bluerobotics/ping-dev-kit/ping_dev_kit_stm32h563_pinout.xlsx

Sheet: Alternate Functions
Use? | Pin Function | UFBGA169 | Net | GPIO | Additional Function | AF0 | AF1 | AF2 | AF3 | AF4 | AF5 | AF6 | AF7 | AF8 | AF9 | AF10 | AF11 | AF12 | AF13 | AF14 | AF15 | Notes
FALSE | l |  |  | - |  | - | - | - | - | - | - | - | - | - | - | - | - | - | - | - | -
TRUE | NRST | H3 | nRST | - | 0 | - | - | - | - | - | - | - | - | - | - | - | - | - | - | - | -
FALSE | PA0 | K3 |  | GPIO | ADC12_INP0, ADC12_INN1, TAMP_IN2,TAMP_OUT1, WKUP1 |  |  | TIM5_CH1 | TIM8_ETR | TIM15_BKIN | SPI6_NSS | SPI3_RDY | USART2_CTS/ USART2_NSS | UART4_TX | SDMMC2_CMD | SAI2_SD_B | ETH_MII_CRS | - | - | TIM2_ETR | EVENTOUT
TRUE | PA1 | H5 | MAC.REF_CLK | GPIO | ADC12_INP1, TAMP_IN5,TAMP_OUT4 | - | TIM2_CH2 | TIM5_CH2 | - | TIM15_CH1N | LPTIM1_IN1 | OCTOSPI1_DQS | USART2_RTS | UART4_RX | OCTOSPI1_IO3 | SAI2_MCLK_B | ETH_MII_RX_CLK/ ETH_RMII_REF_CLK | - | - | - | EVENTOUT
TRUE | PA10 | E11 | USART1.RX | GPIO | - | - | TIM1_CH3 | - | LPUART1_RX | LPTIM2_IN2 | - | UCPD1_FRSTX | USART1_RX | - | FDCAN2_TX | - | - | SDMMC1_D0 | DCMI_D1/PSSI_D1 | - | EVENTOUT
FALSE | PA11 | C13 |  | GPIO | - | - | TIM1_CH4 | - | LPUART1_CTS | - | SPI2_NSS/I2S2_WS | UART4_RX | ART1_NSS | - | FDCAN1_RX | USB_DM | - | - | - | - | EVENTOUT
FALSE | PA12 | B13 |  | GPIO | - | - | TIM1_ETR | - | LPUART1_RTS | - | SPI2_SCK/I2S2_CK | UART4_TX | USART1_RTS | SAI2_FS_B | FDCAN1_TX | USB_DP | - | - | - | - | EVENTOUT
TRUE | PA13(JTMS/SWDIO) | D12 | SWDIO | GPIO | - | JTMS/SWDIO | - | - | - | - | - | - |  | - | - | - | - | - | - | - | EVENTOUT
TRUE | PA14(JTCK/SWCLK) | C10 | SWCLK | GPIO | - | JTCK/SWCLK | - | - | - | - | - | - |  | - | - | - | - | - | - | - | EVENTOUT
FALSE | PA15(JTDI) | B10 |  | GPIO | - | JTDI | TIM2_CH1 | LPTIM3_IN2 | - | HDMI_CEC | SPI1_NSS/I2S1_WS | SPI3_NSS/I2S3_WS | SPI6_NSS | UART4_RTS | - | - | UART7_TX | FMC_NBL1 | DCMI_D11/PSSI_D11 | TIM2_ETR | EVENTOUT
TRUE | PA2 | L3 | MAC.MDIO | GPIO | ADC12_INP14, TAMP_IN4,TAMP_OUT3, WKUP2 | - | TIM2_CH3 | TIM5_CH3 | - | TIM15_CH1 | LPTIM1_IN2 | - | USART2_TX | SAI2_SCK_B | - | - | ETH_MDIO | - | - | - | EVENTOUT
TRUE | PA3 | K4 | AUX_ANALOG | GPIO | ADC12_INP15 | - | TIM2_CH4 | TIM5_CH4 | OCTOSPI1_CLK | TIM15_CH2 | SPI2_NSS/I2S2_WS | SAI1_SD_B | USART2_RX | - | - | - | ETH_MII_COL | - | - | - | EVENTOUT
TRUE | PA4 | M4 | TX_SIG | GPIO | DAC1_OUT1, ADC12_INP18 | - | - | TIM5_ETR | LPTIM2_CH1 | - | SPI1_NSS/I2S1_WS | SPI3_NSS/I2S3_WS | USART2_CK | SPI6_NSS | - | - | - | - | DCMI_HSYNC/PSSI_DE | - | EVENTOUT
TRUE | PA5 | J5 | MOTOR_VREF | GPIO | ADC12_INP19, ADC12_INN18, DAC1_OUT2 | - | TIM2_CH1 | - | TIM8_CH1N | - | SPI1_SCK/I2S1_CK | - |  | SPI6_SCK | - | - | ETH_MII_TX_EN/ ETH_RMII_TX_EN | - | PSSI_D14 | TIM2_ETR | EVENTOUT
TRUE | PA6 | N4 | VTX_SENSE | GPIO | ADC12_INP3 | - | TIM1_BKIN | TIM3_CH1 | TIM8_BKIN | - | SPI1_MISO/I2S1_SDI | OCTOSPI1_IO3 | USART11_TX | SPI6_MISO | TIM13_CH1 | - | - | - | DCMI_PIXCLK/PSSI_PDCK | - | EVENTOUT
TRUE | PA7 | K5 | MAC.CRSDV | GPIO | ADC12_INP7, ADC12_INN3 | - | TIM1_CH1N | TIM3_CH2 | TIM8_CH1N | - | SPI1_MOSI/I2S1_SDO | - | USART11_RX | SPI6_MOSI | TIM14_CH1 | OCTOSPI1_IO2 | ETH_MII_RX_DV/ ETH_RMII_CRS_DV | FMC_SDNWE | FMC_NWE | - | EVENTOUT
FALSE | PA8 | E10 |  | GPIO | - | MCO1 | TIM1_CH1 | - | TIM8_BKIN2 | I2C3_SCL | SPI1_RDY | - | USART1_CK | - | - | USB_SOF | UART7_RX | FMC_NOE | DCMI_D3/PSSI_D3 | - | EVENTOUT
TRUE | PA9 | F13 | USART1.TX | GPIO | UCPD1_DB1 | - | TIM1_CH2 | - | LPUART1_TX | I2C3_SMBA | SPI2_SCK/I2S2_CK | - | USART1_TX | - | - | - | ETH_MII_TX_ER | FMC_NWE | DCMI_D0/PSSI_D0 | - | EVENTOUT
FALSE | PB0 | N5 |  | GPIO | ADC12_INP9, ADC12_INN5 | - | TIM1_CH2N | TIM3_CH3 | TIM8_CH2N | - | - | OCTOSPI1_IO1 | USART11_CK | UART4_CTS | - | - | ETH_MII_RXD2 | - | - | LPTIM3_CH1 | EVENTOUT
FALSE | PB1 | H6 |  | GPIO | ADC12_INP5 | - | TIM1_CH3N | TIM3_CH4 | TIM8_CH3N | - | - | OCTOSPI1_IO0 | - | - | - | - | ETH_MII_RXD3 | - | - | LPTIM3_CH2 | EVENTOUT
TRUE | PB10 | K9 | MAC.RXER | GPIO | - | - | TIM2_CH3 | LPTIM3_CH1 | LPTIM2_IN1 | I2C2_SCL | SPI2_SCK/I2S2_CK | - | USART3_TX | - | OCTOSPI1_NCS | - | ETH_MII_RX_ER | - | - | - | EVENTOUT
TRUE | PB11 | L10 | MAC.TXEN | GPIO | - | - | TIM2_CH4 | - | LPTIM2_ETR | I2C2_SDA | SPI2_RDY | SPI4_RDY | USART3_RX | - | - | - | ETH_MII_TX_EN/ ETH_RMII_TX_EN | FMC_NBL1 | - | - | EVENTOUT
TRUE | PB12 | K11 | MAC.TXD0 | GPIO | - | - | TIM1_BKIN | - | OCTOSPI1_NCLK | I2C2_SDA | SPI2_NSS/I2S2_WS | UCPD1_FRSTX | USART3_CK | - | FDCAN2_RX | - | ETH_MII_TXD0/ ETH_RMII_TXD0 | - | - | UART5_RX | EVENTOUT
FALSE | PB13 | K12 |  | GPIO | UCPD1_CC1 | - | TIM1_CH1N | LPTIM3_IN1 | LPTIM2_CH1 | I2C2_SMBA | SPI2_SCK/I2S2_CK | - | USART3_CTS/USART3_NSS | - | FDCAN2_TX | - | - | SDMMC1_D0 | - | UART5_TX | EVENTOUT
FALSE | PB14 | J10 |  | GPIO | UCPD1_CC2 | - | TIM1_CH2N | TIM12_CH1 | TIM8_CH2N | USART1_TX | SPI2_MISO/I2S2_SDI | - | USART3_RTS | UART4_RTS | SDMMC2_D0 | - | - | - | - | LPTIM3_ETR | EVENTOUT
TRUE | PB15 | H10 | MAC.TXD1 | GPIO | PVD_IN | RTC_REFIN | TIM1_CH3N | TIM12_CH2 | TIM8_CH3N | USART1_RX | SPI2_MOSI/I2S2_SDO |  | USART11_CTS/USART11_NSS | UART4_CTS | SDMMC2_D1 | OCTOSPI1_CLK | ETH_MII_TXD1/ ETH_RMII_TXD1 | - | DCMI_D2/PSSI_D2 | UART5_RX | EVENTOUT
TRUE | PB2 | N6 | OCTOSPI1.DQS | GPIO | LSCO | RTC_OUT2 | - | SAI1_D1 | TIM8_CH4N | SPI1_RDY | LPTIM1_CH1 | SAI1_SD_A | SPI3_MOSI/I2S3_SDO | - | OCTOSPI1_CLK | OCTOSPI1_DQS | - | SDMMC1_CMD | LPTIM5_ETR | - | EVENTOUT
FALSE | PB3(JTDO/TRACESWO) | F6 |  | GPIO | - | JTDO/TRACESWO | TIM2_CH2 | - | - | I2C2_SDA | SPI1_SCK/I2S1_CK | SPI3_SCK/I2S3_CK | UART12_CTS/UART12_NSS | SPI6_SCK | SDMMC2_D2 | CRS_SYNC | UART7_RX | - | - | LPTIM6_ETR | EVENTOUT
FALSE | PB4(NJTRST) | A5 |  | GPIO | - | NJTRST | TIM16_BKIN | TIM3_CH1 | OCTOSPI1_CLK | LPTIM1_CH2 | SPI1_MISO/I2S1_SDI | SPI3_MISO/I2S3_SDI | SPI2_NSS/I2S2_WS | SPI6_MISO | SDMMC2_D3 | - | UART7_TX | - | DCMI_D7/PSSI_D7 | - | EVENTOUT
TRUE | PB5 | E6 | OCTOSPI1.CLK- | GPIO | - | - | TIM17_BKIN | TIM3_CH2 | OCTOSPI1_NCLK | I2C1_SMBA | SPI1_MOSI/I2S1_SDO | I2C4_SMBA | SPI3_MOSI/I2S3_SDO | SPI6_MOSI | FDCAN2_RX | - | ETH_PPS_OUT | FMC_SDCKE1 | DCMI_D10/PSSI_D10 | UART5_RX | EVENTOUT
TRUE | PB6 | C6 | FDCAN2_TX | GPIO | - | - | TIM16_CH1N | TIM4_CH1 | I3C1_SCL | I2C1_SCL | HDMI_CEC | I2C4_SCL | USART1_TX | LPUART1_TX | FDCAN2_TX | OCTOSPI1_NCS | - | FMC_SDNE1 | DCMI_D5/PSSI_D5 | UART5_TX | EVENTOUT
FALSE | PB7 | D6 |  | GPIO | WKUP5 | - | TIM17_CH1N | TIM4_CH2 | I3C1_SDA | I2C1_SDA | - | I2C4_SDA | USART1_RX | LPUART1_RX | FDCAN1_TX | SDMMC2_D5 | SDMMC2_CKIN | FMC_NL | DCMI_VSYNC/PSSI_RDY | - | EVENTOUT
TRUE | PB8 | F5 | I2C1.SCL | GPIO | - | - | TIM16_CH1 | TIM4_CH3 | I3C1_SCL | I2C1_SCL | SPI4_RDY | I2C4_SCL | SDMMC1_CKIN | UART4_RX | FDCAN1_RX | SDMMC2_D4 | ETH_MII_TXD3 | SDMMC1_D4 | DCMI_D6/PSSI_D6 | - | EVENTOUT
TRUE | PB9 | E5 | I2C1.SDA | GPIO | - | - | TIM17_CH1 | TIM4_CH4 | I3C1_SDA | I2C1_SDA | ++ | I2C4_SDA | SDMMC1_CDIR | UART4_TX | FDCAN1_TX | SDMMC2_D5 | SDMMC2_CKIN | SDMMC1_D5 | DCMI_D7/PSSI_D7 | - | EVENTOUT
TRUE | PC0 | J2 | TX_ISENSE | GPIO | ADC12_INP10 | - | TIM16_BKIN | - | - | - | - | SAI1_MCLK_A | SPI2_RDY | SAI2_FS_B | FMC_A25 | OCTOSPI1_IO7 | - | FMC_SDNWE | - | - | EVENTOUT
TRUE | PC1 | J3 | MAC.MDC | GPIO | ADC12_INP11, ADC12_INN10, TAMP_IN3,TAMP_OUT5, WKUP6 | TRACED0 | - | SAI1_D1 | - | - | SPI2_MOSI/I2S2_SDO | SAI1_SD_A | USART11_RTS | SAI2_SD_A | SDMMC2_CK | OCTOSPI1_IO4 | ETH_MDC | - | - | - | EVENTOUT
FALSE | PC10 | A10 |  | GPIO | - | - | - | LPTIM3_ETR | - | - | - | SPI3_SCK/I2S3_CK | USART3_TX | UART4_TX | OCTOSPI1_IO1- | - | ETH_MII_TXD0/ ETH_RMII_TXD0 | SDMMC1_D2 | DCMI_D8/PSSI_D8 | - | EVENTOUT
FALSE | PC11 | A9 |  | GPIO | - | - | - | LPTIM3_IN1 | - | - | - | SPI3_MISO/I2S3_SDI | USART3_RX | UART4_RX | OCTOSPI1_NCS | - | - | SDMMC1_D3 | DCMI_D4/PSSI_D4 | - | EVENTOUT
FALSE | PC12 | D9 |  | GPIO | - | TRACED3 | - | TIM15_CH1 | - | - | SPI6_SCK | SPI3_MOSI/I2S3_SDO | USART3_CK | UART5_TX | - | - | - | SDMMC1_CK | DCMI_D9/PSSI_D9 | - | EVENTOUT
FALSE | PC13 | E3 |  | GPIO | TAMP_IN1,TAMP_OUT2,RTC_OUT1,TAMP_OUT3, WKUP4, RTC_TS | - | - | - | - | - | - | - | - | - | - | - | - | - | - | - | EVENTOUT
FALSE | PC14(OSC32_IN) | D1 |  | GPIO | OSC32_IN | - | - | - | - | - | - | - | - | - | - | - | - | - | - | - | EVENTOUT
FALSE | PC15(OSC32_OUT) | E1 |  | GPIO | OSC32_OUT | - | - | - | - | - | - | - | - | - | - | - | - | - | - | - | EVENTOUT
FALSE | PC2 | K1 |  | GPIO | ADC12_INP12, ADC12_INN11 | PWR_CSLEEP | TIM17_CH1 | TIM4_CH4 | - | - | SPI2_MISO/I2S2_SDI | OCTOSPI1_IO5 | - | - | OCTOSPI1_IO2 | - | ETH_MII_TXD2 | FMC_SDNE0 | - | - | EVENTOUT
FALSE | PC3 | K2 |  | GPIO | ADC12_INP13, ADC12_INN12 | PWR_CSTOP | - | SAI1_D3 | LPTIM3_CH1 | - | SPI2_MOSI/I2S2_SDO | OCTOSPI1_IO6 | - | - | OCTOSPI1_IO0 | - | ETH_MII_TX_CLK | FMC_SDCKE0 | - | - | EVENTOUT
TRUE | PC4 | L5 | MAC.RXD0 | GPIO | ADC12_INP4 | - | TIM2_CH4 | SAI1_CK1 | LPTIM2_ETR | - | I2S1_MCK | - | USART3_RX | - | - |  | ETH_MII_RXD0/ ETH_RMII_RXD0 | FMC_SDNE0 | - | - | EVENTOUT
TRUE | PC5 | M5 | MAC.RXD1 | GPIO | ADC12_INP8, ADC12_INN4 | - | TIM1_CH4N | SAI1_D3 | - | PSSI_D15 | - | SAI1_FS_A | UART12_RTS | - | - | OCTOSPI1_DQS | ETH_MII_RXD1/ ETH_RMII_RXD1 | FMC_SDCKE0 | - | - | EVENTOUT
FALSE | PC6 | F10 |  | GPIO | - | - | - | TIM3_CH1 | TIM8_CH1 | - | I2S2_MCK | SAI1_SCK_A | USART6_TX | SDMMC1_D0DIR | FMC_NWAIT | SDMMC2_D6 | OCTOSPI1_IO5 | SDMMC1_D6 | DCMI_D0/PSSI_D0 | - | EVENTOUT
FALSE | PC7 | F11 |  | GPIO | - | TRGIO | - | TIM3_CH2 | TIM8_CH2 | - | - | I2S3_MCK | USART6_RX | SDMMC1_D123DIR | FMC_NE1 | SDMMC2_D7 | OCTOSPI1_IO6 | SDMMC1_D7 | DCMI_D1/PSSI_D1 | - | EVENTOUT
TRUE | PC8 | E9 | FDCAN_STB | GPIO | - | TRACED1 | - | TIM3_CH3 | TIM8_CH3 | - | - | - | USART6_CK | UART5_RTS | FMC_NE2/FMC_NCE | FMC_INT | FMC_ALE | SDMMC1_D0 | DCMI_D2/PSSI_D2 | - | EVENTOUT
TRUE | PC9 | F12 | MAC_REF_CLK | GPIO | UCPD1_DB2 | MCO2 | - | TIM3_CH4 | TIM8_CH4 | I2C3_SDA | AUDIOCLK | - | - | UART5_CTS | OCTOSPI1_IO0 | - | FMC_CLE | SDMMC1_D1 | DCMI_D3/PSSI_D3 | - | EVENTOUT
TRUE | PD0 | C9 | AUX | GPIO | - | - | - | - | TIM8_CH4N | - | - | - | - | UART4_RX | FDCAN1_RX | - | UART9_CTS | FMC_D2/FMC_AD2 | - | - | EVENTOUT
TRUE | PD1 | B9 | TX_2X_ATT | GPIO | - | - | - | - | - | - | - | - | - | UART4_TX | FDCAN1_TX | - | - | FMC_D3/FMC_AD3 | - | - | EVENTOUT
FALSE | PD10 | K13 |  | GPIO | - | - | - | - | LPTIM2_CH2 | - | - | - | USART3_CK | - | - | - | - | FMC_D15/FMC_AD15 | - | - | EVENTOUT
FALSE | PD11 | H8 |  | GPIO | - | - | - | SAI1_CK1 | LPTIM2_IN2 | I2C4_SMBA | - | - | USART3_CTS/USART3_NSS | UART4_RX | OCTOSPI1_IO0 | SAI2_SD_A | - | FMC_A16/FMC_CLE | - | - | EVENTOUT
TRUE | PD12 | H11 | TX_PWM_A | GPIO | - | - | LPTIM1_IN1 | TIM4_CH1 | LPTIM2_IN1 | I2C4_SCL | I3C1_SCL | SAI1_D1 | USART3_RTS | UART4_TX | OCTOSPI1_IO1 | SAI2_FS_A | - | FMC_A17/FMC_ALE | DCMI_D12/PSSI_D12 | - | EVENTOUT
FALSE | PD13 | G8 |  | GPIO | - | - | LPTIM1_CH1 | TIM4_CH2 | LPTIM2_CH1 | I2C4_SDA | I3C1_SDA | - | - | - | OCTOSPI1_IO3 | SAI2_SCK_A | UART9_RTS | FMC_A18 | DCMI_D13/PSSI_D13 | LPTIM4_IN1 | EVENTOUT
TRUE | PD14 | H12 | TX_PWM_B | GPIO | - | - | - | TIM4_CH3 | - | - | - | - | - | UART8_CTS | - | - | UART9_RX | FMC_D0/FMC_AD0 | - | - | EVENTOUT
TRUE | PD15 | G10 | TGC_RST | GPIO | - | - | - | TIM4_CH4 | - | - | - | - | - | UART8_RTS | - | - | UART9_TX | FMC_D1/FMC_AD1 | - | - | EVENTOUT
TRUE | PD2 | E8 | TX_EN | GPIO | WKUP7 | TRACED2 | - | TIM3_ETR | - | TIM15_BKIN | - | - | - | UART5_RX | - | - | - | SDMMC1_CMD | DCMI_D11/PSSI_D11 | LPTIM4_ETR | EVENTOUT
TRUE | PD3 | C8 | TX_10X_ATT | GPIO | WKUP8 | - | - | - | - | - | SPI2_SCK/I2S2_CK | - | USART2_CTS/USART2_NSS | - | - | - | - | FMC_CLK | DCMI_D5/PSSI_D5 | - | EVENTOUT
TRUE | PD4 | D8 | TX_DAMP | GPIO | - | - | - | - | - | - | - | - | USART2_RTS | - | - | OCTOSPI1_IO4 | - | FMC_NOE | - | - | EVENTOUT
FALSE | PD5 | A7 |  | GPIO | - | - | TIM1_CH4N | - | - | - | SPI2_RDY | - | USART2_TX | - | FDCAN1_TX | OCTOSPI1_IO5 | - | FMC_NWE | - | - | EVENTOUT
FALSE | PD6 | F7 |  | GPIO | - | - | - | SAI1_D1 | - | - | SPI3_MOSI/I2S3_SDO | SAI1_SD_A | USART2_RX | - | - | OCTOSPI1_IO6 | SDMMC2_CK | FMC_NWAIT | DCMI_D10/PSSI_D10 | - | EVENTOUT
FALSE | PD7 | B7 |  | GPIO | - | - | - | - | - | - | SPI1_MOSI/I2S1_SDO | - | USART2_CK | - | - | OCTOSPI1_IO7 | SDMMC2_CMD | FMC_NE1/FMC_NCE | - | LPTIM4_OUT | EVENTOUT
FALSE | PD8 | J11 |  | GPIO | - | - | - | - | - | - | - | - | USART3_TX | - | - | - | - | FMC_D13/FMC_AD13 | - | - | EVENTOUT
TRUE | PD9 | H9 | FDCAN2_RX | GPIO | - | - | - | - | - | - | - | - | USART3_RX | - | FDCAN2_RX | - | - | FMC_D14/FMC_AD14 | - | - | EVENTOUT
FALSE | PE0 | D5 |  | GPIO | - | - | LPTIM1_ETR | TIM4_ETR | LPTIM2_CH2 | LPTIM2_ETR | - | SPI3_RDY | - | UART8_RX | FDCAN1_RX | SAI2_MCLK_A | - | FMC_NBL0 | DCMI_D2/PSSI_D2 | - | EVENTOUT
FALSE | PE1 | C5 |  | GPIO | - | - | LPTIM1_IN2 | - | - | - | - | - | - | UART8_TX | FDCAN1_TX | - | - | FMC_NBL1 | DCMI_D3/PSSI_D3 | - | EVENTOUT
TRUE | PE10 | L8 | OCTOSPI1.IO7 | GPIO | - | - | TIM1_CH2N | - | - | - | - | UART12_TX | UART7_CTS | - | - | OCTOSPI1_IO7 | - | FMC_D7/FMC_AD7 | - | - | EVENTOUT
TRUE | PE11 | M8 | OCTOSPI1.NCS | GPIO | - | - | TIM1_CH2 | - | - | SPI1_RDY | SPI4_NSS | OCTOSPI1_NCS | - | - | - | SAI2_SD_B | - | FMC_D8/FMC_AD8 | - | - | EVENTOUT
TRUE | PE12 | M9 | OCTOSPI1.RST | GPIO | - | - | TIM1_CH3N | - | - | - | SPI4_SCK | - | - | - | - | SAI2_SCK_B | - | FMC_D9/FMC_AD9 | - | - | EVENTOUT
FALSE | PE13 | K8 |  | GPIO | - | - | TIM1_CH3 | - | - | - | SPI4_MISO | - | - | - | - | SAI2_FS_B- | - | FMC_D10/FMC_AD10 | - | - | EVENTOUT
FALSE | PE14 | J9 |  | GPIO | - | - | TIM1_CH4 | - | - | - | SPI4_MOSI | - | - | - | - | SAI2_MCLK_B- | - | FMC_D11/FMC_AD11 | - | - | EVENTOUT
FALSE | PE15 | L9 |  | GPIO | - | - | TIM1_BKIN | - | TIM1_CH4N | - | - | - | USART10_CK | - | - | - | - | FMC_D12/FMC_AD12 | - | - | EVENTOUT
TRUE | PE2 | C3 | OCTOSPI1.IO2 | GPIO | - | TRACECLK | LPTIM1_IN2 | SAI1_CK1 | - | - | SPI4_SCK | SAI1_MCLK_A | USART10_RX | UART8_TX | OCTOSPI1_IO2 | - | ETH_MII_TXD3 | FMC_A23 | DCMI_D3/PSSI_D3 | - | EVENTOUT
FALSE | PE3 | D4 |  | GPIO | TAMP_IN6,TAMP_OUT3 | TRACED0 | - | - | - | TIM15_BKIN | - | SAI1_SD_B | USART10_TX | - | - | - | - | FMC_A19 | - | - | EVENTOUT
FALSE | PE4 | D3 |  | GPIO | TAMP_IN7,TAMP_OUT8 | TRACED1 | - | SAI1_D2 | - | TIM15_CH1N | SPI4_NSS | SAI1_FS_A | - | - | - | - | - | FMC_A20 | DCMI_D4/PSSI_D4 | - | EVENTOUT
FALSE | PE5 | C2 |  | GPIO | TAMP_IN8,TAMP_OUT7 | TRACED2 | - | SAI1_CK2 | - | TIM15_CH1 | SPI4_MISO | SAI1_SCK_A | - | - | - | - | - | FMC_A21 | DCMI_D6/PSSI_D6 | - | EVENTOUT
FALSE | PE6 | D2 |  | GPIO | TAMP_IN3,TAMP_OUT6 | TRACED3 | TIM1_BKIN2 | SAI1_D1 | - | TIM15_CH2 | SPI4_MOSI | SAI1_SD_A | - | - | - | SAI2_MCLK_B | - | FMC_A22 | DCMI_D7/PSSI_D7 | - | EVENTOUT
FALSE | PE7 | L7 |  | GPIO | - | - | TIM1_ETR | - | - | - | - | UART12_RTS | UART7_RX | - | - | OCTOSPI1_IO4 | - | FMC_D4/FMC_AD4 | - | - | EVENTOUT
TRUE | PE8 | J8 | OCTOSPI1.IO5 | GPIO | - | - | TIM1_CH1N | - | - | - | - | UART12_CTS/UART12_NSS | UART7_TX | - | - | OCTOSPI1_IO5 | - | FMC_D5/FMC_AD5 | - | - | EVENTOUT
TRUE | PE9 | N8 | OCTOSPI1.IO6 | GPIO | - | - | TIM1_CH1 | - | - | - | - | UART12_RX | UART7_RTS | - | - | OCTOSPI1_IO6 | - | FMC_D6/FMC_AD6 | - | - | EVENTOUT
FALSE | PF0 | E2 |  | GPIO | - | - | - | - | - | I2C2_SDA | - | - | - | - | - | - | - | FMC_A0 | LPTIM5_CH1 | - | EVENTOUT
FALSE | PF1 | F3 |  | GPIO | - | - | - | - | - | I2C2_SCL | - | - | - | - | - | - | - | FMC_A1 | LPTIM5_CH2 | - | EVENTOUT
TRUE | PF10 | H4 | OCTOSPI1.CLK+ | GPIO | - | - | TIM16_BKIN | SAI1_D3 | - | PSSI_D15 | - | - | - | - | OCTOSPI1_CLK | - | - | - | DCMI_D11/PSSI_D11 | - | EVENTOUT
TRUE | PF11 | J6 | VSENSE | GPIO | ADC1_INP2 | - | - | - | - | - | SPI5_MOSI | - | - | - | OCTOSPI1_NCLK | SAI2_SD_B | - | FMC_NRAS | DCMI_D12/PSSI_D12 | LPTIM6_CH1 | EVENTOUT
TRUE | PF12 | K6 | VTHERM | GPIO | ADC1_INP6, ADC1_INN2 | - | - | - | - | - | - | - | - | - | - | - | - | FMC_A6 | - | LPTIM6_CH2 | EVENTOUT
TRUE | PF13 | H7 | RX_SIG | GPIO | ADC2_INP2 | - | - | - | - | I2C4_SMBA | - | - | - | - | - | - | - | FMC_A7 | - | LPTIM6_IN1 | EVENTOUT
FALSE | PF14 | L6 |  | GPIO | ADC2_INP6, ADC2_INN2 | - | - | - | - | - | - | - | - | - | - | - | - | FMC_A8 | - | LPTIM6_IN2 | EVENTOUT
FALSE | PF15 | J7 |  | GPIO | - | - | - | - | - | I2C4_SDA | I3C1_SDA | - | - | - | - | - | - | FMC_A9 | - | - | EVENTOUT
FALSE | PF2 | F4 |  | GPIO | - | - | - | LPTIM3_CH2 | LPTIM3_IN2 | I2C2_SMBA | - | UART12_TX | USART11_CK | - | - | - | - | FMC_A2 | LPTIM5_IN1 | - | EVENTOUT
FALSE | PF3 | G6 |  | GPIO | - | - | - | LPTIM3_IN1 | - | - | - | - | USART11_TX | - | - | - | - | FMC_A3 | LPTIM5_IN2 | - | EVENTOUT
FALSE | PF4 | G5 |  | GPIO | - | - | - | LPTIM3_ETR | - | - | - | - | USART11_RX | - | - | - | - | FMC_A4 | - | - | EVENTOUT
FALSE | PF5 | G3 |  | GPIO | - | - | - | LPTIM3_CH1 | - | I2C4_SCL | I3C1_SCL | UART12_RX | USART11_CTS/USART11_NSS | - | - | - | - | FMC_A5 | - | LPTIM3_IN1 | EVENTOUT
TRUE | PF6 | G7 | OCTOSPI1.IO3 | GPIO | - | - | TIM16_CH1 | - | - | - | SPI5_NSS | SAI1_SD_B | UART7_RX | - | - | OCTOSPI1_IO3 | - | - | LPTIM5_CH1 | - | EVENTOUT
TRUE | PF7 | F1 | DEBUG_LED | GPIO | - | - | TIM17_CH1 | - | - | - | SPI5_SCK | SAI1_MCLK_B | UART7_TX | - | - | OCTOSPI1_IO2 | - | - | LPTIM5_CH2 | - | EVENTOUT
TRUE | PF8 | G4 | OCTOSPI1.IO0 | GPIO | - | - | TIM16_CH1N | - | - | - | SPI5_MISO | SAI1_SCK_B | UART7_RTS | - | TIM13_CH1 | OCTOSPI1_IO0 | - | - | LPTIM5_IN1 | - | EVENTOUT
TRUE | PF9 | G2 | OCTOSPI1.IO1 | GPIO | - | - | TIM17_CH1N | - | - | - | SPI5_MOSI | SAI1_FS_B | UART7_CTS | - | TIM14_CH1 | OCTOSPI1_IO1 | - | - | LPTIM5_IN2 | - | EVENTOUT
FALSE | PG0 | M6 |  | GPIO | - | - | - | - | - | - | - | - | - | - | - | - | UART9_RX | FMC_A10 | - | LPTIM4_IN1 | EVENTOUT
FALSE | PG1 | K7 |  | GPIO | - | - | - | - | - | - | - | - | SPI2_MOSI/I2S2_SDO | - | - | - | UART9_TX | FMC_A11 | - | - | EVENTOUT
FALSE | PG10 | C7 |  | GPIO | - | - | - | - | - | - | SPI1_NSS/I2S1_WS | - | - | - | - | SAI2_SD_B | SDMMC2_D1 | FMC_NE3 | DCMI_D2/PSSI_D2 | - | EVENTOUT
FALSE | PG11 | - |  | GPIO | - | - | LPTIM1_IN2 | - | - | - | SPI1_SCK/I2S1_CK | USART10_RX | USART11_RTS | - | - | SDMMC2_D2 | ETH_MII_TX_EN/ ETH_RMII_TX_EN | - | DCMI_D3/PSSI_D3 | - | EVENTOUT
FALSE | PG12 | D7 |  | GPIO | - | - | LPTIM1_IN1 | - | - | PSSI_D15 | SPI6_MISO | USART10_TX | USART6_RTS | - | - | SDMMC2_D3 | ETH_MII_TXD1/ ETH_RMII_TXD1 | FMC_NE4 | DCMI_D11/PSSI_D11 | LPTIM5_CH1 | EVENTOUT
FALSE | PG13 | - |  | GPIO | - | TRACED0 | LPTIM1_CH1 | - | - | - | SPI6_SCK | USART10_CTS/USART10_NSS | USART6_CTS/USART6_NSS | - | - | SDMMC2_D6 | ETH_MII_TXD0/ ETH_RMII_TXD0 | FMC_A24 | LPTIM5_CH2 | - | EVENTOUT
FALSE | PG14 | - |  | GPIO | - | TRACED1 | LPTIM1_ETR | - | - | LPTIM1_CH2 | SPI6_MOSI | USART10_RTS | USART6_TX | - | OCTOSPI1_IO7 | SDMMC2_D7 | ETH_MII_TXD1/ ETH_RMII_TXD1 | FMC_A25 | LPTIM5_IN1 | - | EVENTOUT
FALSE | PG15 | B6 |  | GPIO | - | - | - | - | - | - | SPI4_RDY | USART10_CK | USART6_CTS/USART6_NSS | - | - | - | - | FMC_NCAS | DCMI_D13/PSSI_D13 | - | EVENTOUT
TRUE | PG2 | H13 | TXDSD | GPIO | - | - | - | - | TIM8_BKIN | - | - | - | UART12_RX | - | - | - | - | FMC_A12 | - | LPTIM6_ETR | EVENTOUT
TRUE | PG3 | G9 | AUX | GPIO | - | - | - | - | TIM8_BKIN2 | - | - | - | UART12_TX | - | - | - | - | FMC_A13 | LPTIM5_ETR | - | EVENTOUT
FALSE | PG4 | G11 |  | GPIO | - | - | TIM1_BKIN2 | - | - | - | - | - | - | - | - | - | - | FMC_A14/FMC_BA0 | - | LPTIM4_ETR | EVENTOUT
FALSE | PG5 | F8 |  | GPIO | - | - | TIM1_ETR | - | - | - | - | - | - | - | - | - | - | FMC_A15/FMC_BA1 | - | - | EVENTOUT
FALSE | PG6 | G12 |  | GPIO | - | - | TIM17_BKIN | - | I3C1_SDA | I2C4_SDA | SPI1_RDY | - | - | - | - | OCTOSPI1_NCS | UCPD1_FRSTX | FMC_NE3 | DCMI_D12/PSSI_D12 | - | EVENTOUT
FALSE | PG7 | F9 |  | GPIO | - | - | - | SAI1_CK2 | I3C1_SCL | I2C4_SCL | - | SAI1_MCLK_A | USART6_CK | - | - | - | UCPD1_FRSTX | FMC_INT | DCMI_D13/PSSI_D13 | - | EVENTOUT
FALSE | PG8 | G13 |  | GPIO | - | - | - | - | TIM8_ETR | - | SPI6_NSS | - | USART6_RTS | - | - | - | ETH_PPS_OUT | FMC_SDCLK | - | - | EVENTOUT
FALSE | PG9 | E7 |  | GPIO | - | - | - | - | - | - | SPI1_MISO/I2S1_SDI | - | USART6_RX | - | OCTOSPI1_IO6 | SAI2_FS_B | SDMMC2_D0 | FMC_NE2/FMC_NCE | DCMI_VSYNC/PSSI_RDY | - | EVENTOUT
TRUE | PH0(OSC_IN) | H1 | OSC_IN | - | OSC_IN | - | - | - | - | - | - | - | - | - | - | - | - | - | - | - | EVENTOUT
TRUE | PH1(OSC_OUT) | J1 | OSC_OUT | - | OSC_OUT | - | - | - | - | - | - | - | - | - | - | - | - | - | - | - | EVENTOUT
FALSE | PH10 | K10 |  | GPIO | - | - | TIM1_CH1N | TIM5_CH1 | TIM8_CH3 | I2C4_SMBA | SPI5_RDY | - | - | - | - | - | - | - | DCMI_D1/PSSI_D1 | - | EVENTOUT
TRUE | PH11 | L13 | I2C4.SCL | GPIO | - | - | TIM1_CH1 | TIM5_CH2 | TIM8_CH3N | I2C4_SCL | I3C1_SCL | - | - | - | - | - | - | - | DCMI_D2/PSSI_D2 | - | EVENTOUT
TRUE | PH12 | L12 | I2C4.SDA | GPIO | - | - | TIM1_BKIN | TIM5_CH3 | TIM8_BKIN | I2C4_SDA | I3C1_SDA | - | - | - | - | TIM8_CH4N | - | - | DCMI_D3/PSSI_D3 | - | EVENTOUT
FALSE | PH13 | C12 |  | GPIO | - | - | LPTIM1_IN2 | - | TIM8_CH1N | - | - | - | UART8_TX | UART4_TX | FDCAN1_TX | - | - | - | DCMI_D3/PSSI_D3 | - | EVENTOUT
FALSE | PH14 | D11 |  | GPIO | - | - | - | - | TIM8_CH2N | - | - | - | - | UART4_RX | FDCAN1_RX | - | - | - | DCMI_D4/PSSI_D4 | - | EVENTOUT
FALSE | PH15 | A13 |  | GPIO | - | - | - | - | TIM8_CH3N | - | - | - | - | - | - | - | - | - | DCMI_D11/PSSI_D11 | - | EVENTOUT
TRUE | PH2 | J4 | OCTOSPI1.IO4 | GPIO | - | - | LPTIM1_IN2 | - | - | - | - | - | - | - | OCTOSPI1_IO4 | SAI2_SCK_B | ETH_MII_CRS | FMC_SDCKE0 | - | - | EVENTOUT
TRUE | PH3 | N2 | VTX_EN | GPIO | - | - | - | - | - | - | - | - | - | - | OCTOSPI1_IO5 | SAI2_MCLK_B | ETH_MII_COL | FMC_SDNE0 | - | - | EVENTOUT
TRUE | PH4 | N1 |  | GPIO | - | - | - | - | - | I2C2_SCL | SPI5_RDY | - | SPI6_RDY | - | - | - | - | - | PSSI_D14 | - | EVENTOUT
TRUE | PH5 | L4 | SPI5.NSS | GPIO | - | - | - | - | - | I2C2_SDA | SPI5_NSS | - | SPI6_RDY | - | - | - | - | FMC_SDNWE | - | - | EVENTOUT
TRUE | PH6 | N13 | SPI5.SCK | GPIO | - | - | TIM1_CH3N | TIM12_CH1 | TIM8_CH1 | I2C2_SMBA | SPI5_SCK | - | - | - | - | - | ETH_MII_RXD2 | FMC_SDNE1 | DCMI_D8/PSSI_D8 | - | EVENTOUT
TRUE | PH7 | L11 | SPI5.MISO | GPIO | - | - | TIM1_CH3 | - | TIM8_CH1N | I2C3_SCL | SPI5_MISO | - | - | - | - | - | ETH_MII_RXD3 | FMC_SDCKE1 | DCMI_D9/PSSI_D9 | - | EVENTOUT
TRUE | PH8 | M12 | SPI5.MOSI | GPIO | - | - | TIM1_CH2N | TIM5_ETR | TIM8_CH2 | I2C3_SDA | SPI5_MOSI | - | - | - | - | - | - | - | DCMI_HSYNC/PSSI_DE | - | EVENTOUT
TRUE | PH9 | M13 | PHY_nRST | GPIO | - | - | TIM1_CH2 | TIM12_CH2 | TIM8_CH2N | I2C3_SMBA | SPI5_NSS | - | - | - | - | - | - | - | DCMI_D0/PSSI_D0 | - | EVENTOUT
TRUE | PI0 | B12 | MOTOR_DIR | GPIO | - | - | - | TIM5_CH4 | - | - | SPI2_NSS/I2S2_WS | - | - | - | - | - | - | - | DCMI_D13/PSSI_D13 | - | EVENTOUT
TRUE | PI1 | C11 | MOTOR_EN | GPIO | - | - | - | - | TIM8_BKIN2 | - | SPI2_SCK/I2S2_CK | - | - | - | - | - | - | - | DCMI_D8/PSSI_D8 | - | EVENTOUT
FALSE | PI10 | - |  | GPIO | - | - | - | - | - | - | - | - | - | - | FDCAN1_RX | - | ETH_MII_RX_ER | - | PSSI_D14 | - | EVENTOUT
FALSE | PI11 | - |  | GPIO | TAMP_IN4,TAMP_OUT5 | - | - | - | - | - | - | - | - | - | - | - | - | - | PSSI_D15 | - | EVENTOUT
FALSE | PI2 | D10 |  | GPIO | - | - | - | - | TIM8_CH4 | - | SPI2_MISO/I2S2_SDI | - | - | - | - | - | - | - | DCMI_D9/PSSI_D9 | - | EVENTOUT
TRUE | PI3 | A12 | MOTOR_MODE1 | GPIO | - | - | - | - | TIM8_ETR | - | SPI2_MOSI/I2S2_SDO | - | - | - | - | - | - | - | DCMI_D10/PSSI_D10 | - | EVENTOUT
TRUE | PI4 | C4 | MOTOR_MODE0 | GPIO | - | - | - | - | TIM8_BKIN | - | - | - | SPI2_RDY | - | - | SAI2_MCLK_A | - | - | DCMI_D5/PSSI_D5 | - | EVENTOUT
TRUE | PI5 | B3 | MOTOR_STEP | GPIO | - | - | - | - | TIM8_CH1 | - | - | - | - | - | - | SAI2_SCK_A | - | - | DCMI_VSYNC/PSSI_RDY | - | EVENTOUT
TRUE | PI6 | A2 | MOTOR_nFAULT | GPIO | - | - | - | - | TIM8_CH2 | - | - | - | - | - | - | SAI2_SD_A | - | - | DCMI_D6/PSSI_D6 | - | EVENTOUT
FALSE | PI7 | A1 |  | GPIO | - | - | - | - | TIM8_CH3 | - | - | - | - | - | - | SAI2_FS_A | - | - | DCMI_D7/PSSI_D7 | - | EVENTOUT
TRUE | PI8 | E4 | MOTOR_SLEEP | GPIO | TAMP_IN2,TAMP_OUT3, WKUP3, RTC_OUT2 | - | - | - | - | - | - | - | - | - | - | - | - | - | - | - | EVENTOUT
FALSE | PI9 | - |  | GPIO | - | - | - | - | - | - | - | - | - | UART4_RX | FDCAN1_RX | - | - | - | - | - | EVENTOUT

Sheet: Pinouts
Pin function | Order in Data Sheet Table 14 | Additional Function | Pin Type | I/O Structure | WLCSP80 SMPS | LQFP100 SMPS | LQFP144 SMPS | UFBGA169 SMPS | LQFP176 SMPS | UFBGA176+25 SMPS | LQFP64 | LQFP100 | LQFP144 | UFBGA169 | LQFP176 | UFBGA176+25 | VFQFPN68 | Column1
BOOT0 | 187 |  | I | B | D8 | 94 | 137 | B5 | 166 | A5 | 60 | 94 | 138 | B5 | 166 | D6 | 62
NRST | 35 |  | I/O | RST | F8 | 14 | 25 | H3 | 30 | K3 | 7 | 14 | 25 | H4 | 31 | J1 | 7 | RATS
PA0 | 46 | ADC12_INP0, ADC12_INN1, TAMP_IN2,TAMP_OUT1, WKUP1 | I/O | FT_at | K8 | 22 | 33 | K3 | 39 | P2 | 14 | 23 | 34 | J4 | 40 | N3 | 14 | RATS
PA1 | 47 | ADC12_INP1, TAMP_IN5,TAMP_OUT4 | I/O | FT_aht | J7 | 23 | 34 | H5 | 40 | L3 | 15 | 24 | 35 | J5 | 41 | N2 | 15 | RATS
PA2 | 48 | ADC12_INP14, TAMP_IN4,TAMP_OUT3, WKUP2 | I/O | FT_hat | M8 | 24 | 35 | L3 | 41 | M3 | 16 | 25 | 36 | L3 | 42 | P2 | 16
PA3 | 55 | ADC12_INP15 | I/O | FT_ah- | T10 | 25 | 36 | K4 | 44 | N5 | 17 | 26 | 37 | N3 | 47 | R2 | 17 | RATS
PA4 | 58 | DAC1_OUT1, ADC12_INP18 | I/O | TT_a- | R9 | 28 | 39 | M4 | 47 | M5 | 20 | 29 | 40 | L4 | 50 | N4 | 20 | RATS
PA5 | 59 | ADC12_INP19, ADC12_INN18, DAC1_OUT2 | I/O | TT_ah- | L7 | 29 | 40 | J5 | 48 | R3 | 21 | 30 | 41 | K4 | 51 | P4 | 21 | RATS
PA6 | 60 | ADC12_INP3 | I/O | FT_ah- | H6 | 30 | 41 | N4 | 49 | P5 | 22 | 31 | 42 | M5 | 52 | P3 | 22 | RATS
PA7 | 61 | ADC12_INP7, ADC12_INN3 | I/O | FT_ah- | K6 | 31 | 42 | K5 | 50 | R4 | 23 | 32 | 43 | K5 | 53 | R3 | 23
PA8 | 137 | - | I/O | FT_fh | G3 | 67 | 100 | E10 | 119 | F15 | 41 | 67 | 100 | F12 | 119 | F15 | 44 | RATS
PA9 | 138 | UCPD1_DB1 | I/O | FT_d | H4 | 68 | 101 | F13 | 120 | E15 | 42 | 68 | 101 | E11 | 120 | E15 | 45 | RATS
PA10 | 139 | - | I/O | FT_h | G5 | 69 | 102 | E11 | 121 | E14 | 43 | 69 | 102 | E10 | 121 | D15 | 46 | RATS
PA11 | 140 | - | I/O | FT_u | E1 | 70 | 103 | C13 | 122 | D15 | 44 | 70 | 103 | F13 | 122 | C15 | 47 | RATS
PA12 | 141 | - | I/O | FT_u | C1 | 71 | 104 | B13 | 123 | C15 | 45 | 71 | 104 | E13 | 123 | B15 | 48 | RATS
PA13(JTMS/SWDIO) | 142 | - | I/O | FT | F4 | 72 | 105 | D12 | 124 | E13 | 46 | 72 | 105 | E12 | 124 | A15 | 49 | RATS
PA14(JTCK/SWCLK) | 155 | - | I/O | FT | E3 | 76 | 109 | C10 | 137 | B13 | 49 | 76 | 109 | A12 | 137 | A14 | 52 | RATS
PA15(JTDI) | 156 | - | I/O | FT | D4 | 77 | 110 | B10 | 138 | C13 | 50 | 77 | 110 | B11 | 138 | A13 | 53 | RATS
PB0 | 65 | ADC12_INP9, ADC12_INN5 | I/O | FT_ah- | R7 | 32 | 43 | N5 | 53 | R5 | 26 | 35 | 46 | L5 | 56 | R5 | 26 | RATS
PB1 | 66 | ADC12_INP5 | I/O | FT_ah- | P6 | 33 | 44 | H6 | 54 | N6 | 27 | 36 | 47 | K6 | 57 | R4 | 27 | RATS
PB2 | 67 | LSCO | I/O | FT_ah- | L5 | 34 | 45 | N6 | 55 | P6 | 28 | 37 | 48 | L6 | 58 | M6 | 28 | RATS
PB3(JTDO/TRACESWO) | 182 | - | I/O | FT_fh | C5 | 89 | 132 | F6 | 161 | B7 | 55 | 89 | 133 | E6 | 161 | A10 | 57 | RATS
PB4(NJTRST) | 183 | - | I/O | FT_h | B6 | 90 | 133 | A5 | 162 | C7 | 56 | 90 | 134 | A6 | 162 | A9 | 58 | RATS
PB5 | 184 | - | I/O | FT_h | D6 | 91 | 134 | E6 | 163 | A6 | 57 | 91 | 135 | C6 | 163 | A6 | 59 | RATS
PB6 | 185 | - | I/O | FT_f | E7 | 92 | 135 | C6 | 164 | B6 | 58 | 92 | 136 | A5 | 164 | B6 | 60 | RATS
PB7 | 186 | WKUP5 | I/O | FT_fa | C7 | 93 | 136 | D6 | 165 | C6 | 59 | 93 | 137 | D6 | 165 | B5 | 61
PB8 | 188 | - | I/O | FT_fh | E9 | 95 | 138 | F5 | 167 | B5 | 61 | 95 | 139 | E5 | 167 | A5 | 63 | RATS
PB9 | 189 | - | I/O | FT_fh | - | 96 | 139 | E5 | 168 | A4 | - | 96 | 140 | A4 | 168 | B4 | 64 | RATS
PB10 | 88 | - | I/O | FT_f | P4 | 44 | 66 | K9 | 76 | M10 | 29 | 47 | 69 | K9 | 79 | R12 | 29
PB11 | 89 | - | I/O | FT_f | - | 45 | 67 | L10 | 77 | N12 | - | - | - | M9 | 80 | R13 | 30 | RATS
PB12 | 105 | - | I/O | FT_fh | L3 | - | - | K11 | 92 | L12 | 33 | 51 | 73 | K11 | 92 | P12 | 34
PB13 | 106 | UCPD1_CC1 | I/O | FT_c- | M2 | 52 | 74 | K12 | 93 | R15 | 34 | 52 | 74 | L11 | 93 | P13 | 35 | RATS
PB14 | 107 | UCPD1_CC2 | I/O | FT_c- | N1 | 53 | 75 | J10 | 94 | N15 | 35 | 53 | 75 | M13 | 94 | R14 | 36 | RATS
PB15 | 108 | PVD_IN | I/O | FT_h | L1 | 54 | 76 | H10 | 95 | M14 | 36 | 54 | 76 | J10 | 95 | R15 | 37 | RATS
PC0 | 36 | ADC12_INP10 | I/O | FT_a- | H8 | 15 | 26 | J2 | 31 | L1 | 8 | 15 | 26 | J1 | 32 | M2 | 8 | RATS
PC1 | 37 | ADC12_INP11, ADC12_INN10, TAMP_IN3,TAMP_OUT5, WKUP6 | I/O | FT_ah- | G7 | 16 | 27 | J3 | 32 | L2 | 9 | 16 | 27 | J2 | 33 | M3 | 9 | RATS
PC2 | 38 | ADC12_INP12, ADC12_INN11 | I/O | FT_a- | M10 | 17 | 28 | K1 | 33 | K4 | 10 | 17 | 28 | J3 | 34 | M4 | 10 | RATS
PC3 | 39 | ADC12_INP13, ADC12_INN12 | I/O | FT_a- | L9 | 18 | 29 | K2 | 34 | N3 | 11 | 18 | 29 | H5 | 35 | M5 | 11 | RATS
PC4 | 62 | ADC12_INP4 | I/O | FT_a- | M6 | - | - | L5 | 51 | N4 | 24 | 33 | 44 | N5 | 54 | N5 | 24 | RATS
PC5 | 63 | ADC12_INP8, ADC12_INN4 | I/O | FT_ah- | N7 | - | - | M5 | 52 | P4 | 25 | 34 | 45 | H6 | 55 | P5 | 25 | RATS
PC6 | 131 | - | I/O | FT_h | J3 | 63 | 96 | F10 | 115 | G14 | 37 | 63 | 96 | F9 | 115 | H15 | 40 | RATS
PC7 | 132 | - | I/O | FT_h | K4 | 64 | 97 | F11 | 116 | G13 | 38 | 64 | 97 | F10 | 116 | G15 | 41 | RATS
PC8 | 133 | - | I/O | FT_h | J5 | 65 | 98 | E9 | 117 | F14 | 39 | 65 | 98 | G12 | 117 | G14 | 42 | RATS
PC9 | 134 | UCPD1_DB2 | I/O | FT_fh | F2 | 66 | 99 | F12 | 118 | F13 | 40 | 66 | 99 | G13 | 118 | F14 | 43 | RATS
PC10 | 157 | - | I/O | FT_h | C3 | 78 | 111 | A10 | 139 | D12 | 51 | 78 | 111 | C10 | 139 | B14 | 54 | RATS
PC11 | 158 | - | I/O | FT_h | E5 | 79 | 112 | A9 | 140 | C12 | 52 | 79 | 112 | A11 | 140 | B13 | 55 | RATS
PC12 | 159 | - | I/O | FT_h | F6 | 80 | 113 | D9 | 141 | C11 | 53 | 80 | 113 | B9 | 141 | A12 | 56 | RATS
PC13 | 11 | TAMP_IN1,TAMP_OUT2,RTC_OUT1,TAMP_OUT3, WKUP4, RTC_TS | I/O | FT_t | C9 | 7 | 7 | E3 | 8 | E3 | 2 | 7 | 7 | E4 | 8 | D1 | 2 | RATS
PC14(OSC32_IN) | 13 | OSC32_IN | I/O | FT | D10 | 8 | 8 | D1 | 9 | D2 | 3 | 8 | 8 | B1 | 9 | E13 | - | RATS
PC15(OSC32_OUT) | 14 | OSC32_OUT | I/O | FT | F10 | 9 | 9 | E1 | 10 | D1 | 4 | 9 | 9 | C1 | 10 | F14 | - | RATS
PD0 | 162 | - | I/O | FT_h | A3 | 81 | 114 | C9 | 142 | B12 | - | 81 | 114 | D9 | 142 | B12 | - | RATS
PD1 | 163 | - | I/O | FT_h | B4 | 82 | 115 | B9 | 143 | A13 | - | 82 | 115 | E9 | 143 | C12 | - | RATS
PD2 | 164 | WKUP7 | I/O | FT_h | A5 | 83 | 116 | E8 | 144 | C10 | 54 | 83 | 116 | C9 | 144 | D12 | - | RATS
PD3 | 165 | WKUP8 | I/O | FT_h | - | 84 | 117 | C8 | 145 | A12 | - | 84 | 117 | A9 | 145 | D11 | - | RATS
PD4 | 166 | - | I/O | FT_h | - | 85 | 118 | D8 | 146 | B11 | - | 85 | 118 | F8 | 146 | D10 | - | RATS
PD5 | 167 | - | I/O | FT_h | - | 86 | 119 | A7 | 147 | A11 | - | 86 | 119 | D8 | 147 | C11 | - | RATS
PD6 | 170 | - | I/O | FT_sh | - | 87 | 122 | F7 | 150 | B10 | - | 87 | 122 | E8 | 150 | B11 | - | RATS
PD7 | 171 | - | I/O | FT_sh | - | 88 | 123 | B7 | 151 | A10 | - | 88 | 123 | B8 | 151 | A11 | - | RATS
PD8 | 109 | - | I/O | FT_h | - | 55 | 77 | J11 | 96 | M15 | - | 55 | 77 | L12 | 96 | P15 | - | RATS
PD9 | 111 | - | I/O | FT_h | - | 56 | 78 | H9 | 97 | L13 | - | 56 | 78 | J9 | 97 | P14 | - | RATS
PD10 | 112 | - | I/O | FT_h | - | 57 | 79 | K13 | 98 | K12 | - | 57 | 79 | J11 | 98 | N15 | - | RATS
PD11 | 113 | - | I/O | FT_h | - | 58 | 80 | H8 | 99 | L14 | - | 58 | 80 | H10 | 99 | N14 | 38 | RATS
PD12 | 114 | - | I/O | FT_fh | - | 59 | 81 | H11 | 100 | K14 | - | 59 | 81 | K12 | 100 | N13 | 39 | RATS
PD13 | 115 | - | I/O | FT_fh | - | 60 | 82 | G8 | 101 | L15 | - | 60 | 82 | K13 | 101 | M15 | - | RATS
PD14 | 118 | - | I/O | FT_h | K2 | 61 | 85 | H12 | 104 | K13 | - | 61 | 85 | H11 | 104 | M14 | - | RATS
PD15 | 119 | - | I/O | FT_h | J1 | 62 | 86 | G10 | 105 | J13 | - | 62 | 86 | H9 | 105 | L14 | - | RATS
PE0 | 190 | - | I/O | FT_h | - | 97 | 140 | D5 | 169 | C5 | - | 97 | 141 | C5 | 169 | A4 | 65 | RATS
PE1 | 191 | - | I/O | FT_h | - | - | 141 | C5 | 170 | B4 | - | - | - | D5 | 170 | A3 | - | RATS
PE2 | 1 | - | I/O | FT_h | - | 1 | 1 | C3 | 1 | D4 | - | 1 | 1 | A1 | 1 | A2 | - | RATS
PE3 | 2 | TAMP_IN6,TAMP_OUT3 | I/O | FT_h | - | 2 | 2 | D4 | 2 | B2 | - | 2 | 2 | B2 | 2 | A1 | - | RATS
PE4 | 3 | TAMP_IN7,TAMP_OUT8 | I/O | FT_h | - | 3 | 3 | D3 | 3 | C3 | - | 3 | 3 | D4 | 3 | B1 | - | RATS
PE5 | 4 | TAMP_IN8,TAMP_OUT7 | I/O | FT_h | - | 4 | 4 | C2 | 4 | D3 | - | 4 | 4 | C2 | 4 | B2 | -
PE6 | 5 | TAMP_IN3,TAMP_OUT6 | I/O | FT_h | - | 5 | 5 | D2 | 5 | C2 | - | 5 | 5 | D3 | 5 | B3 | - | RATS
PE7 | 77 | - | I/O | FT_ah- | T6 | 35 | 55 | L7 | 65 | R9 | - | 38 | 58 | N8 | 68 | R8 | - | RATS
PE8 | 78 | - | I/O | FT_ah- | N5 | 36 | 56 | J8 | 66 | P9 | - | 39 | 59 | G7 | 69 | P8 | - | RATS
PE9 | 79 | - | I/O | FT_ah- | R5 | 37 | 57 | N8 | 67 | N9 | - | 40 | 60 | L8 | 70 | P9 | - | RATS
PE10 | 82 | - | I/O | FT_ah- | M4 | 38 | 60 | L8 | 70 | R10 | - | 41 | 63 | H8 | 73 | R9 | - | RATS
PE11 | 83 | - | I/O | FT_ah- | - | 39 | 61 | M8 | 71 | P10 | - | 42 | 64 | M8 | 74 | P10 | -
PE12 | 84 | - | I/O | FT_h | - | 40 | 62 | M9 | 72 | R11 | - | 43 | 65 | K8 | 75 | R10 | - | RATS
PE13 | 85 | - | I/O | FT_h | - | 41 | 63 | K8 | 73 | P11 | - | 44 | 66 | L9 | 76 | N11 | - | RATS
PE14 | 86 | - | I/O | FT_h | - | 42 | 64 | J9 | 74 | N10 | - | 45 | 67 | J8 | 77 | P11 | - | RATS
PE15 | 87 | - | I/O | FT_h | - | 43 | 65 | L9 | 75 | N11 | - | 46 | 68 | N9 | 78 | R11 | - | RATS
PF0 | 20 | - | I/O | FT_f | - | - | 10 | E2 | 16 | F2 | - | - | 10 | F3 | 16 | E2 | - | RATS
PF1 | 21 | - | I/O | FT_f | - | - | 11 | F3 | 17 | F1 | - | - | 11 | E1 | 17 | H3 | - | RATS
PF2 | 22 | - | I/O | FT_h | - | - | 12 | F4 | 18 | G3 | - | - | 12 | F2 | 18 | H2 | - | RATS
PF3 | 23 | - | I/O | FT_h | - | - | 13 | G6 | 19 | G2 | - | - | 13 | F5 | 19 | J2 | - | RATS
PF4 | 24 | - | I/O | FT_h | - | - | 14 | G5 | 20 | G1 | - | - | 14 | F1 | 20 | J3 | - | RATS
PF5 | 25 | - | I/O | FT_fh | - | - | 15 | G3 | 21 | H3 | - | - | 15 | F6 | 21 | K3 | - | RATS
PF6 | 28 | - | I/O | FT_h | - | - | 18 | G7 | 24 | H1 | - | - | 18 | G4 | 24 | K2 | - | RATS
PF7 | 29 | - | I/O | FT_h | - | - | 19 | F1 | 25 | K2 | - | - | 19 | G3 | 25 | K1 | - | RATS
PF8 | 30 | - | I/O | FT_h | - | - | 20 | G4 | 26 | H2 | - | - | 20 | G5 | 26 | L3 | - | RATS
PF9 | 31 | - | I/O | FT_h | - | - | 21 | G2 | 27 | J3 | - | - | 21 | H3 | 27 | L2 | - | RATS
PF10 | 32 | - | I/O | FT_h | - | - | 22 | H4 | - | J4 | - | - | 22 | G6 | 28 | L1 | - | RATS
PF11 | 68 | ADC1_INP2 | I/O | FT_ah- | - | - | 46 | J6 | 56 | R6 | - | - | 49 | J6 | 59 | R6 | -
PF12 | 69 | ADC1_INP6, ADC1_INN2 | I/O | FT_ah- | - | - | 47 | K6 | 57 | N7 | - | - | 50 | N6 | 60 | P6 | - | RATS
PF13 | 72 | ADC2_INP2 | I/O | FT_ah- | - | - | 50 | H7 | 60 | P7 | - | - | 53 | H7 | 63 | N6 | -
PF14 | 73 | ADC2_INP6, ADC2_INN2 | I/O | FT_fah- | - | - | 51 | L6 | 61 | R7 | - | - | 54 | M6 | 64 | R7 | - | RATS
PF15 | 74 | - | I/O | FT_fh | - | - | 52 | J7 | 62 | N8 | - | - | 55 | J7 | 65 | P7 | -
PG0 | 75 | - | I/O | FT_h | - | - | 53 | M6 | 63 | R8 | - | - | 56 | L7 | 66 | N7 | - | RATS
PG1 | 76 | - | I/O | FT_h | - | - | 54 | K7 | 64 | P8 | - | - | 57 | K7 | 67 | M7 | -
PG2 | 122 | - | I/O | FT_h | - | - | 87 | H13 | 106 | K15 | - | - | 87 | J12 | 106 | L15 | - | RATS
PG3 | 123 | - | I/O | FT_h | - | - | 88 | G9 | 107 | H14 | - | - | 88 | G9 | 107 | K15 | -
PG4 | 124 | - | I/O | FT_h | - | - | 89 | G11 | 108 | J15 | - | - | 89 | J13 | 108 | K14 | - | RATS
PG5 | 125 | - | I/O | FT_h | - | - | 90 | F8 | 109 | H15 | - | - | 90 | G10 | 109 | K13 | - | RATS
PG6 | 126 | - | I/O | FT_fh | - | - | 91 | G12 | 110 | J14 | - | - | 91 | G11 | 110 | J15 | - | RATS
PG7 | 127 | - | I/O | FT_fh | - | - | 92 | F9 | 111 | H13 | - | - | 92 | G8 | 111 | J14 | - | RATS
PG8 | 128 | - | I/O | FT_h | - | - | 93 | G13 | 112 | G15 | - | - | 93 | F11 | 112 | H14 | - | RATS
PG9 | 173 | - | I/O | FT_sh | - | - | 124 | E7 | 152 | B9 | - | - | 124 | F7 | 152 | C10 | - | RATS
PG10 | 174 | - | I/O | FT_sh | - | - | 125 | C7 | 153 | A9 | - | - | 125 | A8 | 153 | B10 | - | RATS
PG11 | 175 | - | I/O | FT_sh | - | - | - | - | 154 | C9 | - | - | 126 | E7 | 154 | B9 | - | RATS
PG12 | 176 | - | I/O | FT_sh | - | - | 126 | D7 | 155 | B8 | - | - | 127 | C8 | 155 | B8 | - | RATS
PG13 | 177 | - | I/O | FT_sh | - | - | 127 | - | 156 | C8 | - | - | 128 | D7 | 156 | A8 | - | RATS
PG14 | 178 | - | I/O | FT_sh | - | - | 128 | - | 157 | A8 | - | - | 129 | C7 | 157 | A7 | - | RATS
PG15 | 181 | - | I/O | FT_h | - | - | 131 | B6 | 160 | A7 | - | - | 132 | B6 | 160 | B7 | -
PH0(OSC_IN) | 33 | OSC_IN | I/O | FT | K10 | 12 | 23 | H1 | 28 | J1 | 5 | 12 | 23 | H1 | 29 | G1 | 5
PH1(OSC_OUT) | 34 | OSC_OUT | I/O | FT | J9 | 13 | 24 | J1 | 29 | J2 | 6 | 13 | 24 | H2 | 30 | H1 | 6 | RATS
PH2 | 49 | - | I/O | FT_h | - | - | - | J4 | 42 | R2 | - | - | - | K3 | 43 | F4 | - | RATS
PH3 | 52 | - | I/O | FT_ah- | - | - | - | N2 | 43 | P3 | - | - | - | N2 | 44 | G4 | -
PH4 | 53 | - | I/O | FT_fa | - | - | - | N1 | - | R1 | - | - | - | N1 | 45 | H4 | -
PH5 | 54 | - | I/O | FT_fa | - | - | - | L4 | - | P1 | - | - | - | M3 | 46 | J4 | - | RATS
PH6 | 96 | - | I/O | FT- | - | - | - | N13 | 84 | P13 | - | - | - | K10 | 84 | M11 | - | RATS
PH7 | 97 | - | I/O | FT_f | - | - | - | L11 | 85 | P14 | - | - | - | L10 | 85 | N12 | - | RATS
PH8 | 98 | - | I/O | FT_fh | - | - | - | M12 | - | N13 | - | - | - | M10 | 86 | M12 | - | RATS
PH9 | 99 | - | I/O | FT_h | - | - | - | M13 | 86 | M12 | - | - | - | - | 87 | M13 | - | RATS
PH10 | 100 | - | I/O | FT_h | - | - | - | K10 | 87 | N14 | - | - | - | M11 | 88 | L13 | - | RATS
PH11 | 101 | - | I/O | FT_fh | - | - | - | L13 | 88 | P15 | - | - | - | N12 | 89 | L12 | - | RATS
PH12 | 102 | - | I/O | FT_fh | - | - | - | L12 | 89 | M13 | - | - | - | N13 | 90 | K12 | - | RATS
PH13 | 146 | - | I/O | FT_h | - | - | - | C12 | 128 | B15 | - | - | - | D12 | 128 | E12 | - | RATS
PH14 | 147 | - | I/O | FT_h | - | - | - | D11 | 129 | D13 | - | - | - | D10 | 129 | E13 | - | RATS
PH15 | 148 | - | I/O | FT_h | - | - | - | A13 | 130 | C14 | - | - | - | D11 | 130 | D13 | - | RATS
PI0 | 149 | - | I/O | FT_h | - | - | - | B12 | 131 | - | - | - | - | B13 | 131 | E14 | - | RATS
PI1 | 150 | - | I/O | FT_h | - | - | - | C11 | 132 | A15 | - | - | - | B12 | 132 | D14 | - | RATS
PI2 | 151 | - | I/O | FT_h | - | - | - | D10 | 133 | B14 | - | - | - | A13 | 133 | C14 | - | RATS
PI3 | 152 | - | I/O | FT_h | - | - | - | A12 | 134 | A14 | - | - | - | C11 | 134 | C13 | - | RATS
PI4 | 195 | - | I/O | FT_h | - | - | - | C4 | 173 | B3 | - | - | - | C4 | 173 | D4 | -
PI5 | 196 | - | I/O | FT_h | - | - | - | B3 | 174 | A2 | - | - | - | - | 174 | C4 | - | RATS
PI6 | 197 | - | I/O | FT_h | - | - | - | A2 | 175 | C4 | - | - | - | C3 | 175 | C3 | - | RATS
PI7 | 198 | - | I/O | FT_h | - | - | - | A1 | 176 | A1 | - | - | - | A2 | 176 | C2 | - | RATS
PI8 | 10 | TAMP_IN2,TAMP_OUT3, WKUP3, RTC_OUT2 | I/O | FT_t | - | - | - | E4 | 7 | E2 | - | - | - | E3 | 7 | D2 | - | RATS
PI9 | 15 | - | I/O | FT_h | - | - | - | - | 11 | E1 | - | - | - | - | 11 | D3 | -
PI10 | 16 | - | I/O | FT_h | - | - | - | - | 12 | F4 | - | - | - | - | 12 | E3 | -
PI11 | 17 | TAMP_IN4,TAMP_OUT5 | I/O | FT | - | - | - | - | 13 | F3 | - | - | - | F4 | 13 | E4 | - | RATS
VBAT | 8 |  | S | - | B10 | 6 | 6 | C1 | 6 | B1 | 1 | 6 | 6 | E2 | 6 | C1 | 1 | RATS
VCAP | 93 |  | S | - | T2 | 49 | 71 | N11 | 81 | R14 | 30 | 48 | 70 | N10 | 81 | M10 | 31 | RATS
VCAP | 192 |  | S | - | A9 | 98 | 142 | A4 | 171 | A3 | 62 | 98 | 142 | B4 | 171 | C6 | 66 | RATS
VDD | 6 |  | S | - | A1 | - | - | - | - | - | - | - | - | - | - | - | -
VDD | 19 |  | S | - | - | - | - | B1 | 15 | D5 | - | - | - | D1 | 15 | C5 | - | RATS
VDD | 27 |  | S | - | A7 | 11 | 17 | G1 | 23 | E4 | - | 11 | 17 | G1 | 23 | F3 | -
VDD | 40 |  | S | - | G1 | - | - | - | 35 | H4 | - | - | 30 | M1 | 36 | G3 | - | RATS
VDD | 50 |  | S | - | H10 | - | - | - | - | L4 | - | - | - | - | - | K4 | -
VDD | 57 |  | S | - | R1 | 27 | 38 | N3 | 46 | M6 | 19 | 28 | 39 | N4 | 49 | N8 | 19 | RATS
VDD | 64 |  | S | - | T8 | - | - | - | - | M8 | - | - | - | - | - | - | -
VDD | 71 |  | S | - | - | - | 49 | N7 | 59 | - | - | - | 52 | N7 | 62 | N9 | -
VDD | 81 |  | S | - | - | - | 59 | - | 69 | - | - | - | 62 | - | 72 | - | -
VDD | 95 |  | S | - | - | 51 | 73 | N12 | 83 | M11 | 32 | 50 | 72 | N11 | 83 | N10 | 33 | RATS
VDD | 104 |  | S | - | - | - | - | - | 91 | J12 | - | - | - | L13 | 91 | J12 | - | RATS
VDD | 117 |  | S | - | - | - | 84 | J13 | 103 | - | - | - | 84 | H13 | 103 | J13 | - | RATS
VDD | 120 |  | S | - | - | - | - | - | - | - | - | - | - | - | - | - | -
VDD | 130 |  | S | - | - | - | 95 | - | 114 | - | - | - | 95 | - | 114 | - | -
VDD | 136 |  | S | - | - | - | - | - | - | - | - | - | - | - | - | G13 | -
VDD | 144 |  | S | - | - | 75 | 108 | D13 | 127 | E12 | 48 | 75 | 108 | C13 | 127 | F13 | 51 | RATS
VDD | 154 |  | S | - | - | - | - | A8 | 136 | D8 | - | - | - | A10 | 136 | C9 | - | RATS
VDD | 161 |  | S | - | - | - | - | A11 | - | D10 | - | - | - | - | - | - | - | RATS
VDD | 180 |  | S | - | - | - | 130 | A3 | 159 | - | - | - | 131 | - | 159 | C7 | - | RATS
VDD | 194 |  | S | - | - | 100 | 144 | - | 172 | - | 64 | 100 | 144 | A3 | 172 | - | 68 | RATS
VDDA | 45 |  | S | - | P10 | 21 | 32 | M1 | 38 | M1 | 13 | 22 | 33 | L1 | 39 | R1 | 13 | RATS
VDDIO2 | 169 |  | S | - | - | - | 121 | A6 | 149 | D7 | - | - | 121 | A7 | 149 | C8 | - | RATS
VDDSMPS | 91 |  | S | - | R3 | 47 | 69 | N10 | 79 | R13 | - | - | - | - | - | - | - | RATS
VDDUSB | 145 |  | S | - | B2 | 73 | 106 | E13 | 125 | F12 | - | 73 | 106 | D13 | 125 | H13 | - | RATS
VLXSMPS | 90 |  | S | - | T4 | 46 | 68 | N9 | 78 | R12 | - | - | - | - | - | - | - | RATS
VREF- | 43 |  | S | - | - | - | - | L2 | - | N2 | - | 20 | - | K1 | - | N1 | - | RATS
VREF+ | 44 |  | S | - | - | 20 | 31 | M2 | 37 | N1 | - | 21 | 32 | L2 | 38 | P1 | - | RATS
VSS | 7 |  | S | - | B8 | - | - | - | - | - | - | - | - | - | - | - | -
VSS | 9 |  | S | - | D2 | - | - | - | - | - | - | - | - | - | - | - | -
VSS | 12 |  | S | - | G9 | - | - | - | - | - | - | - | - | - | - | - | -
VSS | 18 |  | S | - | - | - | - | B2 | 14 | C1 | - | - | - | D2 | 14 | D5 | - | RATS
VSS | 26 |  | S | - | H2 | 10 | 16 | F2 | 22 | G4 | - | 10 | 16 | G2 | 22 | F2 | - | RATS
VSS | 41 |  | S | - | P2 | - | - | H2 | - | K1 | - | - | - | M2 | - | G2 | - | RATS
VSS | 51 |  | S | - | P8 | - | - | - | - | M4 | - | - | - | - | - | L4 | -
VSS | 56 |  | S | - | - | 26 | 37 | M3 | 45 | M7 | 18 | 27 | 38 | M4 | 48 | M8 | 18 | RATS
VSS | 70 |  | S | - | - | - | 48 | M7 | 58 | - | - | - | 51 | M7 | 61 | - | -
VSS | 80 |  | S | - | - | - | 58 | - | 68 | - | - | - | 61 | - | 71 | - | -
VSS | 94 |  | S | - | - | 50 | 72 | M11 | 82 | M9 | 31 | 49 | 71 | M12 | 82 | M9 | 32 | RATS
VSS | 103 |  | S | - | - | - | - | - | 90 | H12 | - | - | - | - | - | - | -
VSS | 110 |  | S | - | - | - | - | - | - | G12 | - | - | - | - | - | - | -
VSS | 116 |  | S | - | - | - | 83 | J12 | 102 | - | - | - | 83 | H12 | 102 | H12 | - | RATS
VSS | 121 |  | S | - | - | - | - | - | - | - | - | - | - | - | - | - | -
VSS | 129 |  | S | - | - | - | 94 | - | 113 | - | - | - | 94 | - | 113 | - | -
VSS | 135 |  | S | - | - | - | - | - | - | - | - | - | - | - | - | G12 | -
VSS | 143 |  | S | - | - | 74 | 107 | E12 | 126 | D14 | 47 | 74 | 107 | C12 | 126 | F12 | 50 | RATS
VSS | 153 |  | S | - | - | - | - | B8 | 135 | D9 | - | - | - | B10 | 135 | D9 | - | RATS
VSS | 160 |  | S | - | - | - | - | B11 | - | D11 | - | - | - | - | - | - | - | RATS
VSS | 168 |  | S | - | - | - | 120 | - | 148 | - | - | - | 120 | B7 | 148 | D8 | - | RATS
VSS | 172 |  | S | - | - | - | - | - | - | D6 | - | - | - | - | - | - | -
VSS | 179 |  | S | - | - | - | 129 | B4 | 158 | - | - | - | 130 | - | 158 | D7 | - | RATS
VSS | 193 |  | S | - | - | 99 | 143 | - | - | - | 63 | 99 | 143 | B3 | - | - | 67 | RATS
VSS | 199 |  | S | - | - | - | - | - | - | F6 | - | - | - | - | - | F6 | -
VSS | 200 |  | S | - | - | - | - | - | - | F7 | - | - | - | - | - | F7 | -
VSS | 201 |  | S | - | - | - | - | - | - | F8 | - | - | - | - | - | F8 | -
VSS | 202 |  | S | - | - | - | - | - | - | F9 | - | - | - | - | - | F9 | -
VSS | 203 |  | S | - | - | - | - | - | - | F10 | - | - | - | - | - | F10 | -
VSS | 204 |  | S | - | - | - | - | - | - | G6 | - | - | - | - | - | G6 | -
VSS | 205 |  | S | - | - | - | - | - | - | G7 | - | - | - | - | - | G7 | -
VSS | 206 |  | S | - | - | - | - | - | - | G8 | - | - | - | - | - | G8 | -
VSS | 207 |  | S | - | - | - | - | - | - | G9 | - | - | - | - | - | G9 | -
VSS | 208 |  | S | - | - | - | - | - | - | G10 | - | - | - | - | - | G10 | -
VSS | 209 |  | S | - | - | - | - | - | - | H6 | - | - | - | - | - | H6 | -
VSS | 210 |  | S | - | - | - | - | - | - | H7 | - | - | - | - | - | H7 | -
VSS | 211 |  | S | - | - | - | - | - | - | H8 | - | - | - | - | - | H8 | -
VSS | 212 |  | S | - | - | - | - | - | - | H9 | - | - | - | - | - | H9 | -
VSS | 213 |  | S | - | - | - | - | - | - | H10 | - | - | - | - | - | H10 | -
VSS | 214 |  | S | - | - | - | - | - | - | J6 | - | - | - | - | - | J6 | -
VSS | 215 |  | S | - | - | - | - | - | - | J7 | - | - | - | - | - | J7 | -
VSS | 216 |  | S | - | - | - | - | - | - | J8 | - | - | - | - | - | J8 | -
VSS | 217 |  | S | - | - | - | - | - | - | J9 | - | - | - | - | - | J9 | -
VSS | 218 |  | S | - | - | - | - | - | - | J10 | - | - | - | - | - | J10 | -
VSS | 219 |  | S | - | - | - | - | - | - | K6 | - | - | - | - | - | K6 | -
VSS | 220 |  | S | - | - | -- | - | - | - | K7 | - | - | - | - | - | K7 | -
VSS | 221 |  | S | - | - | - | - | - | - | K8 | - | - | - | - | - | K8 | -
VSS | 222 |  | S | - | - | - | - | - | - | K9 | - | - | - | - | - | K9 | -
VSS | 223 |  | S | - | - | - | - | - | - | K10 | - | - | - | - | - | K10 | -
VSSA | 42 |  | S | - | N9 | 19 | 30 | L1 | 36 | M2 | 12 | 19 | 31 | K2 | 37 | M1 | 12 | RATS
VSSSMPS | 92 |  | S | - | N3 | 48 | 70 | M10 | 80 | P12 | - | - | - | - | - | - | - | RATS

Sheet: Sheet3
169 pin BGA wihtout SMPS
15
 | Pin function
A1 | PE2 | A1 | A1 | A1 | PE2 | Bidirectional | Line | Left | 38.1 mm | 71.12 mm
A2 | PI7 | A2 | A2 | A2 | PI7 | Bidirectional | Line | Right | -35.56 mm | -71.12 mm
A3 | VDD | A3 | A3 | A3 | VDD | Power input | Line | Down | -12.7 mm | -114.3 mm
A4 | PB9 | A4 | A4 | A4 | PB9 | Bidirectional | Line | Left | 38.1 mm | -40.64 mm
A5 | PB6 | A5 | A5 | A5 | PB6 | Bidirectional | Line | Left | 38.1 mm | -48.26 mm
A6 | PB4(NJTRST) | A6 | A6 | A6 | PB4(NJTRST) | Bidirectional | Line | Left | 38.1 mm | -53.34 mm
A7 | VDDIO2 | A7 | A7 | A7 | VDDIO2 | Power input | Line | Down | 17.78 mm | -114.3 mm
A8 | PG10 | A8 | A8 | A8 | PG10 | Bidirectional | Line | Right | -35.56 mm | 5.08 mm
A9 | PD3 | A9 | A9 | A9 | PD3 | Bidirectional | Line | Left | 38.1 mm | 30.48 mm
A10 | VDD | A10 | A3 | A10 | VDD | Power input | Line | Down | -10.16 mm | -114.3 mm
A11 | PC11 | A11 | A11 | A11 | PC11 | Bidirectional | Line | Left | 38.1 mm | 7.62 mm
A12 | PA14(JTCK/SWCLK) | A12 | A12 | A12 | PA14(JTCK/SWCLK) | Bidirectional | Line | Left | 38.1 mm | -71.12 mm
A13 | PI2 | A13 | A13 | A13 | PI2 | Bidirectional | Line | Right | -35.56 mm | -81.28 mm
B1 | PC14(OSC32_IN) | B1 | B1 | B1 | PC14(OSC32_IN) | Bidirectional | Line | Left | 38.1 mm | 15.24 mm
B2 | PE3 | B2 | B2 | B2 | PE3 | Bidirectional | Line | Left | 38.1 mm | 73.66 mm
B3 | VSS | B3 | B3 | B3 | VSS | Power input | Line | Up | 0 mm | 114.3 mm
B4 | VCAP | B4 | B4 | B4 | VCAP | Power output | Line | Right | -35.56 mm | 66.04 mm
B5 | BOOT0 | B5 | B5 | B5 | BOOT0 | Input | Line | Right | -35.56 mm | -101.6 mm
B6 | PG15 | B6 | B6 | B6 | PG15 | Bidirectional | Line | Right | -35.56 mm | 15.24 mm
B7 | VSS | B7 | B3 | B7 | VSS | Passive | Line | Up | 0 mm | 114.3 mm
B8 | PD7 | B8 | B8 | B8 | PD7 | Bidirectional | Line | Left | 38.1 mm | 40.64 mm
B9 | PC12 | B9 | B9 | B9 | PC12 | Bidirectional | Line | Left | 38.1 mm | 10.16 mm
B10 | VSS | B10 | B3 | B10 | VSS | Passive | Line | Up | 0 mm | 114.3 mm
B11 | PA15(JTDI) | B11 | B11 | B11 | PA15(JTDI) | Bidirectional | Line | Left | 38.1 mm | -68.58 mm
B12 | PI1 | B12 | B12 | B12 | PI1 | Bidirectional | Line | Right | -35.56 mm | -83.82 mm
B13 | PI0 | B13 | B13 | B13 | PI0 | Bidirectional | Line | Right | -35.56 mm | -86.36 mm
C1 | PC15(OSC32_OUT) | C1 | C1 | C1 | PC15(OSC32_OUT) | Bidirectional | Line | Left | 38.1 mm | 17.78 mm
C2 | PE5 | C2 | C2 | C2 | PE5 | Bidirectional | Line | Left | 38.1 mm | 78.74 mm
C3 | PI6 | C3 | C3 | C3 | PI6 | Bidirectional | Line | Right | -35.56 mm | -73.66 mm
C4 | PI4 | C4 | C4 | C4 | PI4 | Bidirectional | Line | Right | -35.56 mm | -76.2 mm
C5 | PE0 | C5 | C5 | C5 | PE0 | Bidirectional | Line | Left | 38.1 mm | 66.04 mm
C6 | PB5 | C6 | C6 | C6 | PB5 | Bidirectional | Line | Left | 38.1 mm | -50.8 mm
C7 | PG14 | C7 | C7 | C7 | PG14 | Bidirectional | Line | Right | -35.56 mm | 17.78 mm
C8 | PG12 | C8 | C8 | C8 | PG12 | Bidirectional | Line | Right | -35.56 mm | 10.16 mm
C9 | PD2 | C9 | C9 | C9 | PD2 | Bidirectional | Line | Left | 38.1 mm | 27.94 mm
C10 | PC10 | C10 | C10 | C10 | PC10 | Bidirectional | Line | Left | 38.1 mm | 5.08 mm
C11 | PI3 | C11 | C11 | C11 | PI3 | Bidirectional | Line | Right | -35.56 mm | -78.74 mm
C12 | VSS | C12 | B3 | C12 | VSS | Passive | Line | Up | 0 mm | 114.3 mm
C13 | VDD | C13 | A3 | C13 | VDD | Power input | Line | Down | -7.62 mm | -114.3 mm
D1 | VDD | D1 | A3 | D1 | VDD | Power input | Line | Down | -5.08 mm | -114.3 mm
D2 | VSS | D2 | B3 | D2 | VSS | Passive | Line | Up | 0 mm | 114.3 mm
D3 | PE6 | D3 | D3 | D3 | PE6 | Bidirectional | Line | Left | 38.1 mm | 81.28 mm
D4 | PE4 | D4 | D4 | D4 | PE4 | Bidirectional | Line | Left | 38.1 mm | 76.2 mm
D5 | PE1 | D5 | D5 | D5 | PE1 | Bidirectional | Line | Left | 38.1 mm | 68.58 mm
D6 | PB7 | D6 | D6 | D6 | PB7 | Bidirectional | Line | Left | 38.1 mm | -45.72 mm
D7 | PG13 | D7 | D7 | D7 | PG13 | Bidirectional | Line | Right | -35.56 mm | 12.7 mm
D8 | PD5 | D8 | D8 | D8 | PD5 | Bidirectional | Line | Left | 38.1 mm | 35.56 mm
D9 | PD0 | D9 | D9 | D9 | PD0 | Bidirectional | Line | Left | 38.1 mm | 22.86 mm
D10 | PH14 | D10 | D10 | D10 | PH14 | Bidirectional | Line | Right | -35.56 mm | -27.94 mm
D11 | PH15 | D11 | D11 | D11 | PH15 | Bidirectional | Line | Right | -35.56 mm | -25.4 mm
D12 | PH13 | D12 | D12 | D12 | PH13 | Bidirectional | Line | Right | -35.56 mm | -30.48 mm
D13 | VDDUSB | D13 | D13 | D13 | VDDUSB | Power input | Line | Down | 20.32 mm | -114.3 mm
E1 | PF1 | E1 | E1 | E1 | PF1 | Bidirectional | Line | Right | -35.56 mm | 25.4 mm
E2 | VBAT | E2 | E2 | E2 | VBAT | Power input | Line | Down | -15.24 mm | -114.3 mm
E3 | PI8 | E3 | E3 | E3 | PI8 | Bidirectional | Line | Right | -35.56 mm | -68.58 mm
E4 | PC13 | E4 | E4 | E4 | PC13 | Bidirectional | Line | Left | 38.1 mm | 12.7 mm
E5 | PB8 | E5 | E5 | E5 | PB8 | Bidirectional | Line | Left | 38.1 mm | -43.18 mm
E6 | PB3(JTDO/TRACESWO) | E6 | E6 | E6 | PB3(JTDO/TRACESWO) | Bidirectional | Line | Left | 38.1 mm | -55.88 mm
E7 | PG11 | E7 | E7 | E7 | PG11 | Bidirectional | Line | Right | -35.56 mm | 7.62 mm
E8 | PD6 | E8 | E8 | E8 | PD6 | Bidirectional | Line | Left | 38.1 mm | 38.1 mm
E9 | PD1 | E9 | E9 | E9 | PD1 | Bidirectional | Line | Left | 38.1 mm | 25.4 mm
E10 | PA10 | E10 | E10 | E10 | PA10 | Bidirectional | Line | Left | 38.1 mm | -81.28 mm
E11 | PA9 | E11 | E11 | E11 | PA9 | Bidirectional | Line | Left | 38.1 mm | -83.82 mm
E12 | PA13(JTMS/SWDIO) | E12 | E12 | E12 | PA13(JTMS/SWDIO) | Bidirectional | Line | Left | 38.1 mm | -73.66 mm
E13 | PA12 | E13 | E13 | E13 | PA12 | Bidirectional | Line | Left | 38.1 mm | -76.2 mm
F1 | PF4 | F1 | F1 | F1 | PF4 | Bidirectional | Line | Right | -35.56 mm | 33.02 mm
F2 | PF2 | F2 | F2 | F2 | PF2 | Bidirectional | Line | Right | -35.56 mm | 27.94 mm
F3 | PF0 | F3 | F3 | F3 | PF0 | Bidirectional | Line | Right | -35.56 mm | 22.86 mm
F4 | PI11 | F4 | F4 | F4 | PI11 | Bidirectional | Line | Right | -35.56 mm | -66.04 mm
F5 | PF3 | F5 | F5 | F5 | PF3 | Bidirectional | Line | Right | -35.56 mm | 30.48 mm
F6 | PF5 | F6 | F6 | F6 | PF5 | Bidirectional | Line | Right | -35.56 mm | 35.56 mm
F7 | PG9 | F7 | F7 | F7 | PG9 | Bidirectional | Line | Right | -35.56 mm | 2.54 mm
F8 | PD4 | F8 | F8 | F8 | PD4 | Bidirectional | Line | Left | 38.1 mm | 33.02 mm
F9 | PC6 | F9 | F9 | F9 | PC6 | Bidirectional | Line | Left | 38.1 mm | -5.08 mm
F10 | PC7 | F10 | F10 | F10 | PC7 | Bidirectional | Line | Left | 38.1 mm | -2.54 mm
F11 | PG8 | F11 | F11 | F11 | PG8 | Bidirectional | Line | Right | -35.56 mm | 0 mm
F12 | PA8 | F12 | F12 | F12 | PA8 | Bidirectional | Line | Left | 38.1 mm | -86.36 mm
F13 | PA11 | F13 | F13 | F13 | PA11 | Bidirectional | Line | Left | 38.1 mm | -78.74 mm
G1 | VDD | G1 | A3 | G1 | VDD | Power input | Line | Down | -2.54 mm | -114.3 mm
G2 | VSS | G2 | B3 | G2 | VSS | Passive | Line | Up | 0 mm | 114.3 mm
G3 | PF7 | G3 | G3 | G3 | PF7 | Bidirectional | Line | Right | -35.56 mm | 40.64 mm
G4 | PF6 | G4 | G4 | G4 | PF6 | Bidirectional | Line | Right | -35.56 mm | 38.1 mm
G5 | PF8 | G5 | G5 | G5 | PF8 | Bidirectional | Line | Right | -35.56 mm | 43.18 mm
G6 | PF10 | G6 | G6 | G6 | PF10 | Bidirectional | Line | Right | -35.56 mm | 48.26 mm
G7 | PE8 | G7 | G7 | G7 | PE8 | Bidirectional | Line | Left | 38.1 mm | 86.36 mm
G8 | PG7 | G8 | G8 | G8 | PG7 | Bidirectional | Line | Right | -35.56 mm | -2.54 mm
G9 | PG3 | G9 | G9 | G9 | PG3 | Bidirectional | Line | Right | -35.56 mm | -12.7 mm
G10 | PG5 | G10 | G10 | G10 | PG5 | Bidirectional | Line | Right | -35.56 mm | -7.62 mm
G11 | PG6 | G11 | G11 | G11 | PG6 | Bidirectional | Line | Right | -35.56 mm | -5.08 mm
G12 | PC8 | G12 | G12 | G12 | PC8 | Bidirectional | Line | Left | 38.1 mm | 0 mm
G13 | PC9 | G13 | G13 | G13 | PC9 | Bidirectional | Line | Left | 38.1 mm | 2.54 mm
H1 | PH0(OSC_IN) | H1 | H1 | H1 | PH0(OSC_IN) | Bidirectional | Line | Right | -35.56 mm | -60.96 mm
H2 | PH1(OSC_OUT) | H2 | H2 | H2 | PH1(OSC_OUT) | Bidirectional | Line | Right | -35.56 mm | -58.42 mm
H3 | PF9 | H3 | H3 | H3 | PF9 | Bidirectional | Line | Right | -35.56 mm | 45.72 mm
H4 | NRST | H4 | H4 | H4 | NRST | Input | Line | Right | -35.56 mm | -106.68 mm
H5 | PC3 | H5 | H5 | H5 | PC3 | Bidirectional | Line | Left | 38.1 mm | -12.7 mm
H6 | PC5 | H6 | H6 | H6 | PC5 | Bidirectional | Line | Left | 38.1 mm | -7.62 mm
H7 | PF13 | H7 | H7 | H7 | PF13 | Bidirectional | Line | Right | -35.56 mm | 55.88 mm
H8 | PE10 | H8 | H8 | H8 | PE10 | Bidirectional | Line | Left | 38.1 mm | 91.44 mm
H9 | PD15 | H9 | H9 | H9 | PD15 | Bidirectional | Line | Left | 38.1 mm | 60.96 mm
H10 | PD11 | H10 | H10 | H10 | PD11 | Bidirectional | Line | Left | 38.1 mm | 50.8 mm
H11 | PD14 | H11 | H11 | H11 | PD14 | Bidirectional | Line | Left | 38.1 mm | 58.42 mm
H12 | VSS | H12 | B3 | H12 | VSS | Passive | Line | Up | 0 mm | 114.3 mm
H13 | VDD | H13 | A3 | H13 | VDD | Power input | Line | Down | 0 mm | -114.3 mm
J1 | PC0 | J1 | J1 | J1 | PC0 | Bidirectional | Line | Left | 38.1 mm | -20.32 mm
J2 | PC1 | J2 | J2 | J2 | PC1 | Bidirectional | Line | Left | 38.1 mm | -17.78 mm
J3 | PC2 | J3 | J3 | J3 | PC2 | Bidirectional | Line | Left | 38.1 mm | -15.24 mm
J4 | PA0 | J4 | J4 | J4 | PA0 | Bidirectional | Line | Left | 38.1 mm | -106.68 mm
J5 | PA1 | J5 | J5 | J5 | PA1 | Bidirectional | Line | Left | 38.1 mm | -104.14 mm
J6 | PF11 | J6 | J6 | J6 | PF11 | Bidirectional | Line | Right | -35.56 mm | 50.8 mm
J7 | PF15 | J7 | J7 | J7 | PF15 | Bidirectional | Line | Right | -35.56 mm | 60.96 mm
J8 | PE14 | J8 | J8 | J8 | PE14 | Bidirectional | Line | Left | 38.1 mm | 101.6 mm
J9 | PD9 | J9 | J9 | J9 | PD9 | Bidirectional | Line | Left | 38.1 mm | 45.72 mm
J10 | PB15 | J10 | J10 | J10 | PB15 | Bidirectional | Line | Left | 38.1 mm | -25.4 mm
J11 | PD10 | J11 | J11 | J11 | PD10 | Bidirectional | Line | Left | 38.1 mm | 48.26 mm
J12 | PG2 | J12 | J12 | J12 | PG2 | Bidirectional | Line | Right | -35.56 mm | -15.24 mm
J13 | PG4 | J13 | J13 | J13 | PG4 | Bidirectional | Line | Right | -35.56 mm | -10.16 mm
K1 | VREF- | K1 | K1 | K1 | VREF- | Input | Line | Right | -35.56 mm | -91.44 mm
K2 | VSSA | K2 | K2 | K2 | VSSA | Passive | Line | Up | 2.54 mm | 114.3 mm
K3 | PH2 | K3 | K3 | K3 | PH2 | Bidirectional | Line | Right | -35.56 mm | -55.88 mm
K4 | PA5 | K4 | K4 | K4 | PA5 | Bidirectional | Line | Left | 38.1 mm | -93.98 mm
K5 | PA7 | K5 | K5 | K5 | PA7 | Bidirectional | Line | Left | 38.1 mm | -88.9 mm
K6 | PB1 | K6 | K6 | K6 | PB1 | Bidirectional | Line | Left | 38.1 mm | -60.96 mm
K7 | PG1 | K7 | K7 | K7 | PG1 | Bidirectional | Line | Right | -35.56 mm | -17.78 mm
K8 | PE12 | K8 | K8 | K8 | PE12 | Bidirectional | Line | Left | 38.1 mm | 96.52 mm
K9 | PB10 | K9 | K9 | K9 | PB10 | Bidirectional | Line | Left | 38.1 mm | -38.1 mm
K10 | PH6 | K10 | K10 | K10 | PH6 | Bidirectional | Line | Right | -35.56 mm | -45.72 mm
K11 | PB12 | K11 | K11 | K11 | PB12 | Bidirectional | Line | Left | 38.1 mm | -33.02 mm
K12 | PD12 | K12 | K12 | K12 | PD12 | Bidirectional | Line | Left | 38.1 mm | 53.34 mm
K13 | PD13 | K13 | K13 | K13 | PD13 | Bidirectional | Line | Left | 38.1 mm | 55.88 mm
L1 | VDDA | L1 | L1 | L1 | VDDA | Power input | Line | Down | 15.24 mm | -114.3 mm
L2 | VREF+ | L2 | L2 | L2 | VREF+ | Input | Line | Right | -35.56 mm | -93.98 mm
L3 | PA2 | L3 | L3 | L3 | PA2 | Bidirectional | Line | Left | 38.1 mm | -101.6 mm
L4 | PA4 | L4 | L4 | L4 | PA4 | Bidirectional | Line | Left | 38.1 mm | -96.52 mm
L5 | PB0 | L5 | L5 | L5 | PB0 | Bidirectional | Line | Left | 38.1 mm | -63.5 mm
L6 | PB2 | L6 | L6 | L6 | PB2 | Bidirectional | Line | Left | 38.1 mm | -58.42 mm
L7 | PG0 | L7 | L7 | L7 | PG0 | Bidirectional | Line | Right | -35.56 mm | -20.32 mm
L8 | PE9 | L8 | L8 | L8 | PE9 | Bidirectional | Line | Left | 38.1 mm | 88.9 mm
L9 | PE13 | L9 | L9 | L9 | PE13 | Bidirectional | Line | Left | 38.1 mm | 99.06 mm
L10 | PH7 | L10 | L10 | L10 | PH7 | Bidirectional | Line | Right | -35.56 mm | -43.18 mm
L11 | PB13 | L11 | L11 | L11 | PB13 | Bidirectional | Line | Left | 38.1 mm | -30.48 mm
L12 | PD8 | L12 | L12 | L12 | PD8 | Bidirectional | Line | Left | 38.1 mm | 43.18 mm
L13 | VDD | L13 | A3 | L13 | VDD | Power input | Line | Down | 2.54 mm | -114.3 mm
M1 | VDD | M1 | A3 | M1 | VDD | Power input | Line | Down | 5.08 mm | -114.3 mm
M2 | VSS | M2 | B3 | M2 | VSS | Passive | Line | Up | 0 mm | 114.3 mm
M3 | PH5 | M3 | M3 | M3 | PH5 | Bidirectional | Line | Right | -35.56 mm | -48.26 mm
M4 | VSS | M4 | B3 | M4 | VSS | Passive | Line | Up | 0 mm | 114.3 mm
M5 | PA6 | M5 | M5 | M5 | PA6 | Bidirectional | Line | Left | 38.1 mm | -91.44 mm
M6 | PF14 | M6 | M6 | M6 | PF14 | Bidirectional | Line | Right | -35.56 mm | 58.42 mm
M7 | VSS | M7 | B3 | M7 | VSS | Passive | Line | Up | 0 mm | 114.3 mm
M8 | PE11 | M8 | M8 | M8 | PE11 | Bidirectional | Line | Left | 38.1 mm | 93.98 mm
M9 | PB11 | M9 | M9 | M9 | PB11 | Bidirectional | Line | Left | 38.1 mm | -35.56 mm
M10 | PH8 | M10 | M10 | M10 | PH8 | Bidirectional | Line | Right | -35.56 mm | -40.64 mm
M11 | PH10 | M11 | M11 | M11 | PH10 | Bidirectional | Line | Right | -35.56 mm | -38.1 mm
M12 | VSS | M12 | B3 | M12 | VSS | Passive | Line | Up | 0 mm | 114.3 mm
M13 | PB14 | M13 | M13 | M13 | PB14 | Bidirectional | Line | Left | 38.1 mm | -27.94 mm
N1 | PH4 | N1 | N1 | N1 | PH4 | Bidirectional | Line | Right | -35.56 mm | -50.8 mm
N2 | PH3 | N2 | N2 | N2 | PH3 | Bidirectional | Line | Right | -35.56 mm | -53.34 mm
N3 | PA3 | N3 | N3 | N3 | PA3 | Bidirectional | Line | Left | 38.1 mm | -99.06 mm
N4 | VDD | N4 | A3 | N4 | VDD | Power input | Line | Down | 7.62 mm | -114.3 mm
N5 | PC4 | N5 | N5 | N5 | PC4 | Bidirectional | Line | Left | 38.1 mm | -10.16 mm
N6 | PF12 | N6 | N6 | N6 | PF12 | Bidirectional | Line | Right | -35.56 mm | 53.34 mm
N7 | VDD | N7 | A3 | N7 | VDD | Power input | Line | Down | 10.16 mm | -114.3 mm
N8 | PE7 | N8 | N8 | N8 | PE7 | Bidirectional | Line | Left | 38.1 mm | 83.82 mm
N9 | PE15 | N9 | N9 | N9 | PE15 | Bidirectional | Line | Left | 38.1 mm | 104.14 mm
N10 | VCAP | N10 | B4 | N10 | VCAP | Power input | Line | Down | 12.7 mm | -114.3 mm
N11 | VDD | N11 | A3 | N11 | VDD | Power output | Line | Right | -35.56 mm | 68.58 mm
N12 | PH11 | N12 | N12 | N12 | PH11 | Bidirectional | Line | Right | -35.56 mm | -35.56 mm
N13 | PH12 | N13 | N13 | N13 | PH12 | Bidirectional | Line | Right | -35.56 mm | -33.02 mm
