bluerobotics/ping-dev-kit/PingDevKit Stock Info.xlsx

# Boards: | 5 | <---- EDIT NUMBER OF BOARDS HERE
Project: | PingDevKit
BR Number: | BR-103907-002 RevD
Date: | 2026-09-03T09:32:24
Legend
In stock @ JLC
Low Stock @ JLC
Not Enough Stock @ JLC
Does not exist @ JLC
BRE Number | Reference | Description | Quantity/Board | Total Quantity | MPN | JLCPCB Part # | JLC Stock | Global + Consigned Stock | Alt JLC Parts | DigiKey Parts | Mouser Parts | Other Vendor Parts | Unit Cost | Cost Per Board
BRE-000010 | C101, C103, C106, C108, C411, C415, C601, C604, C606, C902, C903, C904, C1203, C1401, C1402, C1505, C1506 | 100nF 50V X7R 10% Ceramic Capacitor 0402 AEC-Q200 | 17 | 85 | GCM155R71H104KE02D | C85858 | 40823 | 14 |  | 490-10672-2-ND | 81-GCM155R71H104KE2D |  | $0.01 | $0.14
BRE-001204 | C102, C105, C801, C802, C803, C1507, C1508, C1509, C1510 | 2.2uF 100V X7T 10% Ceramic Capacitor 0805 | 9 | 45 | GRM21BD72A225KE01L | C2981733 | 2170 | 0 | C22367838 | 490-GRM21BD72A225KE01LCT-ND | 81-GRM21BD72A225KE1L |  | $0.20 | $1.80
BRE-000064 | C104, C1201, C1207 | 10uF 100V X7S 10% Ceramic Capacitor 1210 | 3 | 15 | GRM32EC72A106KE05L | C576517 | 710 | 6945 |  | 490-16266-1-ND | 81-GRM32EC72A106KE05 |  | $0.20 | $0.60
BRE-001203 | C107, C109 | 220nF 100V X7S 10% Ceramic Capacitor 0603 | 2 | 10 | HMK107C7224KAHTE | C2169715 | 476 | 0 |  | 587-5012-1-ND | 963-HMK107C7224KAHTE |  | $0.05 | $0.10
BRE-000000 | C110, C112, C201, C202, C302, C305, C306, C309, C310, C312, C313, C314, C315, C317, C318, C319, C320, C322, C323, C324, C504, C704, C707, C710, C1001, C1002 | 100nF 25V X5R 10% Ceramic Capacitor 0201 | 26 | 130 | GRM033R61E104KE14J | C76939 | 15312 | 0 | C2649540 | 490-14571-1-ND | 81-GRM033R61E104KE4J |  | $0.01 | $0.14
BRE-000020 | C111 | 1uF 50V X5R 10% Ceramic Capacitor 0402 | 1 | 5 | GRM155R61H105KE05D | C1518208 | 14607 | 193 |  | 490-GRM155R61H105KE05DCT-ND | 81-GRM155R61H105KE5D |  | $0.03 | $0.03
BRE-000052 | C203 | 22uF 25V X5R 20% Ceramic Capacitor 0805 | 1 | 5 | CC0805MKX5R8BB226 | C784585 | 3324 | 0 |  | 311-1903-1-ND | 603-CC805MKX5R8BB226 |  | $0.42 | $0.42
BRE-000036 | C204, C205, C206, C207 | 10uF 16V X5R 10% Ceramic Capacitor 0603 AEC-Q200 | 4 | 20 | GRT188R61C106KE13J | C962136 | 316 | 0 | C3888097 | 490-GRT188R61C106KE13JCT-ND | 81-GRT188R61C106KE3J |  | $0.05 | $0.19
BRE-001440 | C208, C209, C210, C211, C212, C503 | 220uF 10V 20% Electrolytic Capacitor SMD D6.3xL7.7mm | 6 | 30 | RVT1A221M0607 | C72495 | 0 | 0 |  |  |  |  | $0.00 | $0.00
BRE-000015 | C301, C307, C308, C701, C709, C1303 | 10uF 10V X5R 20% Ceramic Capacitor 0402 | 6 | 30 | CL05A106MP5NUNC | C315248 | 20590 | 4587 |  | 1276-1450-6-ND | 187-CL05A106MP5NUNC |  | $0.01 | $0.09
BRE-000009 | C303, C304 | 6pF 50V C0G 15% Ceramic Capacitor 0201 | 2 | 10 | GRM0335C1H6R0BA01D | C161434 | 430 | 0 |  | 490-11339-1-ND | 81-GRM0335C1H6R0BA1D |  | $0.0029 | $0.01
BRE-001205 | C311, C316, C321 | 4.7uF 6.3V X5R 20% Ceramic Capacitor 0201 | 3 | 15 | GRM035R60J475ME15D | C335103 | 2350 | 0 |  | 490-13230-1-ND | 81-GRM035R60J475ME5D |  | $0.03 | $0.10
BRE-001077 | C325 | 100pF 50V C0G 5% Ceramic Capacitor 0201 | 1 | 5 | GRM0335C1E101JA01D | C76917 | 19670 | 0 |  |  |  |  | $0.0024 | $0.0024
BRE-000011 | C401, C402, C406, C407 | 100pF 50V C0G 5% Ceramic Capacitor 0402 | 4 | 20 | GRM1555C1H101JA01D | C77177 | 756 | 22 |  | 490-5922-1-ND | 81-GRM1555C1H101JA1D |  | $0.01 | $0.02
BRE-001025 | C403, C404, C405, C809, C1004, C1005, C1006, C1007 | 100nF 100V X5R 20% Ceramic Capacitor 0402 | 8 | 40 | GRM155R62A104ME14D | C162178 | 1715 | 0 | C162179 | 490-10459-1-ND |  |  | $0.01 | $0.08
BRE-000035 | C408, C811, C812 | 10uF 10V X7T 10% Ceramic Capacitor 0603 | 3 | 15 | GRM188D71A106KA73D | C385037 | 1512 | 0 |  | 490-14461-1-ND | 81-GRM188D71A106KA3D |  | $0.10 | $0.30
BRE-000019 | C409, C414, C702, C703, C708, C901, C1501, C1502, C1607 | 1uF 10V X7R 10% Ceramic Capacitor 0402 | 9 | 45 | GRM155Z71A105KE01D | C528974 | 0 | 4870 | C23692972 | 490-GRM155Z71A105KE01DDKR-ND | 81-GRM155Z71A105KE1D |  | $0.05 | $0.42
BRE-000030 | C410 | 47nF 50V X7R 10% Ceramic Capacitor 0402 | 1 | 5 | GRM155R71H473KE14D | C117757 | 960 | 0 |  | 490-10702-6-ND | 81-GRM155R71H473KE4D |  | $0.01 | $0.01
BRE-000027 | C412, C413 | 3.9pF 50V C0G 3% Ceramic Capacitor 0402 | 2 | 10 | CC0402BRNPO9BN3R9 | C505474 | 980 | 0 |  | 311-1622-1-ND | 603-CC402BRNPO9BN3R9 |  | $0.01 | $0.01
BRE-001596 | C501, C502 | 1000uF 50V 20% Electrolytic Capacitor D16.5 x L16 | 2 | 10 | VZH102M1HTR-1616 | C5266058 | 0 | 0 |  |  |  |  | $0.00 | $0.00
BRE-000054 | C505, C506 | 470nF 100V X7R 10% Ceramic Capacitor 0805 | 2 | 10 | CC0805KKX7R0BB474 | C596323 | 367 | 0 |  | 13-CC0805KKX7R0BB474CT-ND | 603-CC0805KX7R0BB474 |  | $0.04 | $0.07
BRE-000033 | C602, C603, C805, C1101, C1102, C1202 | 4.7uF 10V X7T 20% Ceramic Capacitor 0402 | 6 | 30 | GRM155D71A475ME15J | C20044522 | 380 | 0 | C20044523 | 490-GRM155D71A475ME15JTR-ND | 81-GRM155D71A475ME5J |  | $0.07 | $0.40
BRE-001238 | C605 | 330nF 16V X7R 10% Ceramic Capacitor 0402 | 1 | 5 | 0402B334K160NT | C301942 | 962 | 0 |  |  |  |  | $0.02 | $0.02
BRE-000001 | C705, C706 | 10nF 25V X7R 10% Ceramic Capacitor 0201 | 2 | 10 | GRM033R71E103KE14D | C85930 | 15240 | 20 |  | 490-14454-2-ND | 81-GRM0335C1E12FA1D |  | $0.0024 | $0.0048
BRE-000060 | C711, C712 | 1nF 2kV X7R 10% Ceramic Capacitor 1206 | 2 | 10 | CC1206KKX7RDBB102 | C23631 | 2185 | 0 |  | 311-1487-1-ND | 603-CC206KKX7RDBB102 |  | $0.01 | $0.03
BRE-000049 | C804 | 1uF 100V X7S 10% Ceramic Capacitor 0805 | 1 | 5 | GRM21BC72A105KE01L | C385039 | 805 | 0 |  | 490-14464-1-ND | 81-GRM21BC72A105KE1L |  | $0.09 | $0.09
BRE-000024 | C806, C1301, C1601, C1602 | 2.2uF 10V X7R 10% Ceramic Capacitor 0402 | 4 | 20 | GRM155Z71A225KE01D | C2997286 | 3802 | 0 |  | 490-GRM155Z71A225KE01DCT-ND | 81-GRM155Z71A225KE1D |  | $0.07 | $0.26
BRE-000034 | C807, C1503, C1504 | 100nF 100V X7R 10% Ceramic Capacitor 0603 AEC-Q200 | 3 | 15 | GCJ188R72A104KA01D | C161117 | 1192 | 0 |  | 490-13420-1-ND | 81-GCJ188R72A104KA1D |  | $0.02 | $0.05
BRE-001352 | C808 | 220pF 100V C0G 5% Ceramic Capacitor 0402 | 1 | 5 | GRM1555C2A221JE01D | C1518203 | 1755 | 0 |  |  |  |  | $0.01 | $0.01
BRE-000032 | C810 | 4.7nF 100V X7R 10% Ceramic Capacitor 0402 | 1 | 5 | GRM155R72A472KA01D | C415704 | 3790 | 20 |  | 490-3885-1-ND | 81-GRM155R72A472KA01 |  | $0.0044 | $0.0044
BRE-001089 | C1003 | 4.7uF 100V X7S 10% Ceramic Capacitor 1206 | 1 | 5 | GRM31CC72A475KE11L | C237304 | 995 | 0 |  |  |  |  | $0.26 | $0.26
BRE-000012 | C1204 | 10nF 35V C0G 2% Ceramic Capacitor 0402 | 1 | 5 | GRM1555CYA103GE01D | C3834692 | 130 | 0 |  | 490-GRM1555CYA103GE01DTR-ND | 81-GRM1555CYA103GE1D |  | $0.05 | $0.05
BRE-001060 | C1205 | 2.2nF 50V X7R 10% Ceramic Capacitor 0201 | 1 | 5 | 0201B222K500NT | C80433 | 800 | 0 |  |  |  |  | $0.0011 | $0.0011
BRE-000003 | C1206 | 1uF 16V X5R 10% Ceramic Capacitor 0201 | 1 | 5 | GRM033R61C105ME15D | C335102 | 1751 | 0 |  | 490-18654-1-ND | 81-GRM033R61C105ME5D |  | $0.04 | $0.04
BRE-001222 | C1302 | 200pF 50V C0G 5% Ceramic Capacitor 0402 | 1 | 5 | CC0402JRNPO9BN201 | C325462 | 980 | 0 |  |  |  |  | $0.0044 | $0.0044
BRE-000013 | C1603, C1604 | 10nF 50V X7R 10% Ceramic Capacitor 0402 | 2 | 10 | CC0402KRX7R9BB103 | C60133 | 9930 | 4750 |  | 311-1349-1-ND | 603-CC402KRX7R9BB103 |  | $0.0022 | $0.0044
BRE-001037 | C1605 | 220nF 25V X7R 10% Ceramic Capacitor 0402 | 1 | 5 | TCC0402X7R224K250AT | C915854 | 10080 | 0 |  |  |  |  | $0.0023 | $0.0023
BRE-000022 | C1606 | 22nF 50V X7R 10% Ceramic Capacitor 0402 | 1 | 5 | GRM155R71H223KA12D | C77023 | 29135 | 0 |  | 490-3884-1-ND | 81-GRM155R71H223KA12 |  | $0.01 | $0.01
BRE-000131 | D101 | Zener Diode 10V Reverse 300 mW SOD-323 | 1 | 5 | MM3Z10VT1G | C894520 | 830 | 0 |  | MM3Z10VT1GOSCT-ND | 863-MM3Z10VT1G |  | $0.08 | $0.08
BRE-000251 | D102 | Green 525nm LED Indicator 2.8V 30mA max SMT 0603 | 1 | 5 | ORH-G36G | C286781 | 5880 | 1090 | C205443 |  |  |  | $0.01 | $0.01
BRE-001593 | D401, D402, D1001 | Dual switching diode Series Connection SOT-323-3 100V 215mA -65℃~+150℃@(Tj) 1.25V@150mA 2.5uA 200mW 6ns ROHS | 3 | 15 | LBAV99WT1G | C78879 | 0 | 0 |  |  |  |  | $0.00 | $0.00
BRE-000246 | D801, D1101 | Green 571nm LED Indicator 2V 30mA max SMT 0603 | 2 | 10 | LTST-C191KGKT | C125098 | 5143 | 0 |  | 160-1446-1-ND, 160-1446-2-ND |  |  | $0.01 | $0.02
BRE-001182 | D1201 | 60V 3A SMA Schottky Diode | 1 | 5 | B360A-13-F | C94193 | 460 | 0 |  |  |  |  | $0.07 | $0.07
BRE-000120 | D1301 | Schottky Diode 30V 1A SOD-993 | 1 | 5 | PMEG3010AESBYL | C28646369 | 485 | 0 |  | 1727-2401-2-ND | 771-PMEG3010AESBYL |  | $0.02 | $0.02
BRE-001048 | J101 | Terminal Block 2-pos Top-Entry 3.96mm Pitch Green PTH | 1 | 5 | WJ350V-3.96-2P-14-00A | C3031444 | 11 | 0 |  |  |  |  | $0.06 | $0.06
BRE-000078 | J102 | FPC Connector, Vertical, 0.5mm pitch, 6-pos | 1 | 5 | 2328702-6 | C3151647 | 976 | 3 |  | A141388CT-ND | 571-2328702-6 |  | $0.12 | $0.12
BRE-000094 | J103 | JST-GH Connector 2-pos, P=1.25mm, 1A 50V 30mΩ, 26-30awg, Vertical | 1 | 5 | BM02B-GHS-TBT | C161690 | 282 | 5898 |  | 455-BM02B-GHS-TBTCT-ND, 455-BM02B-GHS-TBTTR-ND |  |  | $0.08 | $0.08
BRE-001120 | J104, J105, J501 | Header Pin Connector 02x10 2.54mm_VERT_SMD | 3 | 15 | IPCP254M20PB28S | C6332235 | 80 | 0 | C22438450 |  |  |  | $0.08 | $0.23
BRE-001259 | J106, J109, J110, J111, J112, J114 | Header Pin 2P 01x02P 2.54mm Pitch Vertical Through Hole 3A | 6 | 30 | PZ254V-11-02P | C492401 | 1540 | 0 |  |  |  |  | $0.01 | $0.06
BRE-000096 | J107, J108 | JST-GH Connector 4-pos, P=1.25mm, 1A 50V 30mΩ, 26-30awg, Vertical | 2 | 10 | BM04B-GHS-TBT | C161692 | 5500 | 9 |  | 455-BM04B-GHS-TBTCT-ND |  |  | $0.27 | $0.55
BRE-000071 | J113 | RJ45 Receptacle Connector, Low-Profile, with LEDs, No Magnetics SMD+PTH | 1 | 5 | RC01812 | C708645 | 155 | 0 |  |  |  |  | $0.29 | $0.29
BRE-001444 | J115 | JST-PA Connector 2-pos, P = 2mm, 3A 250V, Vertical, Surface Mount, White | 1 | 5 | BM02B-PASS-TFT(LF)(SN) | C265372 | 190 | 0 |  |  |  |  | $0.24 | $0.24
BRE-001271 | J116 | 1x2P 8A 130V 2.54mm Screw Terminal Through Hole | 1 | 5 | KF128-2.54-2P | C474920 | 75 | 0 |  |  |  |  | $0.11 | $0.11
BRE-001260 | J403, J601, J1001 | Header Socket 01x02 2.54mm Vertical PTH | 3 | 15 | MF254V-11-02-0743 | C2889984 | 452 | 0 |  |  |  |  | $0.03 | $0.10
BRE-001285 | J404 | Header Pin Connector 02x03 2.54mm (0.100") Vertical SMD | 1 | 5 | IPCP254M06PB28S | C22438447 | 495 | 0 |  |  |  |  | $0.02 | $0.02
BRE-001165 | L301 | 2.2uH 20% 2.7Asat 2.0Adc 135mR Molded Power Inductor SMT 0805 | 1 | 5 | HCTC-201210-2R2-M | C54350326 | 86 | 0 |  |  |  |  | $0.04 | $0.04
BRE-001232 | L801 | 10uH 20% 10A 20.7mR Shielded Molded Inductor SMT 13.5x12.6x6.3mm | 1 | 5 | XR1265-100M | C5339467 | 45 | 0 |  | 553-4029-1-ND | 673-PA4343.103ANLT |  | $0.20 | $0.20
BRE-001065 | L1101 | 3.3uH 20% 1.6A-DC 1.8A-sat 180mR Molded Power Inductor SMT 0805 package | 1 | 5 | XRTC201212S3R3MBCA | C39846694 | 356 | 12 |  |  |  |  | $0.05 | $0.05
BRE-000234 | L1201 | 10uH 20% 8A 33mR Shielded Power Inductor SMT 7.9x7.3x5.4mm | 1 | 5 | SRP7050WA-100M | C19947697 | 0 | 630 |  | 118-SRP7050WA-100MCT-ND | 652-SRP7050WA-100M |  | $1.16 | $1.16
BRE-000220 | L1301 | 4.7uH 20% 1.6A 175mR Shielded Molded Inductor SMT 1008 package | 1 | 5 | AWP 252012FW-4R7M | C17225812 | 131 | 0 |  | 4816-AWP252012FW-4R7MCT-ND, 4816-AWP252012FW-4R7MTR-ND |  |  | $0.03 | $0.03
BRE-000414 | Q101 | P-Ch MOSFET 60 V 6.6A (Ta) 1.2W (Ta) 25mR Logic Level SO-8 | 1 | 5 | DMP6023LSS-13 | C154911 | 230 | 2713 |  | DMP6023LSS-13DICT-ND | 621-DMP6023LSS-13 |  | $0.21 | $0.21
BRE-001168 | Q501 | NPN BJT 65V 100mA 265mW 100MHz SOT-723 | 1 | 5 | BC846BM3 | C7528934 | 1695 | 5 |  |  |  |  | $0.01 | $0.01
BRE-001597 | Q502, Q503 | 2N-Ch MOSFET 100V 3A 200mR 1.67W SOT23-6 | 2 | 10 | FDC3601N-TP | C7603340 | 0 | 0 |  |  |  |  | $0.00 | $0.00
BRE-000401 | Q1001 | NPN BJT 40V 200mA 150mW 300MHz SOT-323 | 1 | 5 | MMBT3904WT1G | C58011 | 0 | 0 |  | MMBT3904WT1GOSCT-ND, MMBT3904WT1GOSTR-ND |  |  | $0.00 | $0.00
BRE-000278 | R101, R201, R203 | 47k 1% 200ppm 50mW Thick Film Resistor 0201 | 3 | 15 | RC0201FR-0747KL | C138139 | 8675 | 0 |  | 311-47KMCT-ND | 603-RC0201FR-0747KL |  | $0.0021 | $0.01
BRE-000275 | R102, R202, R204 | 3k 1% 200ppm 50mW Chip Resistor 0201 | 3 | 15 | RC0201FR-073KL | C142016 | 8878 | 20 |  | YAG2656CT-ND | 603-RC0201FR-073KL |  | $0.0017 | $0.01
BRE-000261 | R103, R302, R1003, R1006 | 10k 1% 200ppm 50mW Thick Film Resistor 0201 | 4 | 20 | RC0201FR-0710KL | C106225 | 10680 | 16 |  | 311-10.0KMCT-ND | 603-RC0201FR-0710KL |  | $0.0021 | $0.01
BRE-000311 | R105, R106, R401, R402, R406, R407, R408, R409, R414, R415, R416, R417, R418, R1402 | 1k 1% 100ppm 62.5mW Thick Film Resistor 0402 | 14 | 70 | RC0402FR-071KL | C106235 | 10765 | 0 |  | 311-1.00KLRCT-ND, 311-1.00KLRTR-ND |  |  | $0.0028 | $0.04
BRE-001225 | R205, R805, R806, R1501, R1502, R1503, R1504 | 2.2R 1% 200ppm 62.5mW Thick Film Resistor 0402 | 7 | 35 | RC0402FR-072R2L | C327251 | 10305 | 0 |  | 311-2.20LRCT-ND | 603-RC0402FR-072R2L |  | $0.0025 | $0.02
BRE-000368 | R206 | 73.2k 1% 100ppm 62.5mW Thick Film Resistor 0402 | 1 | 5 | RC0402FR-0773K2L | C185398 | 0 | 0 |  | YAG3226CT-ND, YAG3226TR-ND |  |  | $0.00 | $0.00
BRE-000292 | R207, R209, R303, R304, R305, R306, R501, R502, R503, R504, R505, R506, R508, R511, R519, R520, R521, R802, R1016, R1017, R1505, R1604 | 10k 1% 100ppm 62.5mW Thick Film Resistor 0402 | 22 | 110 | AC0402FR-0710KL | C144807 | 955 | 13970 |  | YAG3436CT-ND, YAG3436TR-ND |  |  | $0.0011 | $0.02
BRE-000330 | R208 | 31.6k 1% 100ppm 62.5mW Thick Film Resistor 0402 | 1 | 5 | RC0402FR-0731K6L | C324948 | 5960 | 30 | C276265 | YAG3115CT-ND, YAG3115TR-ND |  |  | $0.0007 | $0.0007
BRE-000291 | R301 | 10R 1% 200ppm 62.5mW Thick Film Resistor 0402 | 1 | 5 | AC0402FR-0710RL | C144805 | 9625 | 0 |  | YAG3438CT-ND | 603-AC0402FR-0710RL |  | $0.0028 | $0.0028
BRE-001213 | R403, R1401 | 100R 1% 100ppm 62.5mW Thick Film Resistor 0402 | 2 | 10 | RC0402FR-07100RL | C106232 | 9925 | 0 |  | 311-100LRCT-ND | 603-RC0402FR-07100RL |  | $0.0028 | $0.01
BRE-000342 | R404, R405 | 470R 1% 100ppm 62.5mW Thick Film Resistor 0402 | 2 | 10 | RC0402FR-07470RL | C114877 | 7401 | 0 |  | 311-470LRCT-ND, 311-470LRTR-ND |  |  | $0.0008 | $0.0016
BRE-000310 | R410 | 1R 1% 200ppm 62.5mW Thick Film Resistor 0402 | 1 | 5 | RC0402FR-071RL | C185446 | 9390 | 0 |  | 311-1.00LRCT-ND, 311-1.00LRTR-ND |  |  | $0.0028 | $0.0028
BRE-000289 | R411, R601, R602, R1010, R1202, R1204 | 0R Jumper 62.5mW Thick Film Resistor 0402 | 6 | 30 | CR0402-J/-000GLF | C203078 | 1518 | 5 |  | CR0402-J/-000GLFCT-ND, CR0402-J/-000GLFTR-ND |  |  | $0.0017 | $0.01
BRE-000379 | R412, R413 | 0R 1% 125mW Thick Film Resistor 0402 | 2 | 10 | RC0805JR-070RL | C96345 | 0 | 0 |  | 311-0.0ARCT-ND, 311-0.0ARTR-ND |  |  | $0.00 | $0.00
BRE-001586 | R507 | 10R 0.1% 25ppm 100mW Thin Film Resistor 0603 | 1 | 5 | RT0603BRD0710RL | C861082 | 87 | 0 |  |  |  |  | $0.03 | $0.03
BRE-001172 | R509 | 20k 1% 200ppm 50mW Thick Film Resistor 0201 | 1 | 5 | RC0201FR-0720KL | C295787 | 4355 | 70 |  |  |  |  | $0.0021 | $0.0021
BRE-000324 | R510, R1015 | 2k 1% 100ppm 62.5mW Thick Film Resistor 0402 | 2 | 10 | RC0402FR-072KL | C60488 | 7438 | 0 |  | 311-2KLRCT-ND, 311-2KLRTR-ND |  |  | $0.0007 | $0.0014
BRE-001257 | R512, R513, R514, R515, R516, R517 | 100R 1% 100ppm 100mW Thick Film Resistor 0603 | 6 | 30 | FRC0603F1000TS | C2906981 | 10855 | 0 |  |  |  |  | $0.0013 | $0.01
BRE-001049 | R518 | 10mR 1% 1500ppm 250mW Thick Film Resistor 0805 | 1 | 5 | RL0805FR-7W0R01L | C326784 | 406 | 0 |  | 311-.01LUTR-ND | 603-RL0805FR-7W0R01L |  | $0.02 | $0.02
BRE-000290 | R603, R804 | 100k 1% 100ppm 62.5mW Thick Film Resistor 0402 | 2 | 10 | RC0402FR-07100KL | C60491 | 8975 | 0 |  | 311-100KLRCT-ND, 311-100KLRTR-ND |  |  | $0.0028 | $0.01
BRE-000326 | R701, R702, R703, R704, R708, R709 | 2.49k 1% 100ppm 62.5mW Thick Film Resistor 0402 | 6 | 30 | RC0402FR-072K49L | C145071 | 8160 | 0 |  | 311-2.49KLRCT-ND, 311-2.49KLRTR-ND |  |  | $0.0013 | $0.01
BRE-000327 | R705 | 30k 1% 100ppm 62.5mW Thick Film Resistor 0402 | 1 | 5 | RC0402FR-0730KL | C138008 | 9780 | 0 |  | 311-30.0KLRCT-ND, 311-30.0KLRTR-ND |  |  | $0.0025 | $0.0025
BRE-000367 | R707 | 6.49k 1% 100ppm 62.5mW Thick Film Resistor 0402 | 1 | 5 | RC0402FR-076K49L | C364360 | 960 | 0 |  | 311-6.49KLRCT-ND | 603-RC0402FR-076K49L |  | $0.0024 | $0.0024
BRE-000309 | R710, R1011, R1012, R1013, R1014 | 1M 1% 100ppm 62.5mW Thick Film Resistor 0402 | 5 | 25 | AC0402FR-071ML | C144787 | 2310 | 0 |  | YAG3450CT-ND | 603-AC0402FR-071ML |  | $0.002 | $0.01
BRE-000369 | R711, R712 | 75R 1% 100ppm 62.5mW Thick Film Resistor 0402 | 2 | 10 | RC0402FR-0775RL | C114757 | 25986 | 0 |  | 311-75.0LRCT-ND, 311-75.0LRTR-ND |  |  | $0.0015 | $0.003
BRE-000317 | R801 | 20k 1% 100ppm 62.5mW Thick Film Resistor 0402 | 1 | 5 | RC0402FR-0720KL | C93942 | 7213 | 5 |  | 311-20.0KLRCT-ND, 311-20.0KLRTR-ND |  |  | $0.0025 | $0.0025
BRE-001229 | R803, R1301 | 51k 1% 100ppm 62.5mW Thick Film Resistor 0402 | 2 | 10 | RC0402FR-0751KL | C107229 | 9940 | 0 |  | 311-51.0KLRCT-ND | 603-RC0402FR-0751KL |  | $0.0013 | $0.0026
BRE-000325 | R807 | 2.2k 1% 100ppm 62.5mW Thick Film Resistor 0402 | 1 | 5 | RC0402FR-072K2L | C114762 | 2186 | 0 |  | 311-2.20KLRCT-ND, 311-2.20KLRTR-ND |  |  | $0.0013 | $0.0013
BRE-001239 | R808 | 24.9k 1% 100ppm 62.5mW Thick Film Resistor 0402 | 1 | 5 | RC0402FR-0724K9L | C138027 | 580 | 0 |  | 311-24.9KLRCT-ND | 603-RC0402FR-0724K9L |  | $0.0025 | $0.0025
BRE-000337 | R809 | 3k 1% 100ppm 62.5mW Thick Film Resistor 0402 | 1 | 5 | RC0402FR-073KL | C137987 | 8437 | 0 |  | 311-3KLRCT-ND, 311-3KLRTR-ND |  |  | $0.0022 | $0.0022
BRE-000353 | R810 | 4.99k 1% 100ppm 62.5mW Thick Film Resistor 0402 | 1 | 5 | RC0402FR-074K99L | C137965 | 0 | 6030 |  | 311-4.99KLRCT-ND, 311-4.99KLRTR-ND |  |  | $0.0011 | $0.0011
BRE-000364 | R811 | 681R 1% 100ppm 62.5mW Thick Film Resistor 0402 | 1 | 5 | RC0402FR-07681RL | C245891 | 9960 | 0 |  | YAG2375CT-ND | 603-RC0402FR-07681RL |  | $0.0013 | $0.0013
BRE-001254 | R1001, R1002, R1004, R1005 | 1M 1% 200ppm 50mW Thick Film Resistor 0201 | 4 | 20 | RC0201FR-071ML | C295786 | 9970 | 0 |  |  |  |  | $0.0012 | $0.0048
BRE-000350 | R1007, R1008, R1009 | 4.7k 1% 100ppm 62.5mW Thick Film Resistor 0402 | 3 | 15 | RC0402FR-074K7L | C105871 | 3390 | 0 |  | 311-4.7KLRCT-ND, 311-4.7KLRTR-ND |  |  | $0.0028 | $0.01
BRE-001251 | R1101 | 1.3k 1% 100ppm 62.5mW Thick Film Resistor 0402 | 1 | 5 | RC0402FR-071K3L | C185455 | 10640 | 0 |  | YAG3036CT-ND | 603-RC0402FR-071K3L |  | $0.0013 | $0.0013
BRE-000268 | R1201 | 1k 1% 200ppm 50mW Thick Film Resistor 0201 | 1 | 5 | RC0201FR-071KL | C138165 | 8211 | 18 |  | 311-1KMCT-ND | 603-RC0201FR-071KL |  | $0.0021 | $0.0021
BRE-001180 | R1203 | 63.4k 1% 62.5mW Thick Film Resistor 0402 | 1 | 5 | RC0402FR-0763K4L | C137949 | 960 | 0 |  |  |  |  | $0.0014 | $0.0014
BRE-000333 | R1205 | 36.5k 1% 100ppm 62.5mW Thick Film Resistor 0402 | 1 | 5 | RC0402FR-0736K5L | C15011 | 0 | 6558 |  | YAG3135CT-ND, YAG3135TR-ND |  |  | $0.0013 | $0.0013
BRE-000300 | R1206 | 12.4k 1% 100ppm 62.5mW Thick Film Resistor 0402 | 1 | 5 | AC0402FR-0712K4L | C226767 | 9960 | 0 |  | YAG5256CT-ND, YAG5256TR-ND |  |  | $0.002 | $0.002
BRE-000376 | R1207 | 93.1k 1% 100ppm 62.5mW Thick Film Resistor 0402 | 1 | 5 | AC0402FR-0793K1L | C227276 | 980 | 0 |  | 13-AC0402FR-0793K1LCT-ND, 13-AC0402FR-0793K1LTR-ND |  |  | $0.002 | $0.002
BRE-001474 | R1208 | 9.1k 1% 100ppm 62.5mW Thick Film Resistor 0402 | 1 | 5 | FRC0402F9101TS | C2909390 | 9980 | 0 |  |  |  |  | $0.001 | $0.001
BRE-001235 | R1302 | 13.3k 1% 100ppm 62.5mW Thick Film Resistor 0402 | 1 | 5 | RC0402FR-0713K3L | C274352 | 9850 | 0 |  |  |  |  | $0.0008 | $0.0008
BRE-001545 | R1303 | 105k 1% 100ppm 62.5mW Thick Film Resistor 0402 | 1 | 5 | FRC0402F1053TS | C2933067 | 60 | 0 |  |  |  |  | $0.0012 | $0.0012
BRE-001148 | R1601, R1602 | 0 Ohms Jumper Chip Resistor 0603 (1608 Metric) Automotive AEC-Q200, Current Sense Metal Element | 2 | 10 | TLRZ1JTTD | C782253 | 64 | 0 |  |  |  |  | $0.40 | $0.80
BRE-001286 | R1603 | 330k 1% 100ppm 62.5mW Thick Film Resistor 0402 | 1 | 5 | RC0402FR-07330KL | C138006 | 9980 | 0 |  | 311-330KLRCT-ND | 603-RC0402FR-07330KL |  | $0.0017 | $0.0017
BRE-001219 | T101 | Pot Core Transformer Mounting Assembly 18mmx11mm | 1 | 5 | B65655B0010X000 | C26205960 | 0 | 20 |  | 495-5153-ND | 871-B65655B0010X000 |  | $0.44 | $0.44
BRE-000237 | T701 | 10/100Base-T Single Port Transformer Magnetics Module | 1 | 5 | HR641680E | C189555 | 1550 | 20 |  |  |  |  | $0.24 | $0.24
BRE-000391 | TH501 | 10k 1% 3380k NTC Thermistor 0201 | 1 | 5 | NCP03XH103F05RL | C98098 | 605 | 0 |  | 490-11806-2-ND | 81-NCP03XH103F05RL |  | $0.01 | $0.01
BRE-000074 | TP107, TP108, TP113, TP114, TP115 | Ring Test Point for Probe(s) PTH | 5 | 25 | RH-5000 | C5277086 | 937 | 0 |  |  |  |  | $0.04 | $0.21
BRE-000388 | U101 | Accelerometer X, Y, Z Axis ±2g, 4g, 8g, 16g 0.5Hz ~ 672Hz 12-LGA (2x2) | 1 | 5 | LIS2DH12TR | C110926 | 145 | 0 |  | 497-14851-1-ND | 511-LIS2DH12TR |  | $0.60 | $0.60
BRE-001601 | U201, U202 | Linear Regulator, 3.6 - 24V Input, 180mA, Adj. Output, SOT23-5 | 2 | 10 | TPL810ADJ-5TR | C5155199 | 0 | 0 |  |  |  |  | $0.00 | $0.00
BRE-001075 | U301 | ARM® Cortex®-M33 STM32H5 Microcontroller IC 32-Bit 250MHz 2MB (2M x 8) FLASH 169-UFBGA (7x7) WITH STEPDOWN SMPS, high temp: -40~125C | 1 | 5 | STM32H563AII3Q | C28992049 | 0 | 5351 |  | 497-STM32H563AII3Q-ND | 511-STM32H563AII3Q |  | $3.97 | $3.97
BRE-001224 | U401 | Dual Channel High-Voltage Protection T/R Switch | 1 | 5 | MD0100DK6-G | C623929 | 0 | 55 |  | MD0100DK6-GCT-ND |  |  | $3.51 | $3.51
BRE-001220 | U402 | Dual Channel Low-noise SOIC-8 Audio Amplifier | 1 | 5 | OPA1612AIDR | C94590 | 15 | 0 |  |  |  |  | $0.85 | $0.85
BRE-001600 | U403 | IC OPAMP DIFF 1 CIRCUIT 8VSSOP | 1 | 5 | THS4521IDGKR | C170157 | 0 | 0 |  |  |  |  | $0.00 | $0.00
BRE-001210 | U404 | 18 MHz Variable Gain Amplifier | 1 | 5 | AD8338ACPZ-R7 | C578701 | 5 | 0 |  |  |  |  | $34.94 | $34.94
BRE-001218 | U405 | Dual Operational Amplifier MSOP-8 Low Vos ROHS | 1 | 5 | WS72552M-8/TR | C717866 | 1010 | 0 |  |  |  |  | $0.13 | $0.13
BRE-001362 | U501 | Bidirectional current sense amplifier, -5V to +110V 1.1MHz 100V/V TSOT23-8 | 1 | 5 | INA296A4IDDFR | C20345449 | 0 | 0 |  |  |  |  | $0.00 | $0.00
BRE-001241 | U601, U602, U1201 | 10 Bit Digital to Analog Converter, I2C Interface, 8-WSON (2x2) | 3 | 15 | DAC53401DSGR | C1855756 | 0 | 0 |  | 296-DAC53401DSGRCT-ND | 595-DAC53401DSGR |  | $0.00 | $0.00
BRE-001264 | U603 | Analog Switch IC, 1 Circuit IC Switch 1:1, 10Ohm, 5-TSSOP | 1 | 5 | 74LVC1G66GW,125 | C97489 | 91 | 0 |  | 1727-4118-1-ND | 771-74LVC1G66GW-G |  | $0.06 | $0.06
BRE-000162 | U701 | Ethernet Interface 10/100Mbps PHY 32-VQFN (5x5) | 1 | 5 | DP83825IRMQR | C783599 | 95 | 0 |  | 296-DP83825IRMQRCT-ND | 595-DP83825IRMQR |  | $0.26 | $0.26
BRE-001217 | U801 | Buck Switching Regulator, Adjustable, 8A, 600mV~32V, 4.5V~70V, VQFN-32(6x6) | 1 | 5 | MIC28517T-E/PHA | C623943 | 0 | 610 |  | 150-MIC28517T-E/PHACT-ND | 579-MIC28517T-E/PHA | LAUNSUP: C623943 | $3.08 | $3.08
BRE-001273 | U901 | PSRAM (Pseudo SRAM) Memory IC 64Mbit HyperBus 166 MHz 36 ns 24-FBGA (6x8) | 1 | 5 | S27KL0642DPBHB023 | C5157921 | 0 | 10 |  | 448-S27KL0642DPBHB023CT-ND | 727-S27KL0642DPBHB23 |  | $4.18 | $4.18
BRE-001253 | U1001 | Dual General Purpose Amplifier RRIO 25MHz 1.5-5.5V SOT-23-8L | 1 | 5 | SL9062D | C18208632 | 193 | 0 |  |  |  |  | $0.05 | $0.05
BRE-001244 | U1002 | 2 Channel Line Driver 40V 500mA 500V/us 200MHz Class AB Output TSSOP-20 | 1 | 5 | LT1794CFE#PBF | C665306 | 0 | 5 |  | 505-LT1794CFE#PBF-ND |  | Analog Devices: LT1794CFE#PBF | $19.25 | $19.25
BRE-001063 | U1101 | Buck Converter, 3.3-6V Input; 500mA/3.3V Output, 2MHz, USON-6 (1x1.45x0.6) | 1 | 5 | TPS62237DRYR | C398923 | 136 | 10 |  |  |  |  | $0.49 | $0.49
BRE-001179 | U1202 | 4A 60V Boost/SEPIC Convertor | 1 | 5 | LT8364EDE#TRPBF | C673774 | 55 | 0 |  |  |  |  | $7.67 | $7.67
BRE-000190 | U1301 | Boost Converter, 2.7 - 14V Input, 800mA, 2.7 - 30V Output, 1.6Mhz, SOT23-5 (2.9x1.6) | 1 | 5 | LM27313XMFX/NOPB | C341750 | 45 | 0 |  | 296-35164-1-ND | 926-LM27313XMFX/NOPB |  | $0.32 | $0.32
BRE-001606 | U1401 | CAN FD Transceiver SIC +/- 70V DFN3x3-8 | 1 | 5 | SIT1042ATK/3 | C5382546 | 0 | 0 |  |  |  |  | $0.00 | $0.00
BRE-001274 | U1501, U1502 | Half Bridge Driver DC Motors, DC-DC Converters Gallium Nitride (GaN) FETs 13-WQFN-HR (3.5x5) | 2 | 10 | EPC23104ENGRT | C5448592 | 0 | 20 |  | 917-EPC23104ENGRTCT-ND |  |  | $2.56 | $5.12
BRE-001284 | U1601 | Bipolar Motor Driver Power MOSFET Step/Direction 24-VQFN (4x4) | 1 | 5 | DRV8426RGER | C1518727 | 10 | 0 |  | 296-DRV8426RGERCT-ND | 595-DRV8426RGER |  | $2.88 | $2.88
BRE-000257 | X301 | 25 MHz Crystal 8pF ±25ppm 4-SMD2016 (2x1.6) | 1 | 5 | NX2016SA-25MHZ-STD-CZS-2 | C843258 | 3185 | 0 |  |  |  |  | $0.26 | $0.26
 |  |  |  |  |  |  |  |  |  |  |  |  | Total BOM Cost: | $99.10
DNP Components
BRE Number | Reference | Description | Quantity/Board | Total Quantity | MPN | JLCPCB Part # | JLC Stock | Global + Consigned Stock | Alt JLC Parts | DigiKey Parts | Mouser Parts | Other Vendor Parts | Unit Cost | Cost Per Board
BRE-000350 | R706 | 4.7k 1% 100ppm 62.5mW Thick Film Resistor 0402 | 1 | 5 | RC0402FR-074K7L | C105871 | 3390 | 0 |  | 311-4.7KLRCT-ND, 311-4.7KLRTR-ND |  |  | $0.0028 | $0.0028
BRE-001302 | SH401 | RF Shield Shield, 2-Piece 1.000" (25.40mm) X 1.500" (38.10mm) Non-Vented Through Hole | 1 | 5 | 44-CBSA-1.0X1.5X0.4 |  | 0 | 0 |  | 1798-1027-ND | 861-44A101504 |  | $0.00 | $0.00
