bluerobotics/ping-dev-kit/BR-103907-002_RevD_PCBA_Outputs/PingDevKit_Schematic.pdf

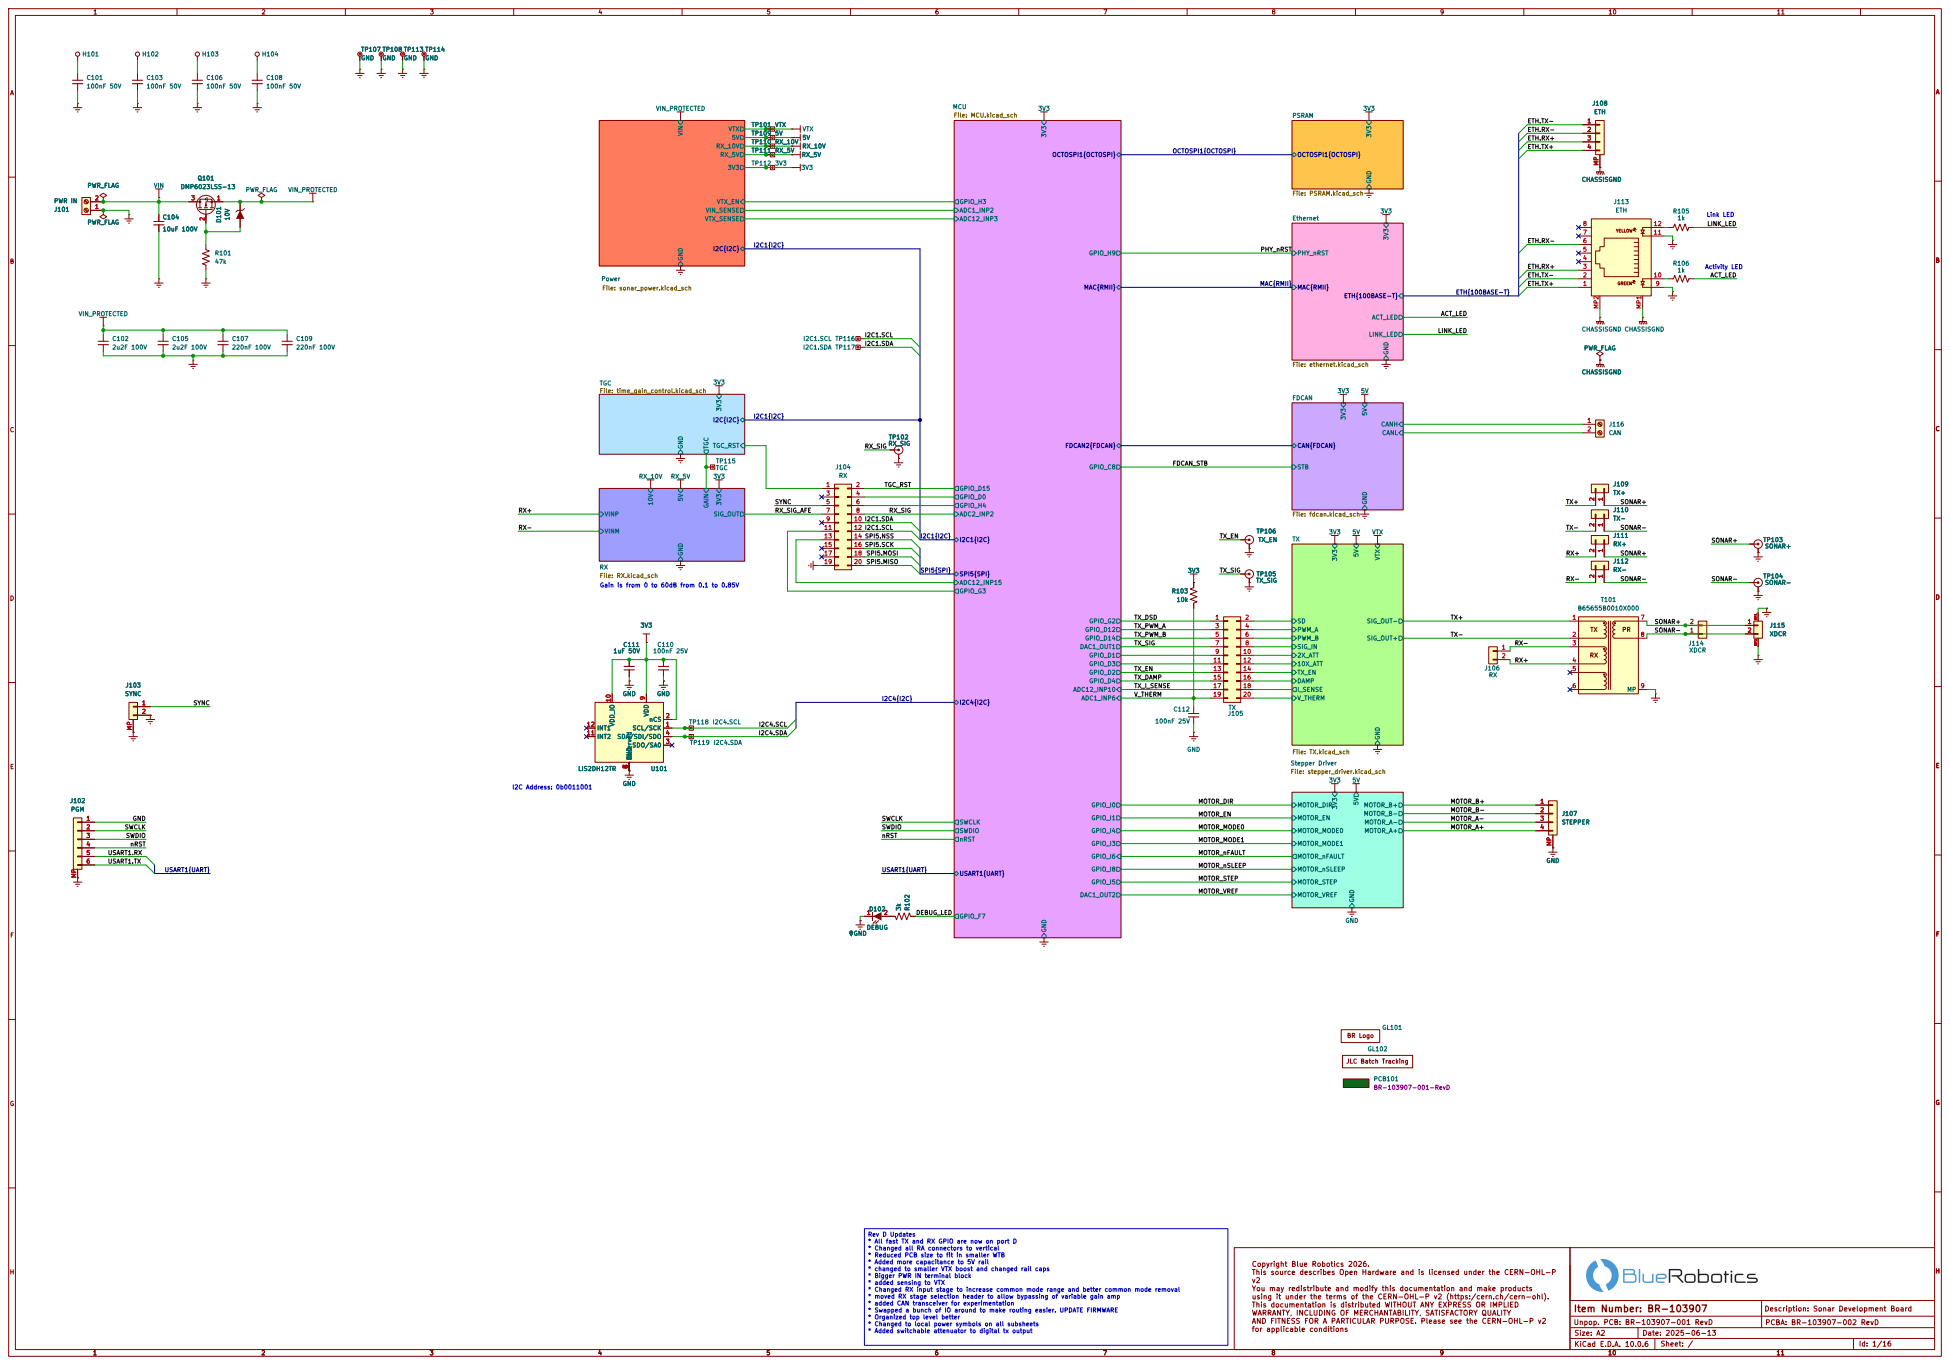
[picture p1: page 1]

VINP 5V GAIN GND 10V RX SIG_OUT VINM 3V3 | 3 5 7 | 4 I2C1.SCL SYNC

Gain is from 0 to 60dB from 0.1 to 0.85V
3V3 GND

TX_PWM_A | 3 | 4 | TX-2
TX_PWM_B | 5 | 6
TX_SIG | 7 | 8 | 3 5

9 | 10
11 | 12
13 | 14

TX_I_SENSE | 17 | 18
V_THERM | 19 | 20

Rev D Updates
* All fast TX and RX GPIO are now on port D
* Changed all RA connectors to vertical * Reduced PCB size to fit in smaller WTB

* Added more capacitance to 5V rail * changed to smaller VTX boost and changed rail caps

Copyright Blue Robotics 2026.
This source describes Open Hardware and is licensed under the CERN-OHL-P
You may redistribute and modify this documentation and make products
using it under the terms of the CERN-OHL-P v2 (https:/cern.ch/cern-ohl).
This documentation is distributed WITHOUT ANY EXPRESS OR IMPLIED
WARRANTY, INCLUDING OF MERCHANTABILITY, SATISFACTORY QUALITY
AND FITNESS FOR A PARTICULAR PURPOSE. Please see the CERN-OHL-P v2
for applicable conditions

* Bigger PWR IN terminal block
* added sensing to VTX
* Changed RX input stage to increase common mode range and better common mode removal * moved RX stage selection header to allow bypassing of variable gain amp

* added CAN transceiver for experimentation
* Swapped a bunch of IO around to make routing easier. UPDATE FIRMWARE
* Organized top level better * Changed to local power symbols on all subsheets

Item Number: BR-103907
Unpop. PCB: BR-103907-001 RevD
Size: A2
KiCad E.D.A. 10.0.6

Description: Sonar Development Board

* Added switchable attenuator to digital tx output

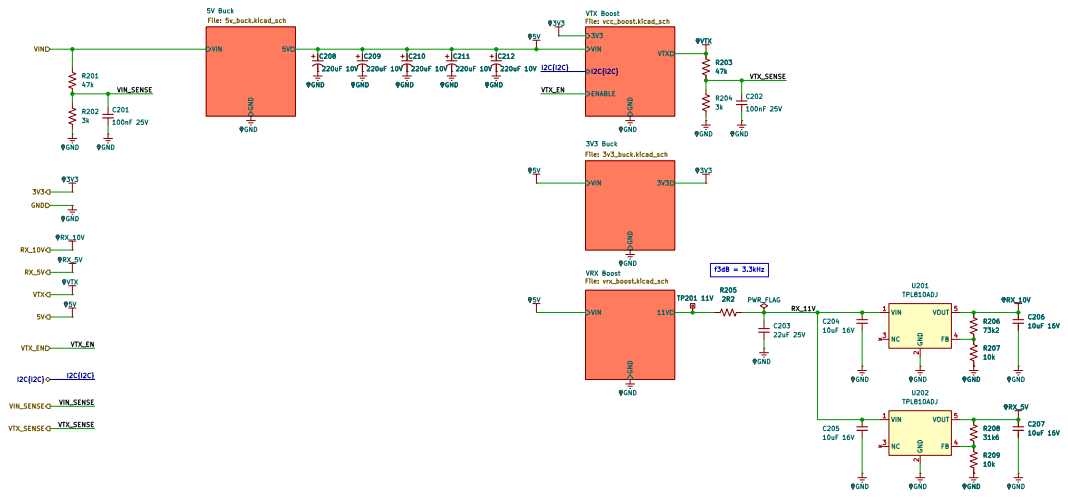
[picture p2: page 2]

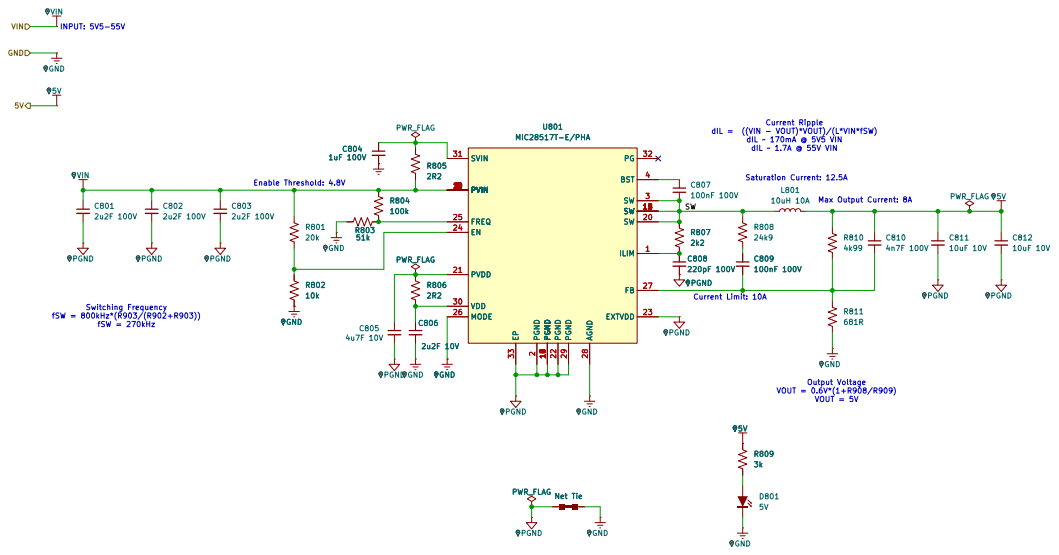
[picture p3: page 3]

VIN
Saturation Current: 12.5A Switching Frequency

VOUT = 0.6V*(1+R908/R909) VOUT = 5V Max Output Current: 8A Current Limit: 10A PWR_FLAG
10uH 10A PWR_FLAG

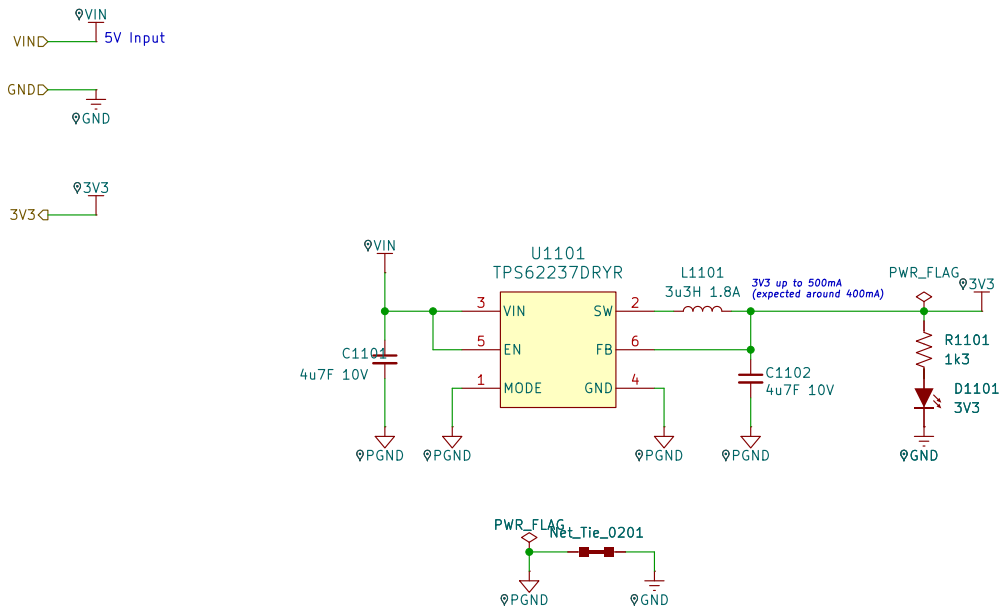
[picture p4: page 4]

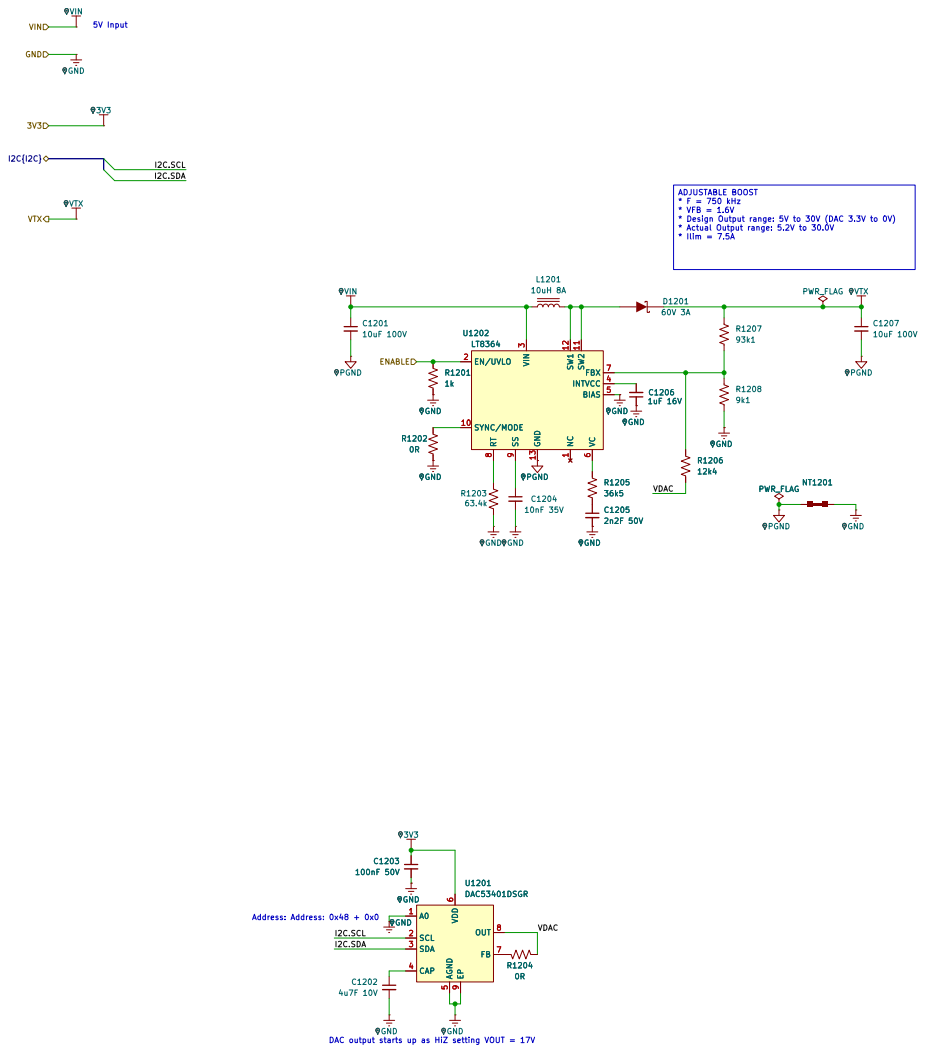
[picture p5: page 5]

* F = 750 kHz
* VFB = 1.6V
* Design Output range: 5V to 30V (DAC 3.3V to 0V) * Actual Output range: 5.2V to 30.0V

DAC output starts up as HiZ setting VOUT = 17V

for applicable conditions GND

Sheet: /Power/VTX Boost/

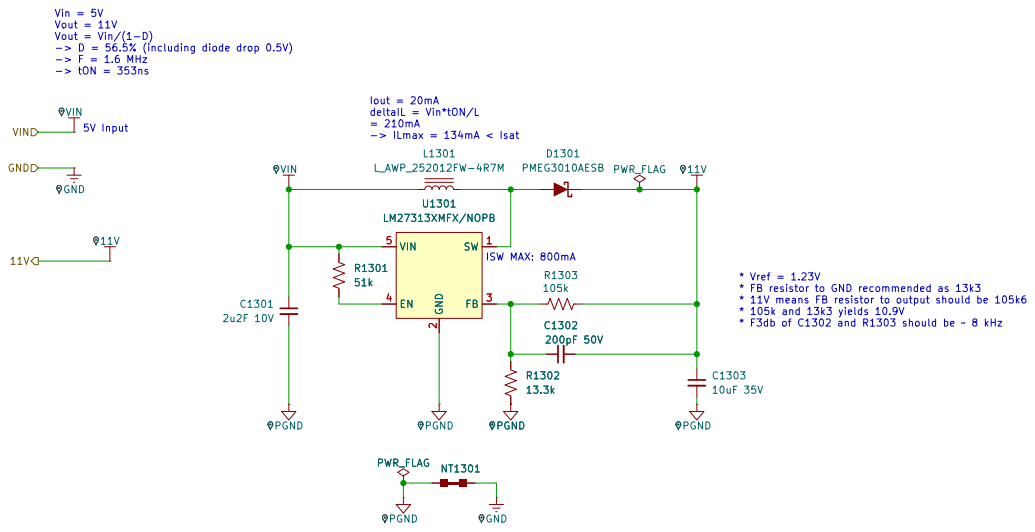
[picture p6: page 6]

Iout = 20mA deltaIL = Vin*tON/L = 210mA -> ILmax = 134mA < Isat Vin = 5V
Vout = 11V

* FB resistor to GND recommended as 13k3
* 11V means FB resistor to output should be 105k6

Sheet: /Power/VRX Boost/

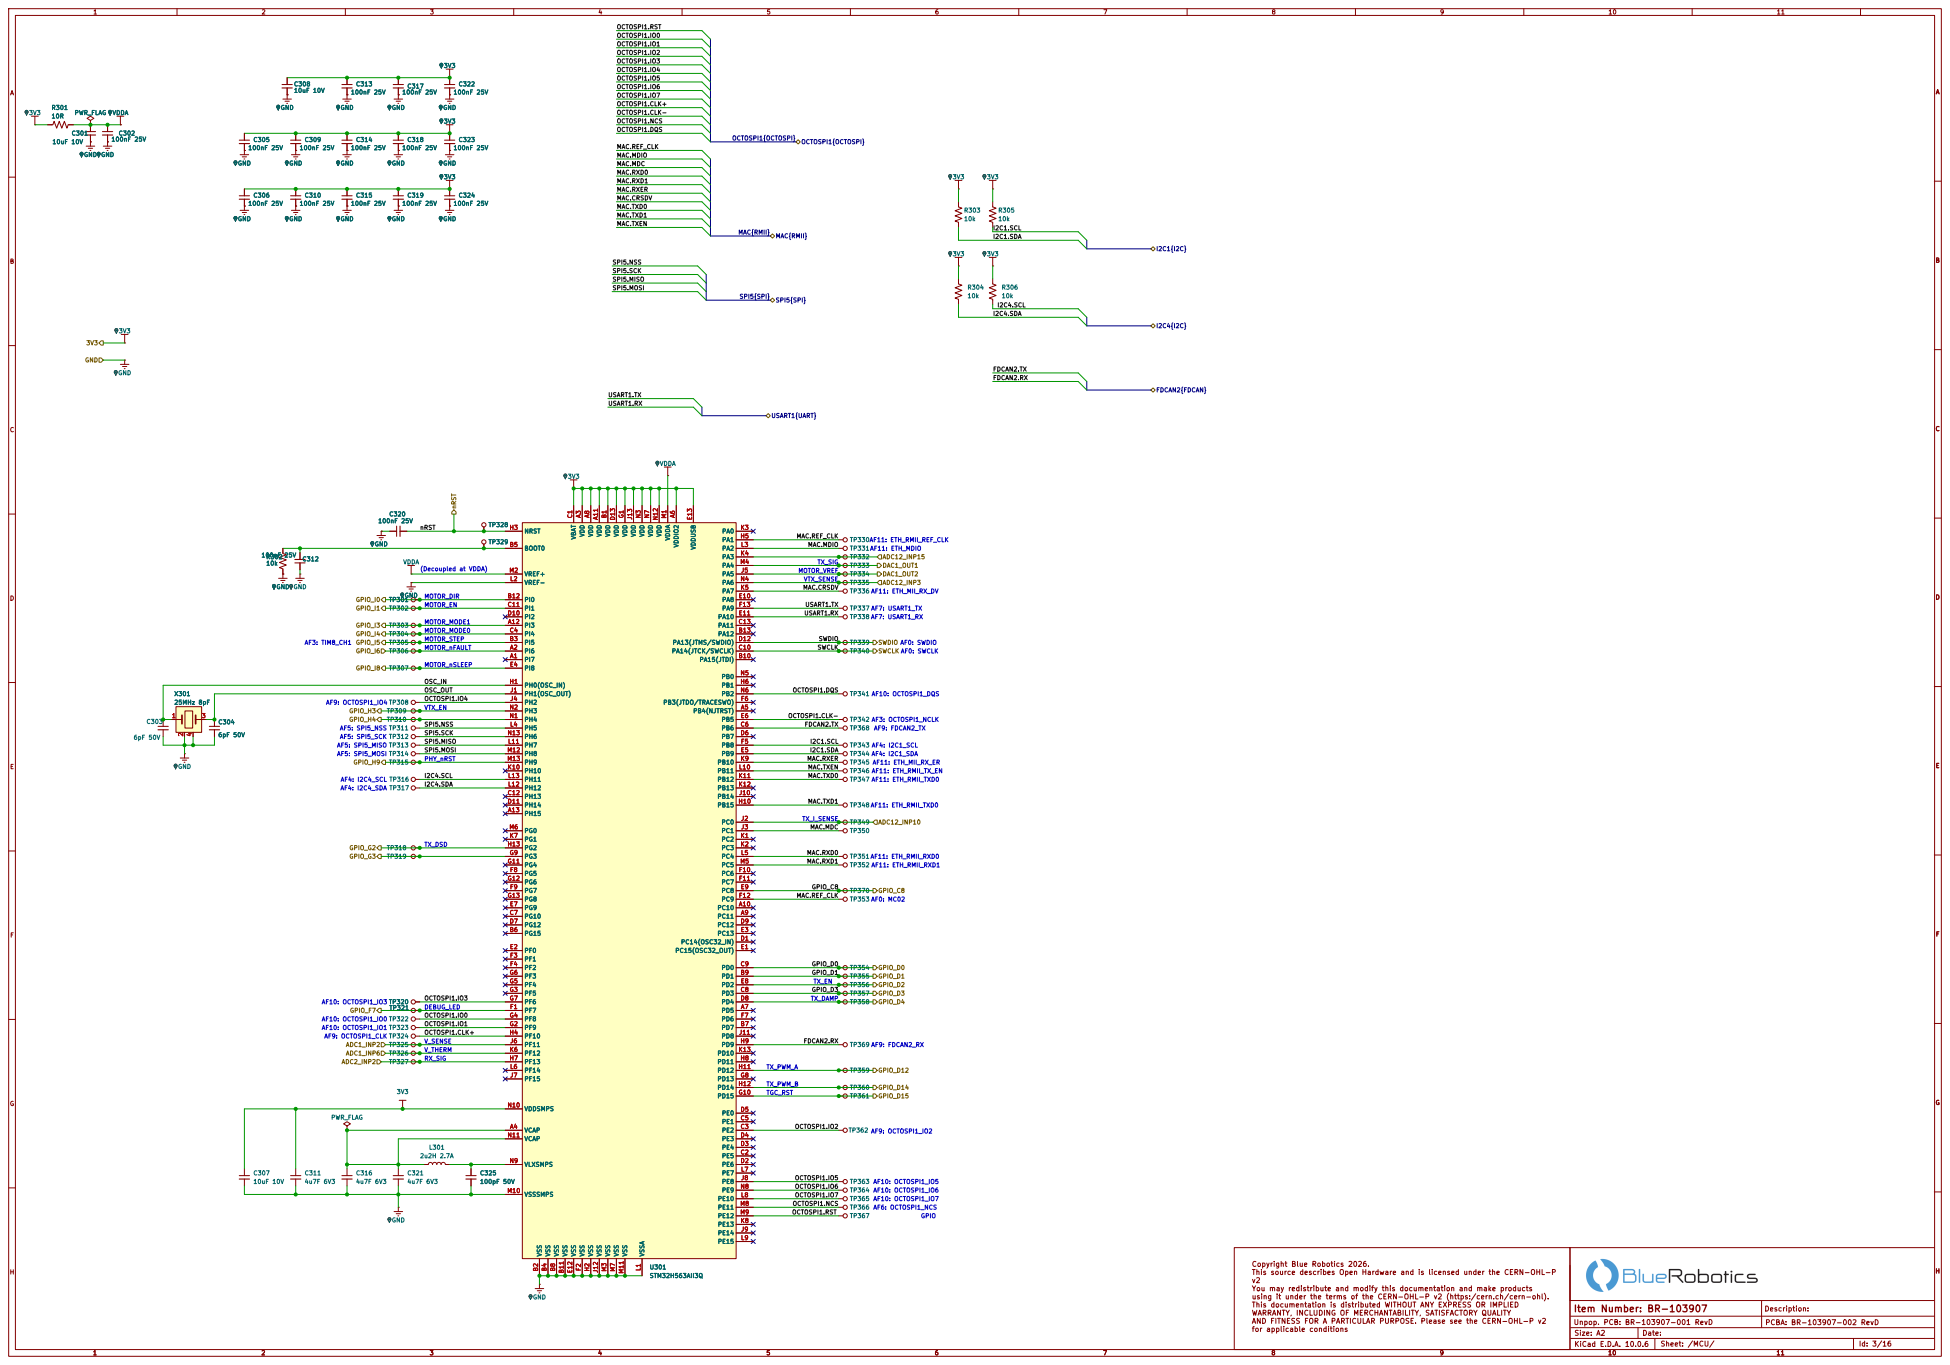
[picture p7: page 7]

MAC.RXD0 MAC.MDC MAC.REF_CLK
MAC.MDIO

MAC{RMII} MAC.RXER MAC.CRSDV MAC.RXD1

SWDIO MAC.REF_CLK MAC.MDIO MAC.REF_CLK

I2C1.SDA MAC.TXD1 MAC.RXER

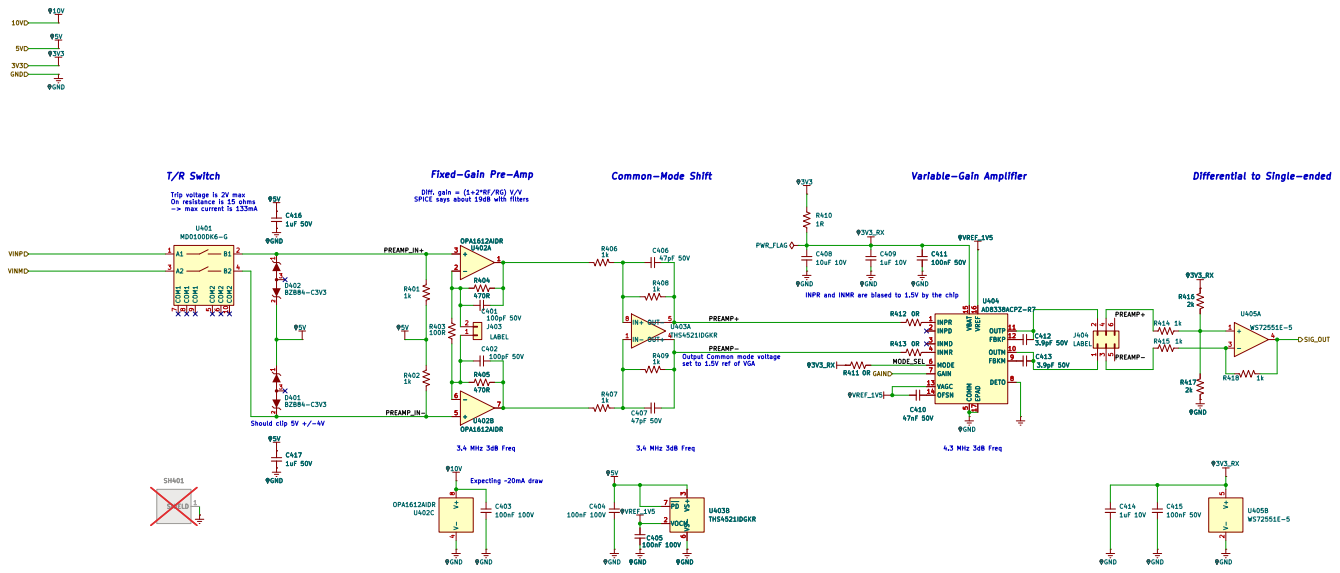
[picture p8: page 8]

Trip voltage is 2V max On resistance is 15 ohms -> max current is 133mA T/R Switch

set to 1.5V ref of VGA Fixed-Gain Pre-Amp

INPR and INMR are biased to 1.5V by the chip Should clip 5V +/-4V

Output Common mode voltage

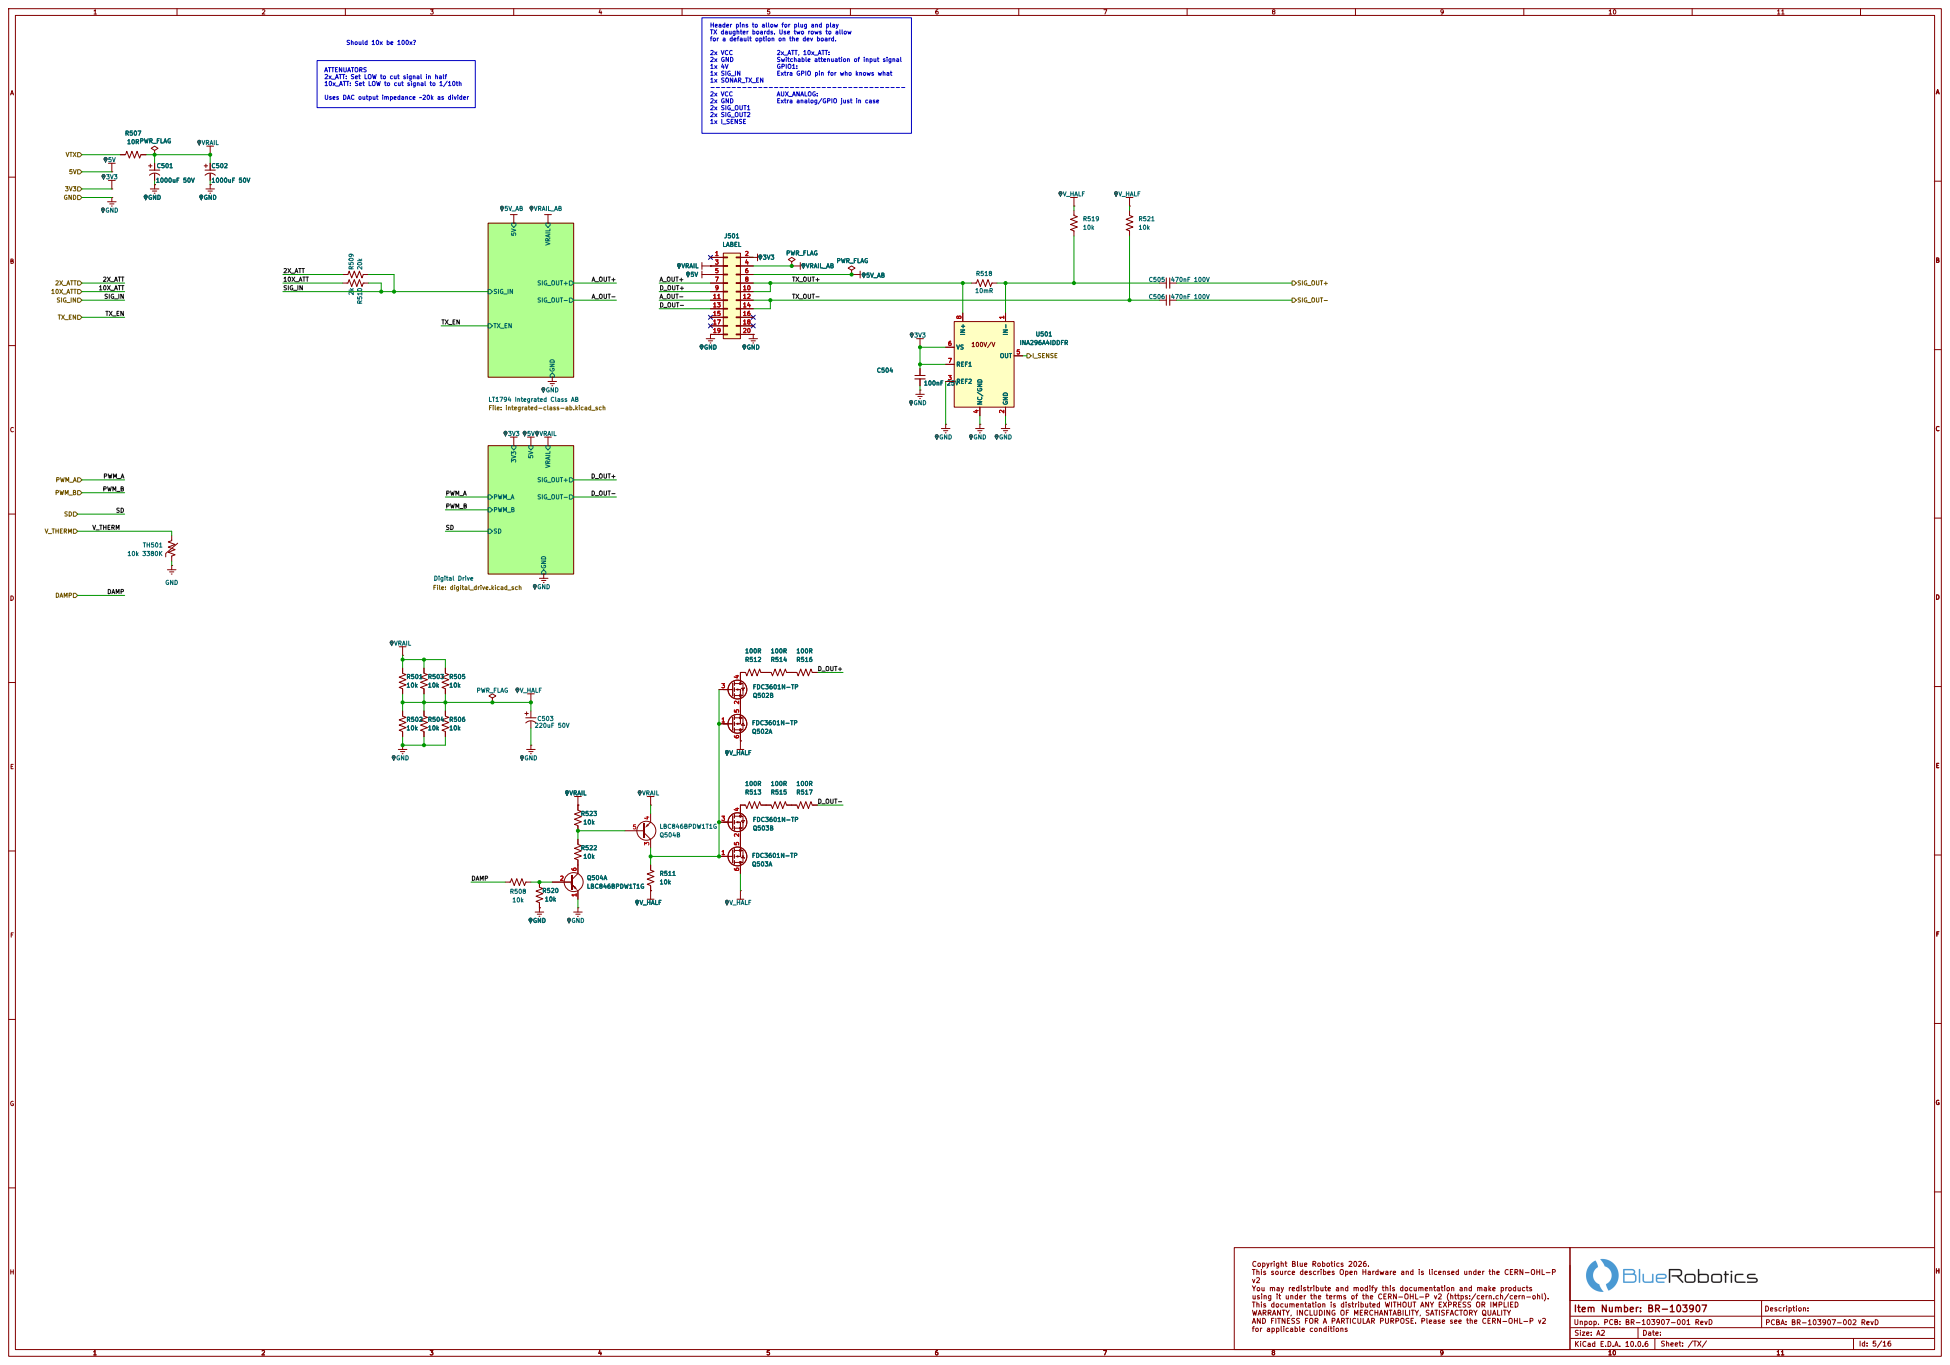
[picture p9: page 9]

TX daughter boards. Use two rows to allow
for a default option on the dev board. 2x VCC

2x_ATT, 10x_ATT: Switchable attenuation of input signal GPIO1: Extra GPIO pin for who knows what AUX_ANALOG: Extra analog/GPIO just in case

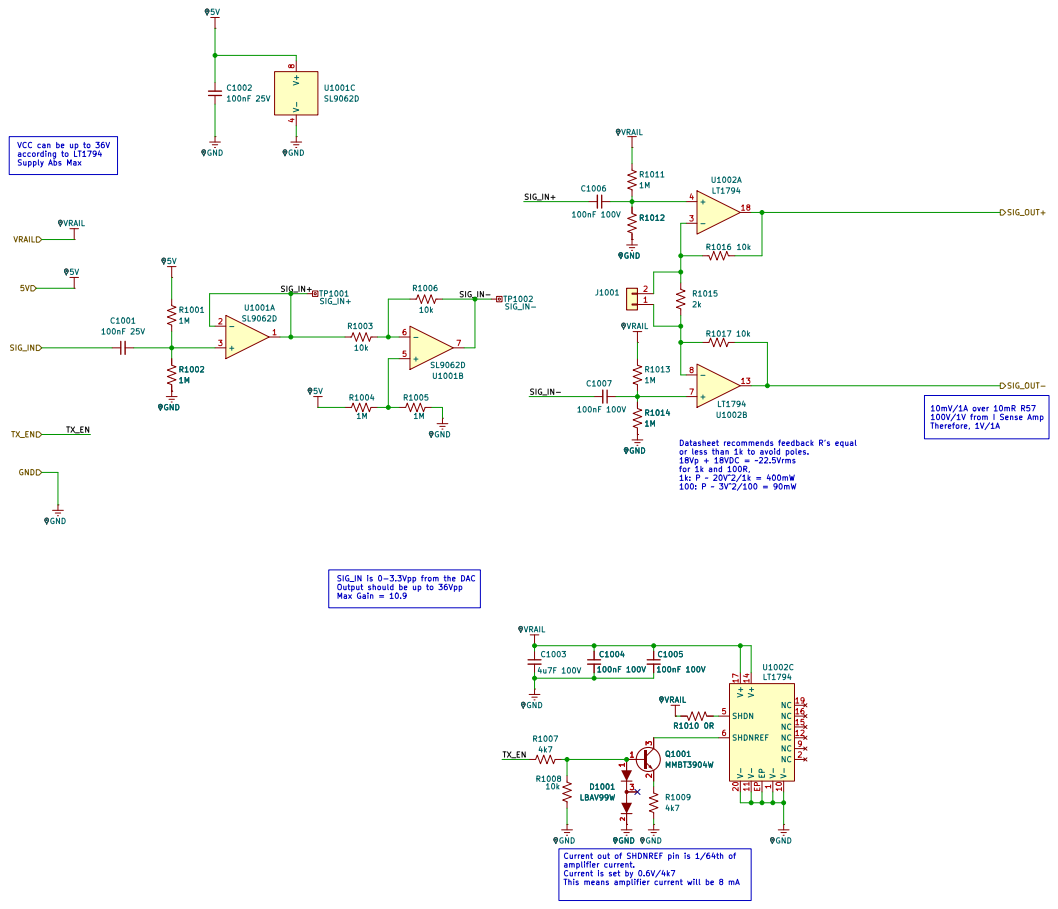
[picture p10: page 10]

Therefore, 1V/1A Datasheet recommends feedback R's equal or less than 1k to avoid poles.

Current out of SHDNREF pin is 1/64th of amplifier current. Current is set by 0.6V/4k7

This means amplifier current will be 8 mA

Sheet: /TX/LT1794 Integrated Class AB/

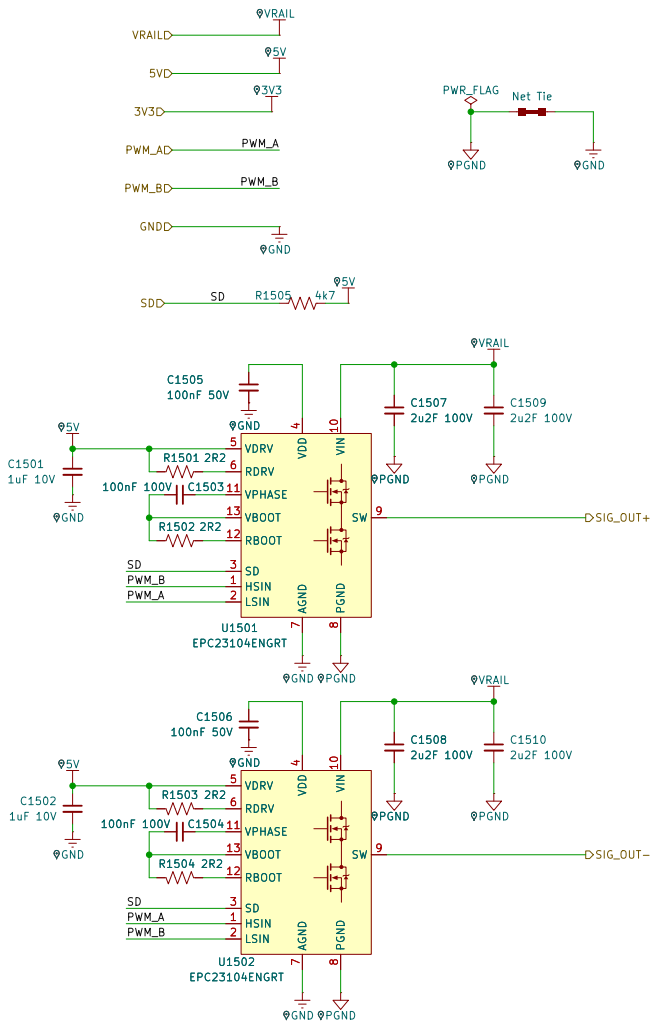
[picture p11: page 11]

Sheet: /TX/Digital Drive/

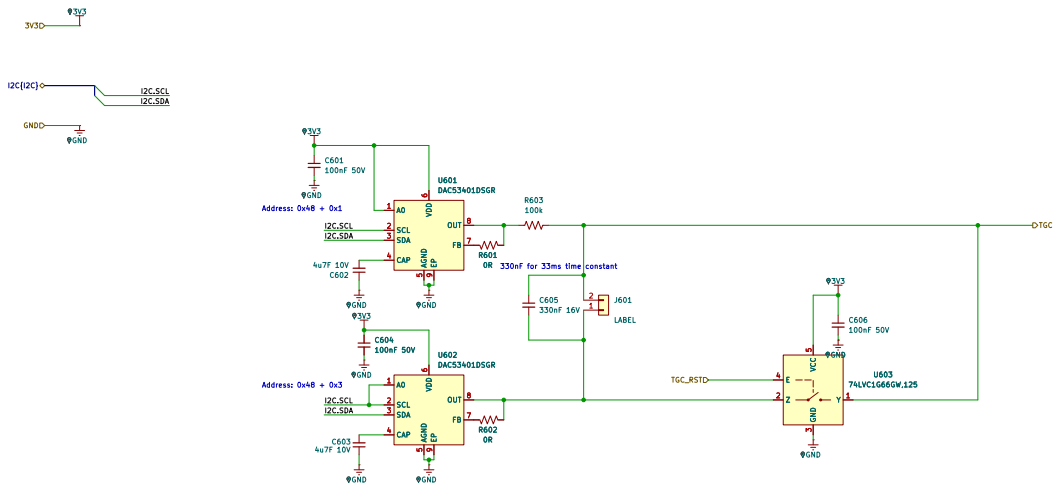
[picture p12: page 12]

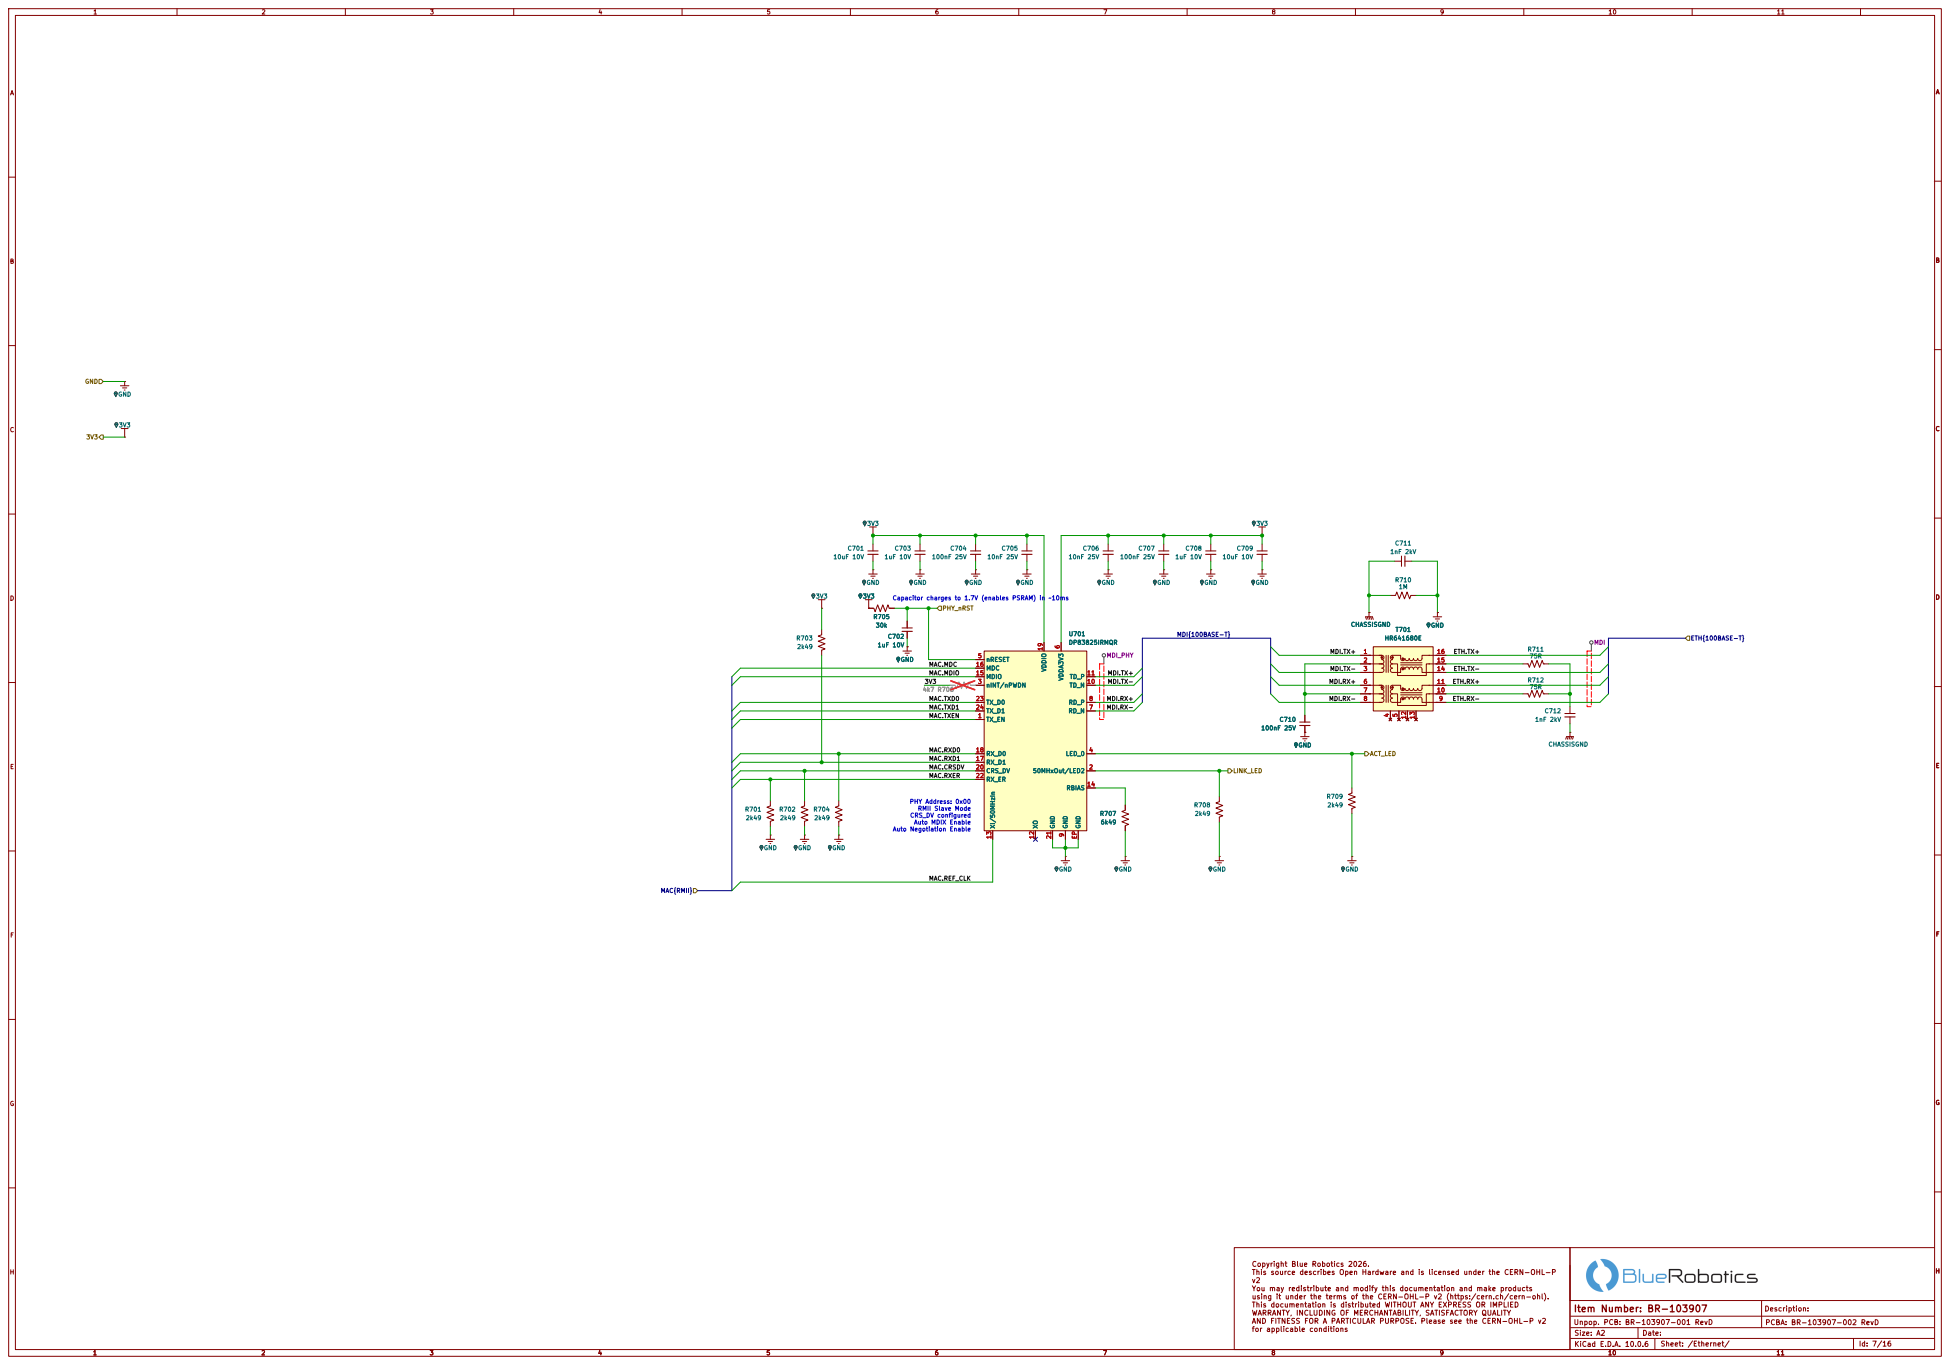
[picture p13: page 13]

Capacitor charges to 1.7V (enables PSRAM) in ~10ms PHY Address: 0x00 RMII Slave Mode CRS_DV configured
MAC.CRSDV MAC.MDC

MDI{100BASE-T} 3V3MAC.TXD0 MAC.RXD1 MAC.RXER MAC.TXEN

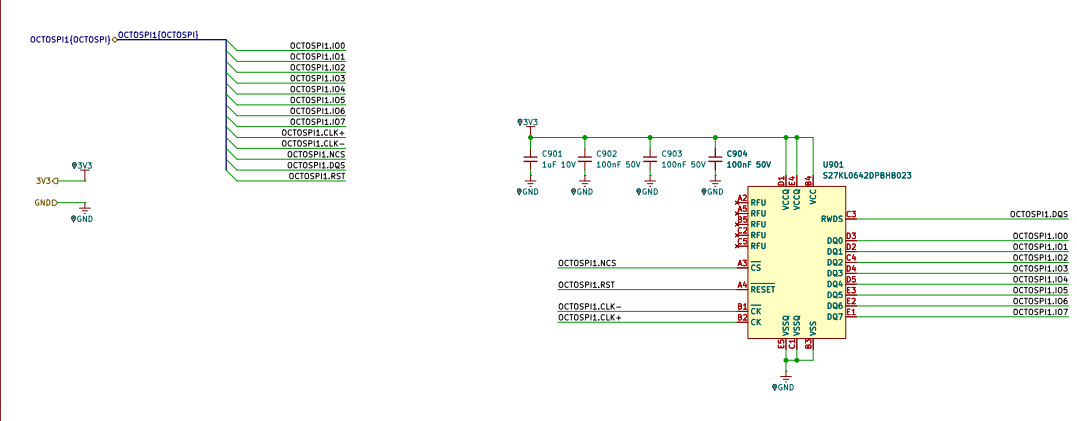
[picture p14: page 14]

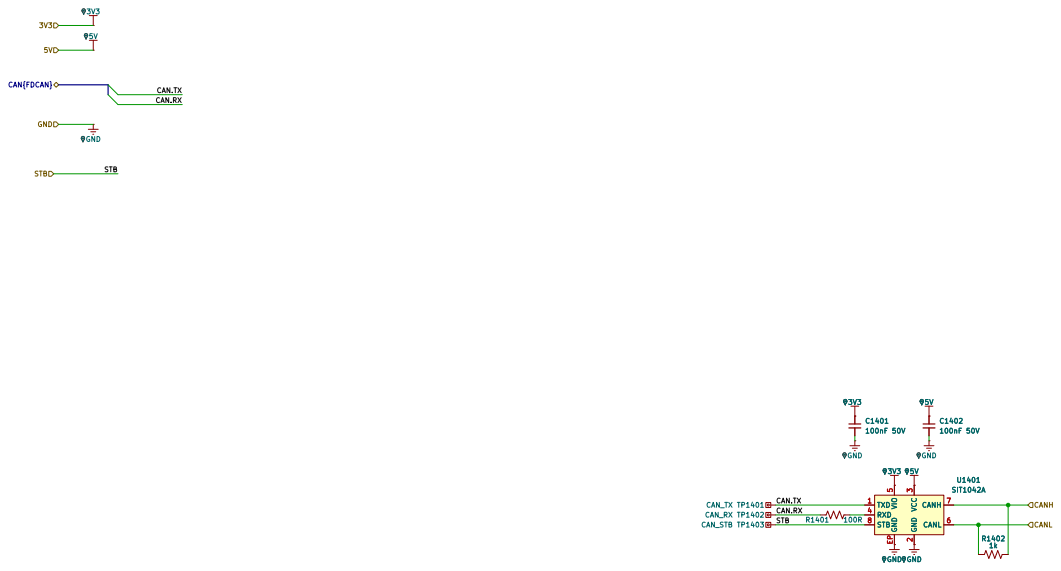
[picture p15: page 15]

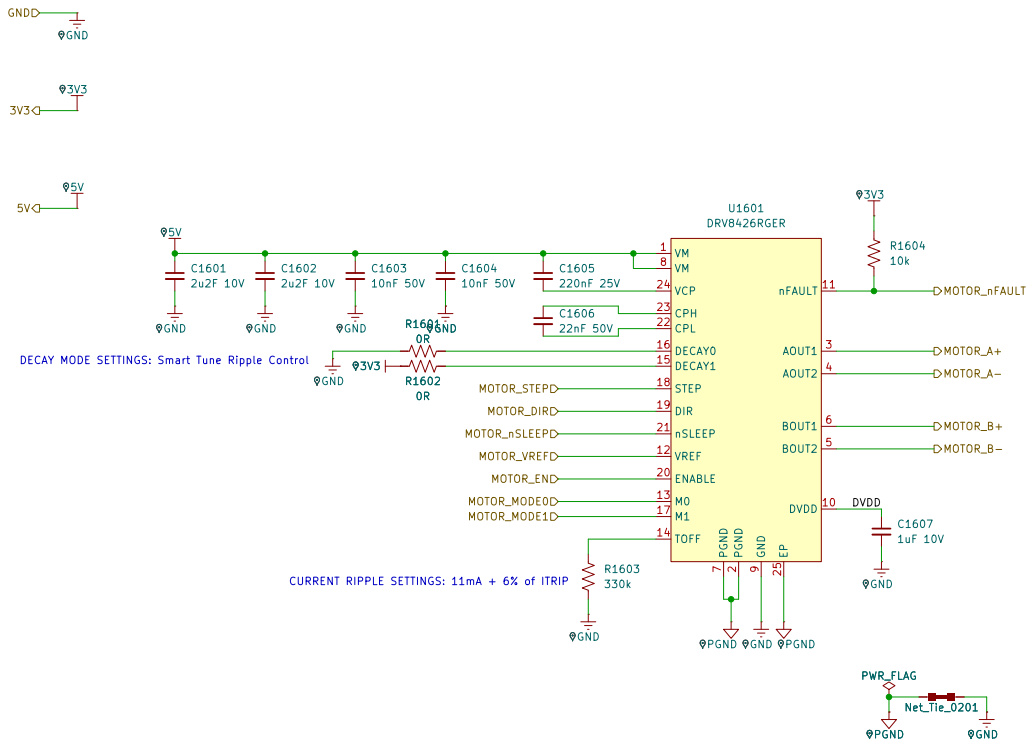
[picture p16: page 16]

DECAY MODE SETTINGS: Smart Tune Ripple Control CURRENT RIPPLE SETTINGS: 11mA + 6% of ITRIP
