bluerobotics/ping-dev-kit/BR-103907-002_RevD_PCBA_Outputs/PingDevKit_PCB.pdf

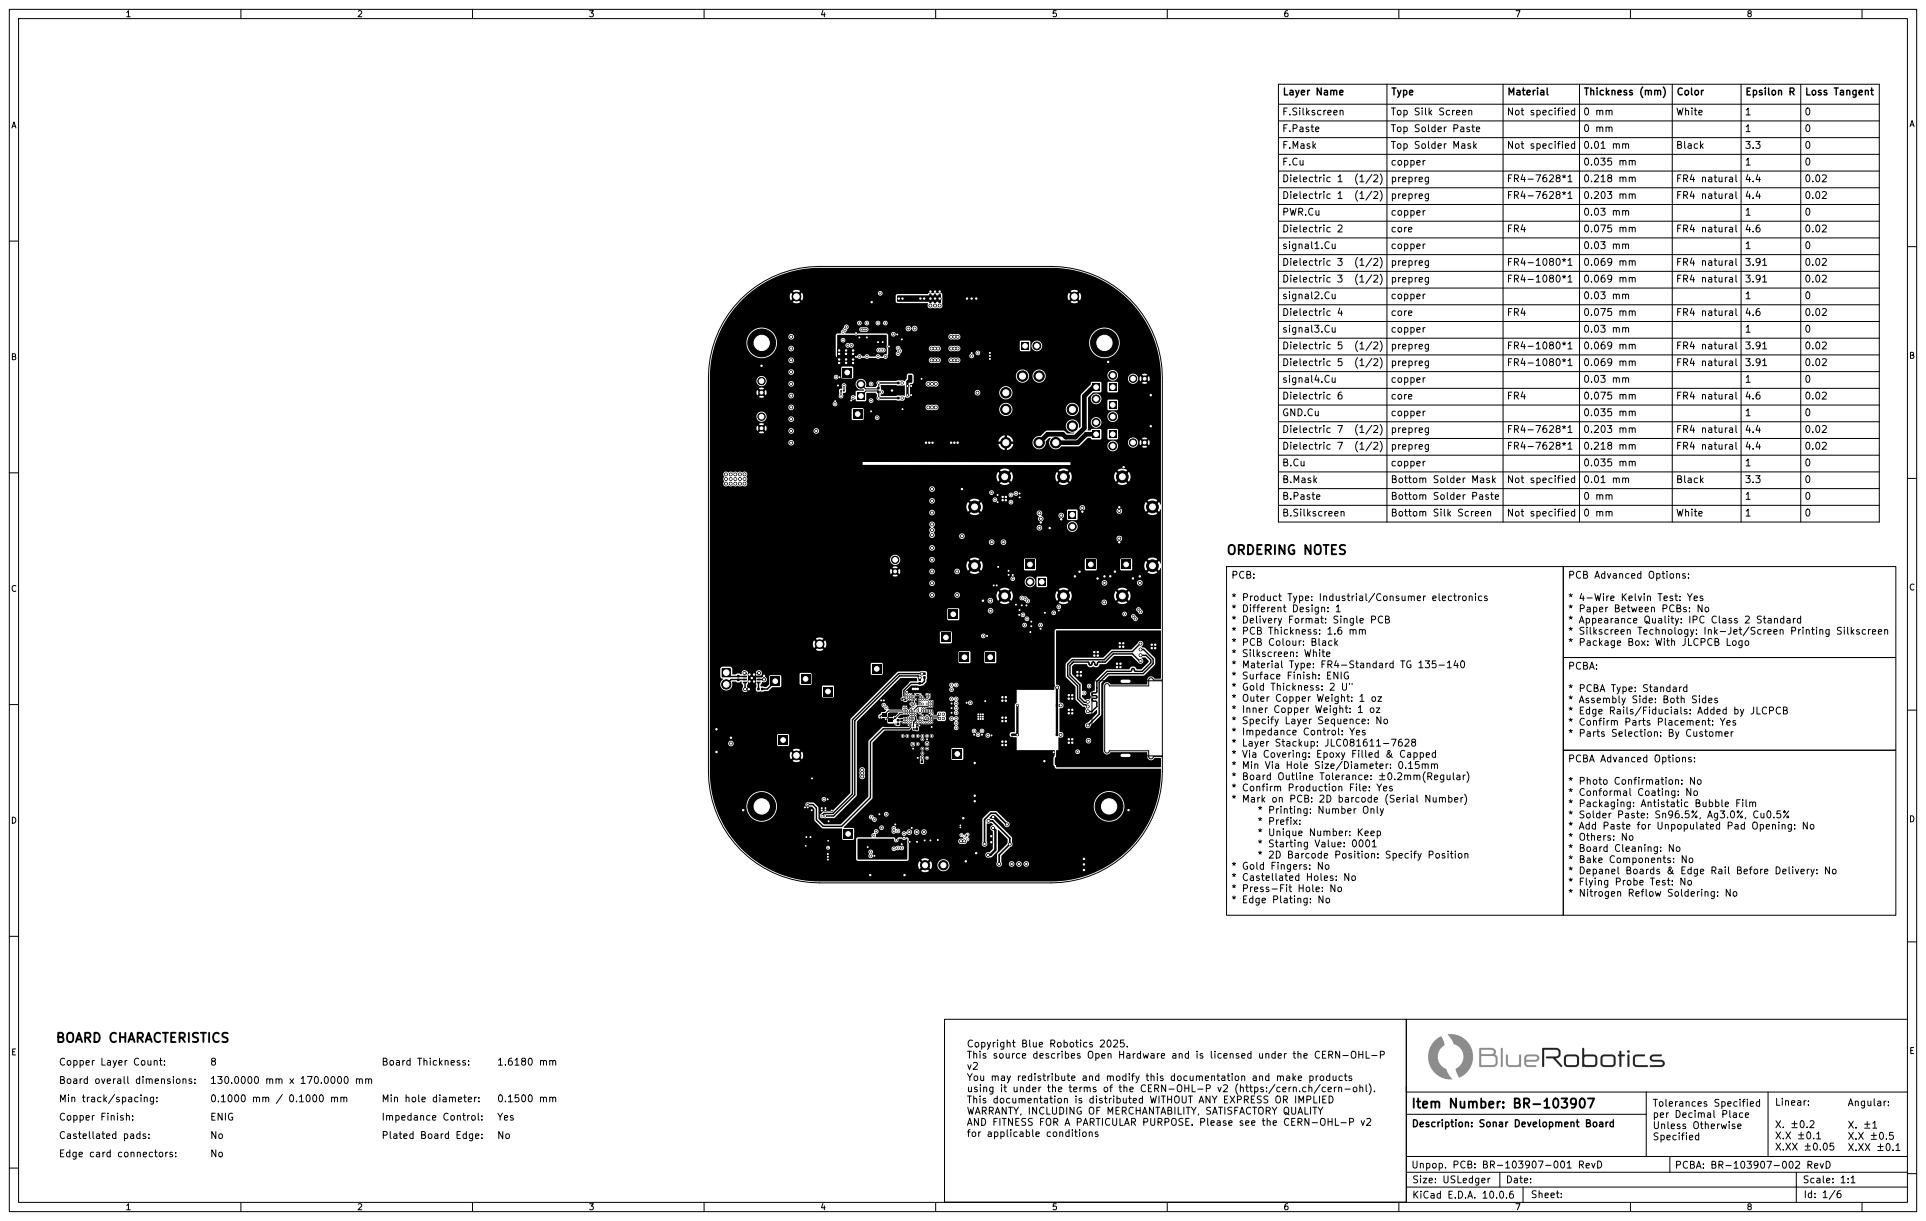
[picture p17: page 1]

Layer Name | Type | Material | Thickness (mm) | Color | Epsilon R | Loss Tangent
F.Silkscreen | Top Silk Screen | Not specified | 0 mm | White | 1 | 0
F.Paste | Top Solder Paste | | 0 mm | | 1 | 0
F.Mask | Top Solder Mask | Not specified | 0.01 mm | Black | 3.3 | 0
F.Cu | copper | | 0.035 mm | | 1 | 0
Dielectric 1 (1/2) | prepreg | FR4-7628*1 | 0.218 mm | FR4 natural | 4.4 | 0.02
Dielectric 1 (1/2) | prepreg | FR4-7628*1 | 0.203 mm | FR4 natural | 4.4 | 0.02
PWR.Cu | copper core | | 0.03 mm | | 1 | 0
Dielectric 2 | | FR4 | 0.075 mm | FR4 natural | 4.6 | 0.02
signal1.Cu | copper | | 0.03 mm | | 1 | 0
Dielectric 3 (1/2) | prepreg | FR4-1080*1 | 0.069 mm | FR4 natural | 3.91 | 0.02
signal2.Cu | copper core | | 0.03 mm | | 1 | 0
Dielectric 4 | | FR4 | 0.075 mm | FR4 natural | 4.6 | 0.02
signal3.Cu | copper | | 0.03 mm | | 1 | 0
Dielectric 5 (1/2) | prepreg | FR4-1080*1 | 0.069 mm | FR4 natural | 3.91 | 0.02
signal4.Cu | copper core | | 0.03 mm | | 1 | 0
Dielectric 6 | | FR4 | 0.075 mm | FR4 natural | 4.6 | 0.02
GND.Cu | copper | | 0.035 mm | | 1 | 0
Dielectric 7 (1/2) | prepreg | FR4-7628*1 | 0.203 mm | FR4 natural | 4.4 | 0.02
Dielectric 7 (1/2) | prepreg | FR4-7628*1 | 0.218 mm | FR4 natural | 4.4 | 0.02
B.Cu | copper | | 0.035 mm | | 1 | 0
B.Mask | Bottom Solder Mask | Not specified | 0.01 mm | Black | 3.3 | 0
B.Paste | Bottom Solder Paste | | 0 mm | | 1 | 0
B.Silkscreen | Bottom Silk Screen | Not specified | 0 mm | White | 1 | 0

PCB: * Product Type: Industrial/Consumer electronics

PCB Advanced Options: * 4-Wire Kelvin Test: Yes

* Different Design: 1
* Delivery Format: Single PCB
* PCB Thickness: 1.6 mm
* PCB Colour: Black
* Silkscreen: White
* Material Type: FR4-Standard TG 135-140
* Surface Finish: ENIG
* Gold Thickness: 2 U"
* Outer Copper Weight: 1 oz
* Inner Copper Weight: 1 oz
* Specify Layer Sequence: No
* Impedance Control: Yes
* Layer Stackup: JLC081611-7628
* Via Covering: Epoxy Filled & Capped
* Min Via Hole Size/Diameter: 0.15mm
* Board Outline Tolerance: ±0.2mm(Regular) * Confirm Production File: Yes

* Paper Between PCBs: No
* Appearance Quality: IPC Class 2 Standard
* Silkscreen Technology: Ink-Jet/Screen Printing Silkscreen
* Package Box: With JLCPCB Logo

PCBA: * PCBA Type: Standard

* Assembly Side: Both Sides
* Edge Rails/Fiducials: Added by JLCPCB
* Confirm Parts Placement: Yes
* Parts Selection: By Customer

PCBA Advanced Options: * Photo Confirmation: No

* Conformal Coating: No
* Packaging: Antistatic Bubble Film
* Solder Paste: Sn96.5%, Ag3.0%, Cu0.5%
* Add Paste for Unpopulated Pad Opening: No
* Others: No
* Board Cleaning: No
* Bake Components: No
* Depanel Boards & Edge Rail Before Delivery: No
* Flying Probe Test: No
* Nitrogen Reflow Soldering: No

* Mark on PCB: 2D barcode (Serial Number) * Printing: Number Only

* Prefix: * Unique Number: Keep

* Starting Value: 0001
* 2D Barcode Position: Specify Position
* Gold Fingers: No
* Castellated Holes: No
* Press-Fit Hole: No
* Edge Plating: No

Copyright Blue Robotics 2025.
This source describes Open Hardware and is licensed under the CERN-OHL-P
You may redistribute and modify this documentation and make products
using it under the terms of the CERN-OHL-P v2 (https:/cern.ch/cern-ohl).
This documentation is distributed WITHOUT ANY EXPRESS OR IMPLIED
WARRANTY, INCLUDING OF MERCHANTABILITY, SATISFACTORY QUALITY
AND FITNESS FOR A PARTICULAR PURPOSE. Please see the CERN-OHL-P v2
for applicable conditions

Description: Sonar Development Board

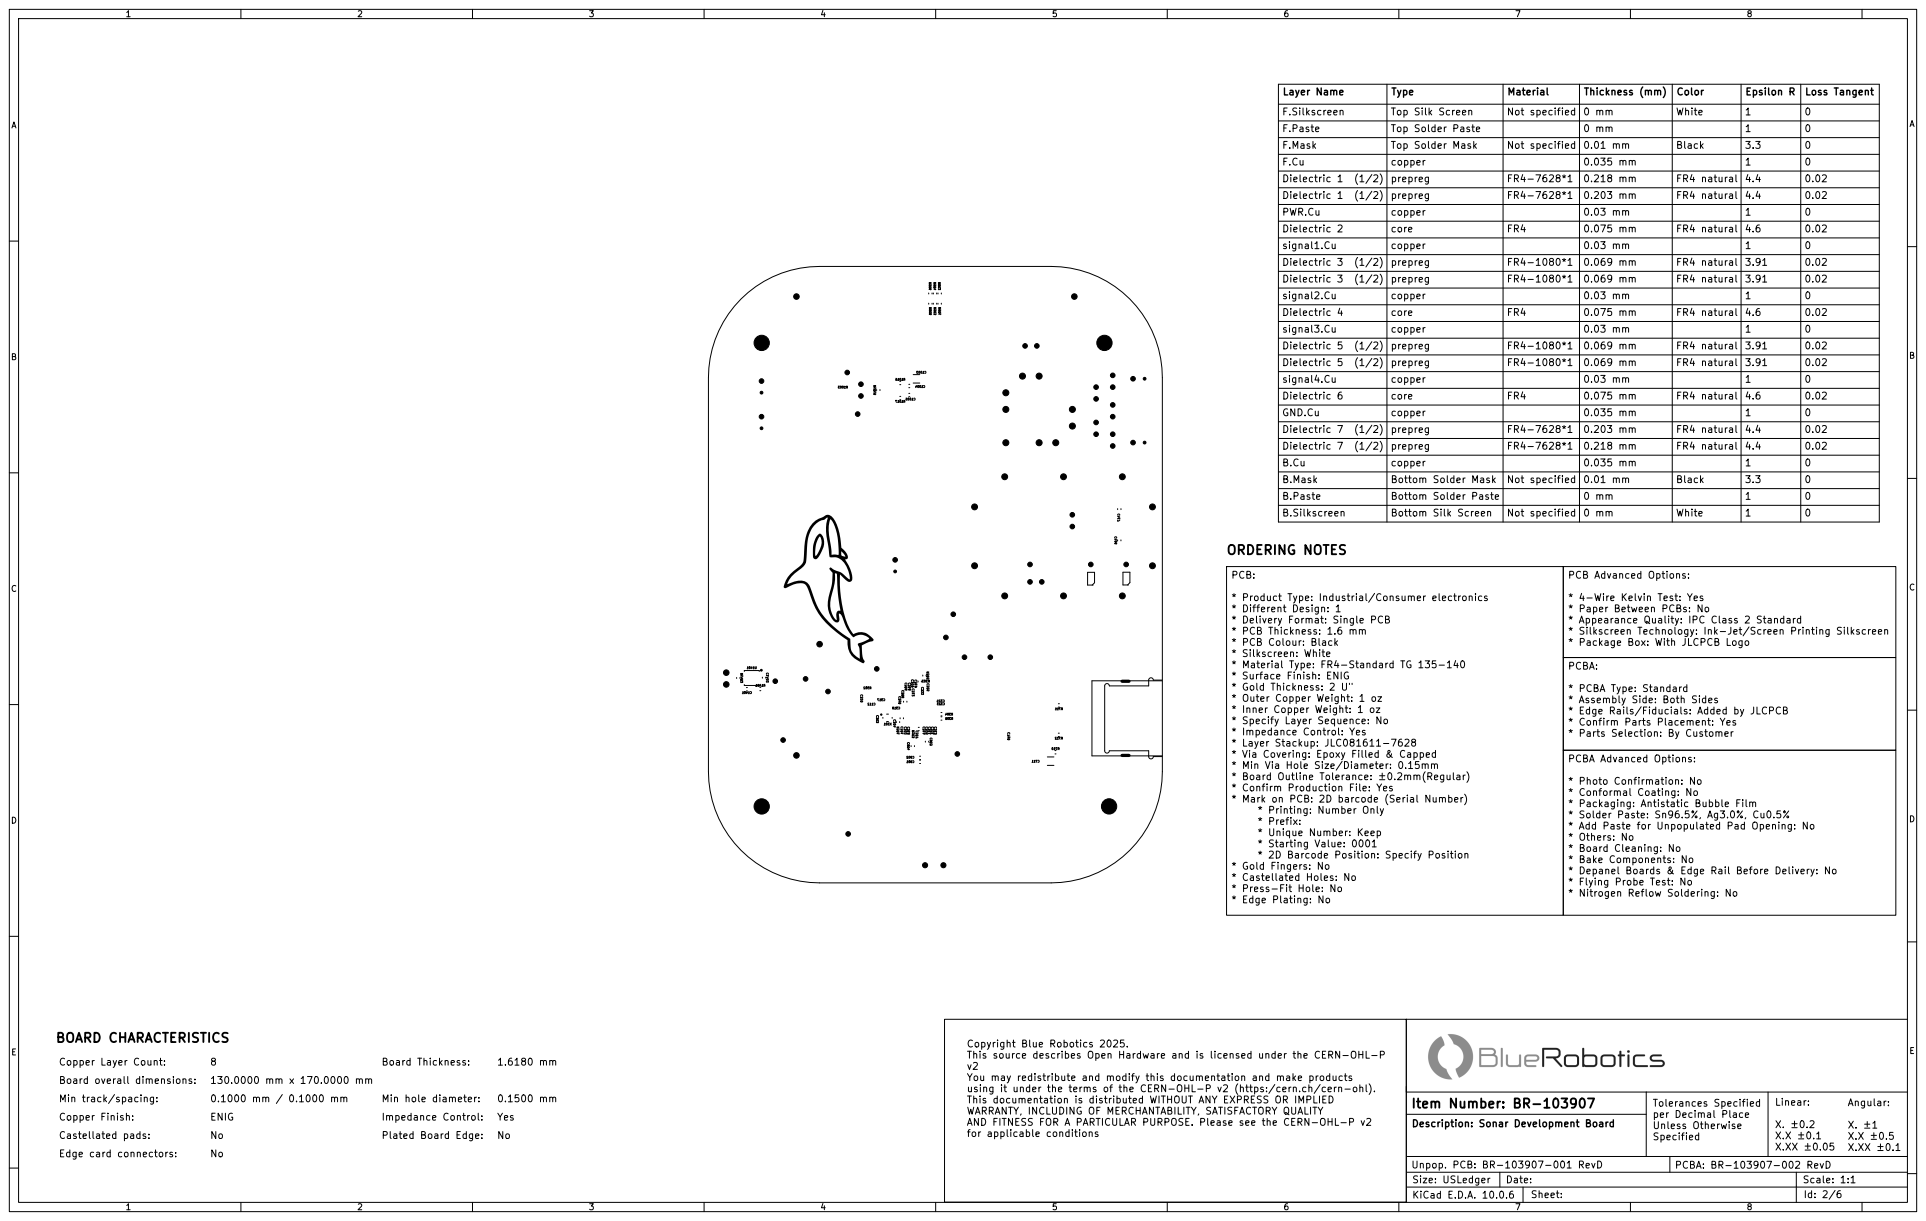
[picture p18: page 2]
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

PCB: * Product Type: Industrial/Consumer electronics

PCB Advanced Options: * 4-Wire Kelvin Test: Yes

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

PCBA: * PCBA Type: Standard

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

PCBA Advanced Options: * Photo Confirmation: No

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

* Mark on PCB: 2D barcode (Serial Number) * Printing: Number Only

* Prefix: * Unique Number: Keep

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

Description: Sonar Development Board

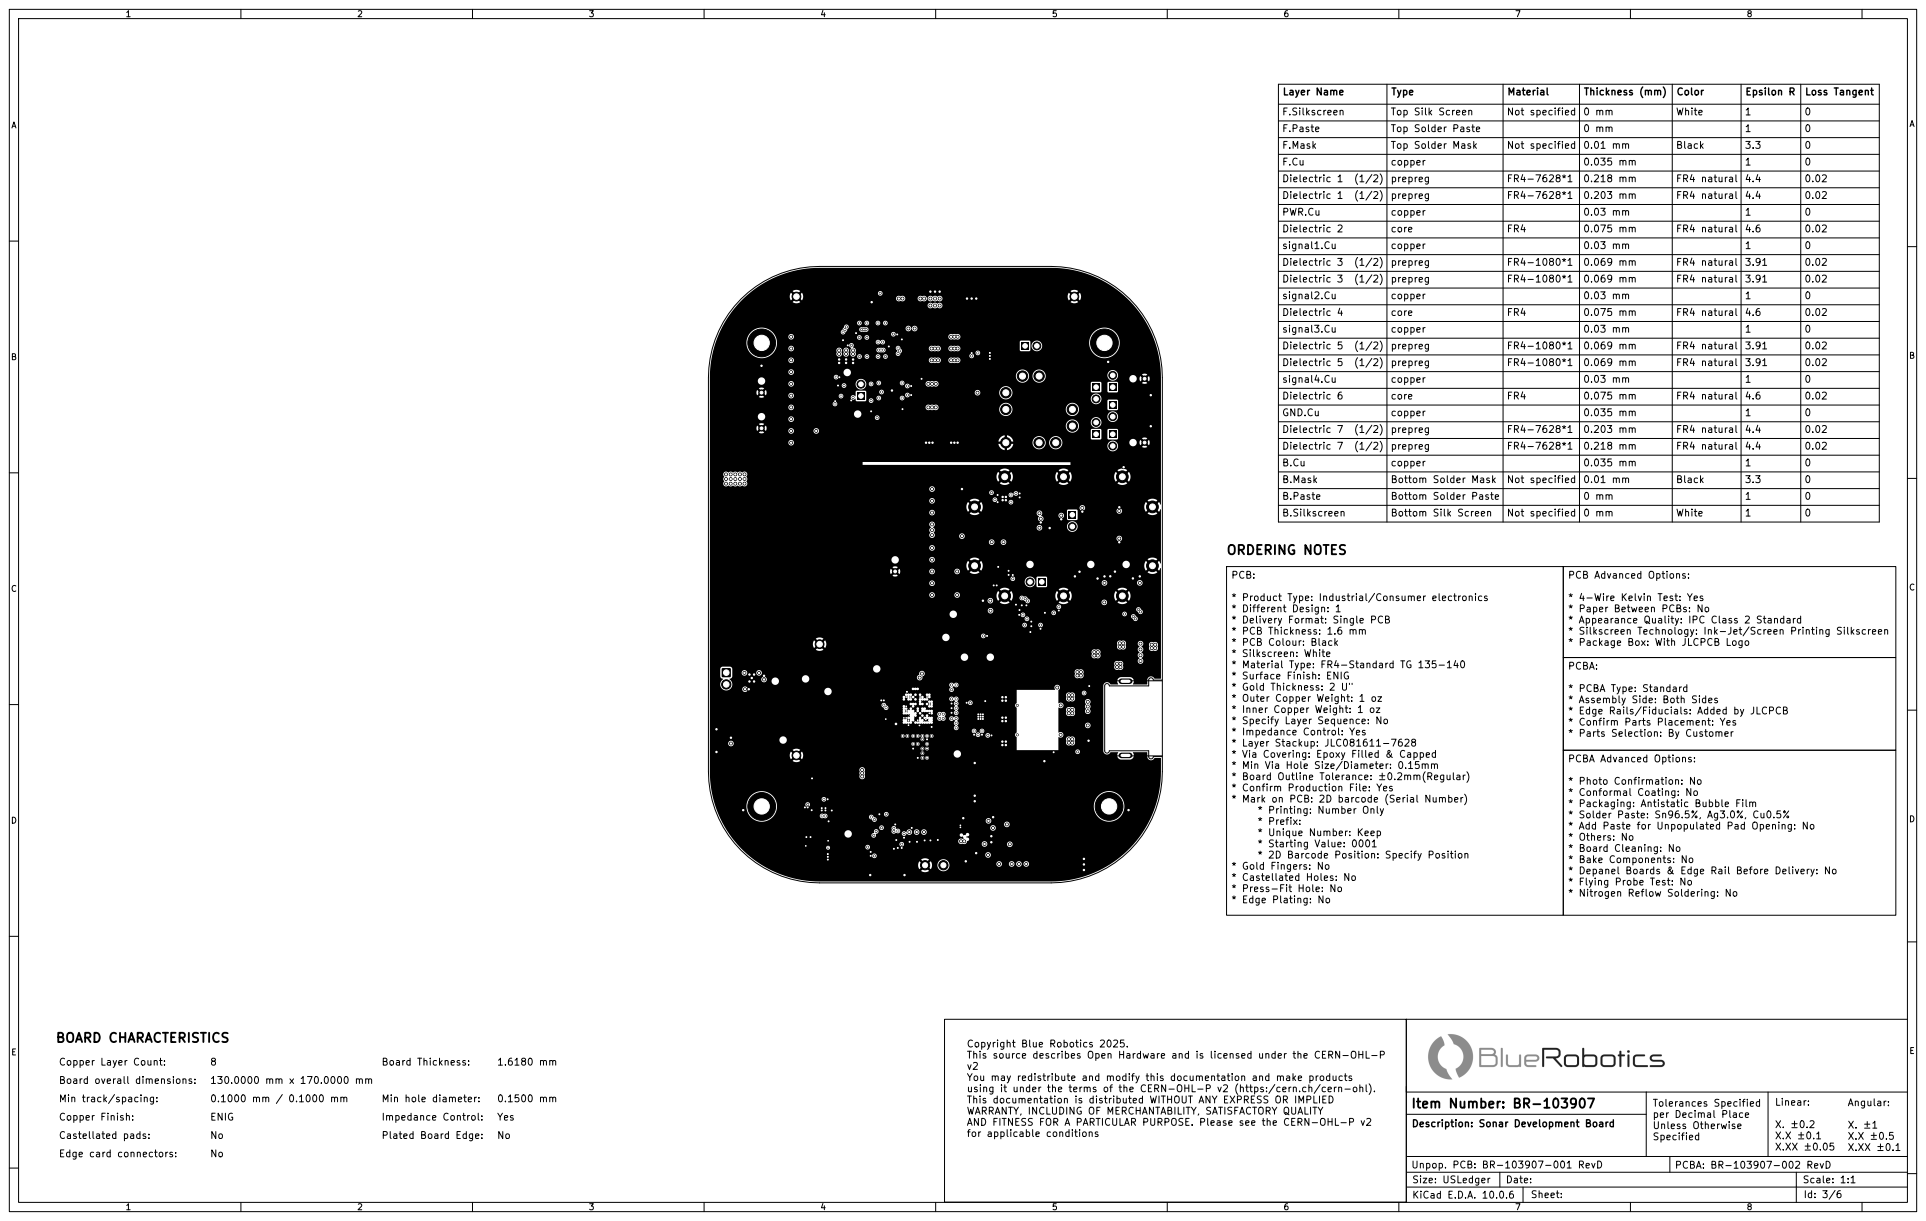
[picture p19: page 3]
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

PCB: * Product Type: Industrial/Consumer electronics

PCB Advanced Options: * 4-Wire Kelvin Test: Yes

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

PCBA: * PCBA Type: Standard

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

PCBA Advanced Options: * Photo Confirmation: No

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

* Mark on PCB: 2D barcode (Serial Number) * Printing: Number Only

* Prefix: * Unique Number: Keep

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

Description: Sonar Development Board

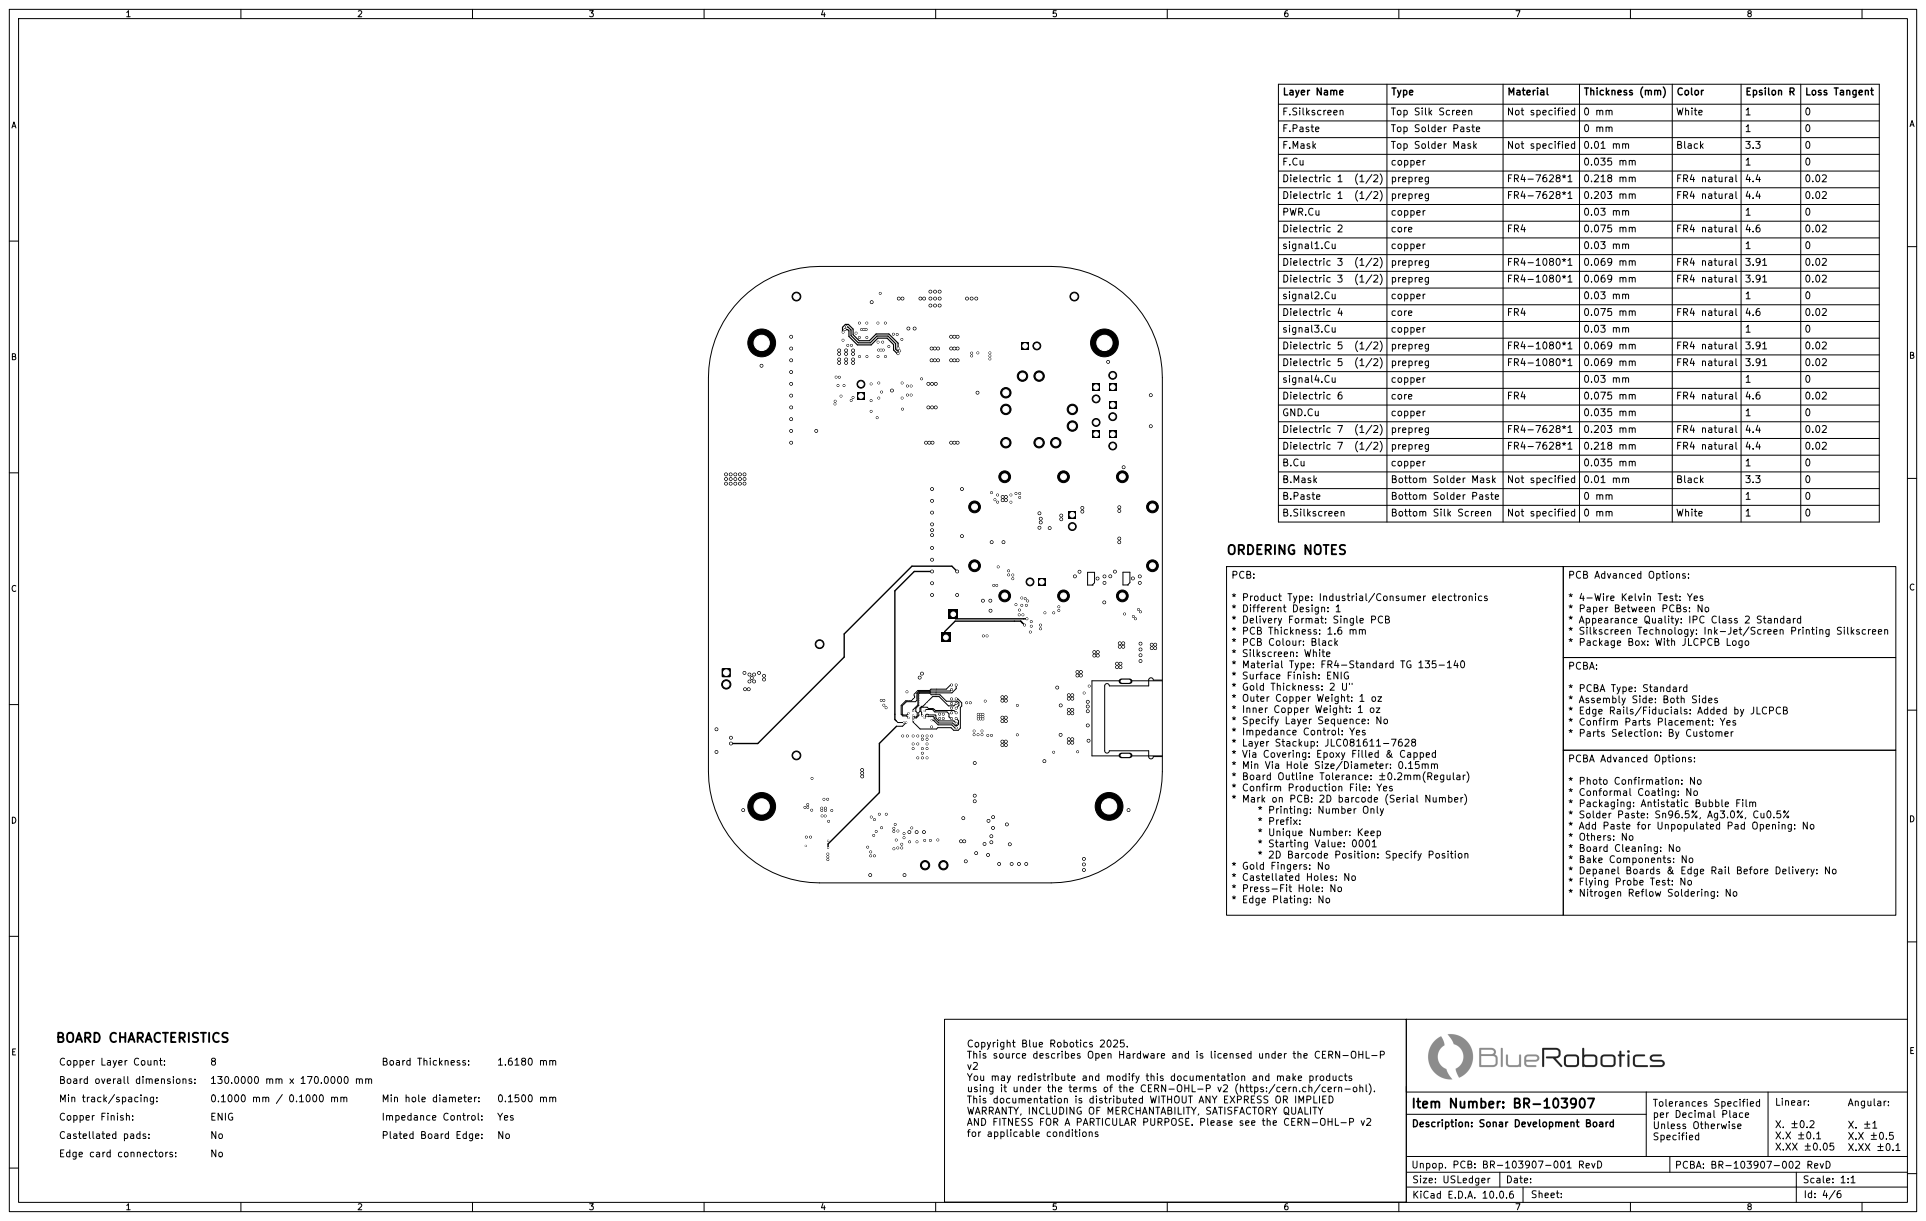
[picture p20: page 4]
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

PCB: * Product Type: Industrial/Consumer electronics

PCB Advanced Options: * 4-Wire Kelvin Test: Yes

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

PCBA: * PCBA Type: Standard

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

PCBA Advanced Options: * Photo Confirmation: No

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

* Mark on PCB: 2D barcode (Serial Number) * Printing: Number Only

* Prefix: * Unique Number: Keep

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

Description: Sonar Development Board

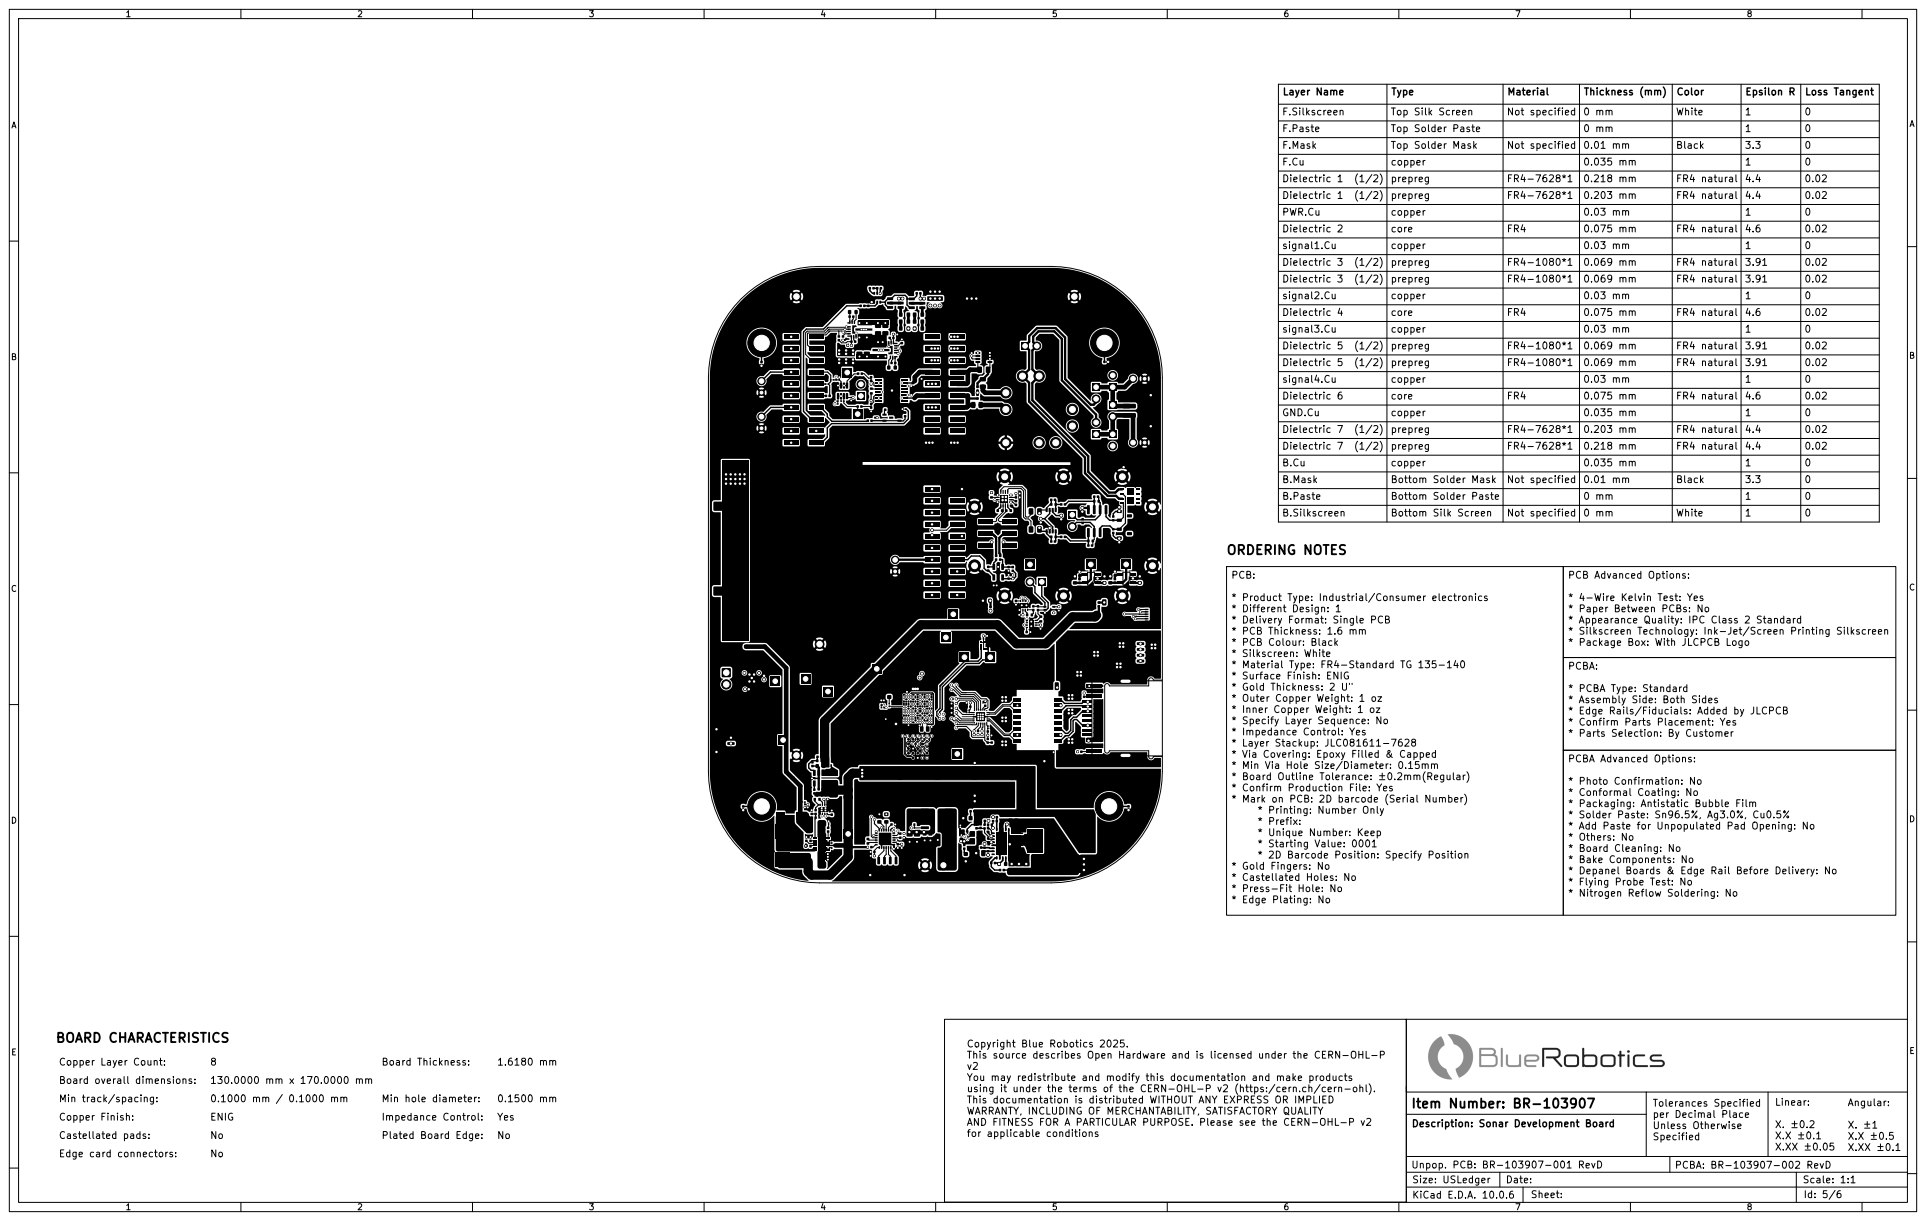
[picture p21: page 5]
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

PCB: * Product Type: Industrial/Consumer electronics

PCB Advanced Options: * 4-Wire Kelvin Test: Yes

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

PCBA: * PCBA Type: Standard

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

PCBA Advanced Options: * Photo Confirmation: No

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

* Mark on PCB: 2D barcode (Serial Number) * Printing: Number Only

* Prefix: * Unique Number: Keep

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

Description: Sonar Development Board

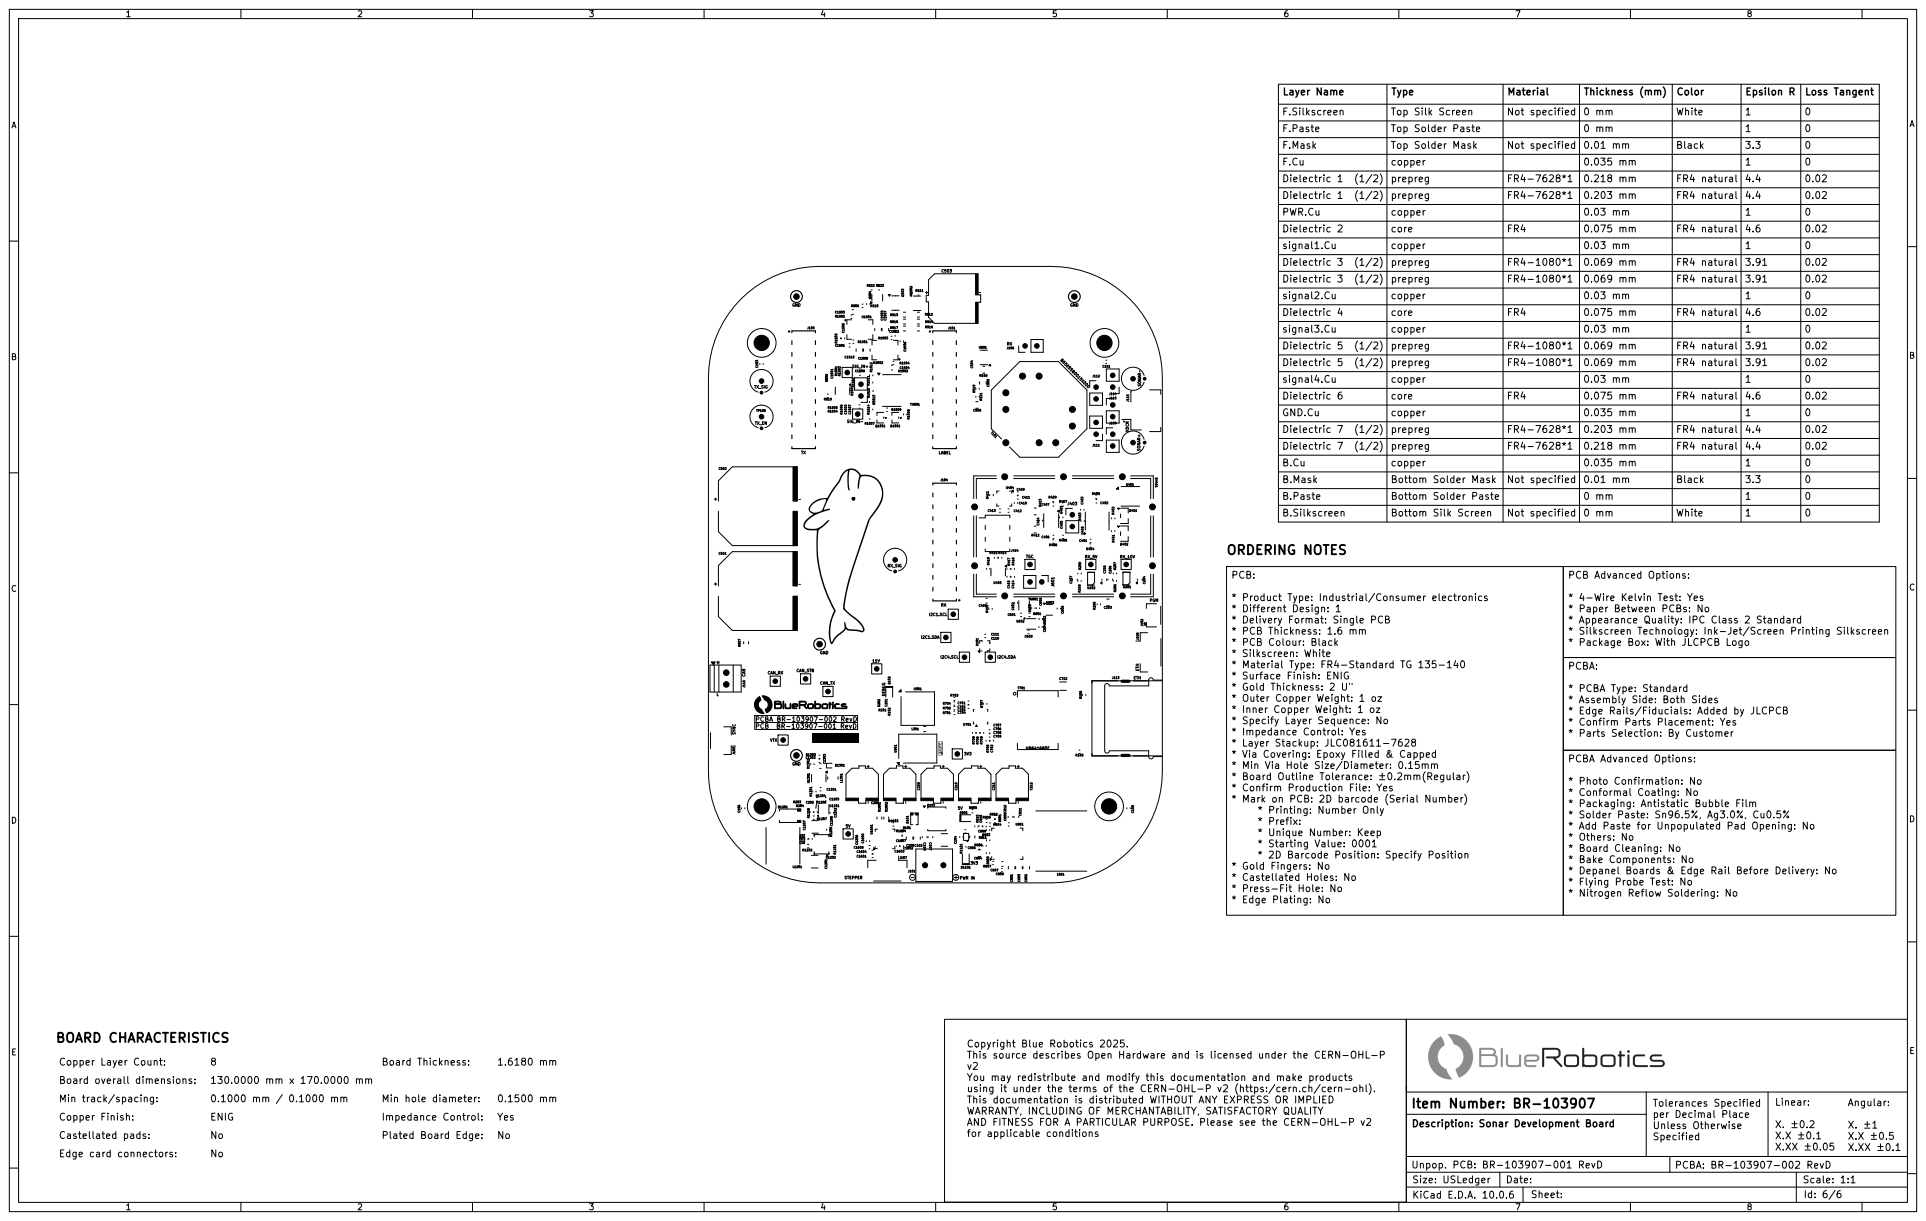
[picture p22: page 6]
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

PCB: * Product Type: Industrial/Consumer electronics

PCB Advanced Options: * 4-Wire Kelvin Test: Yes

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

PCBA: * PCBA Type: Standard

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

PCBA Advanced Options: * Photo Confirmation: No

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

* Mark on PCB: 2D barcode (Serial Number) * Printing: Number Only

* Prefix: * Unique Number: Keep

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

Description: Sonar Development Board
