bluerobotics/ping-dev-kit/BR-103907-002_RevA_PCBA_Outputs/Schematic_PDF/PingDevKit.pdf

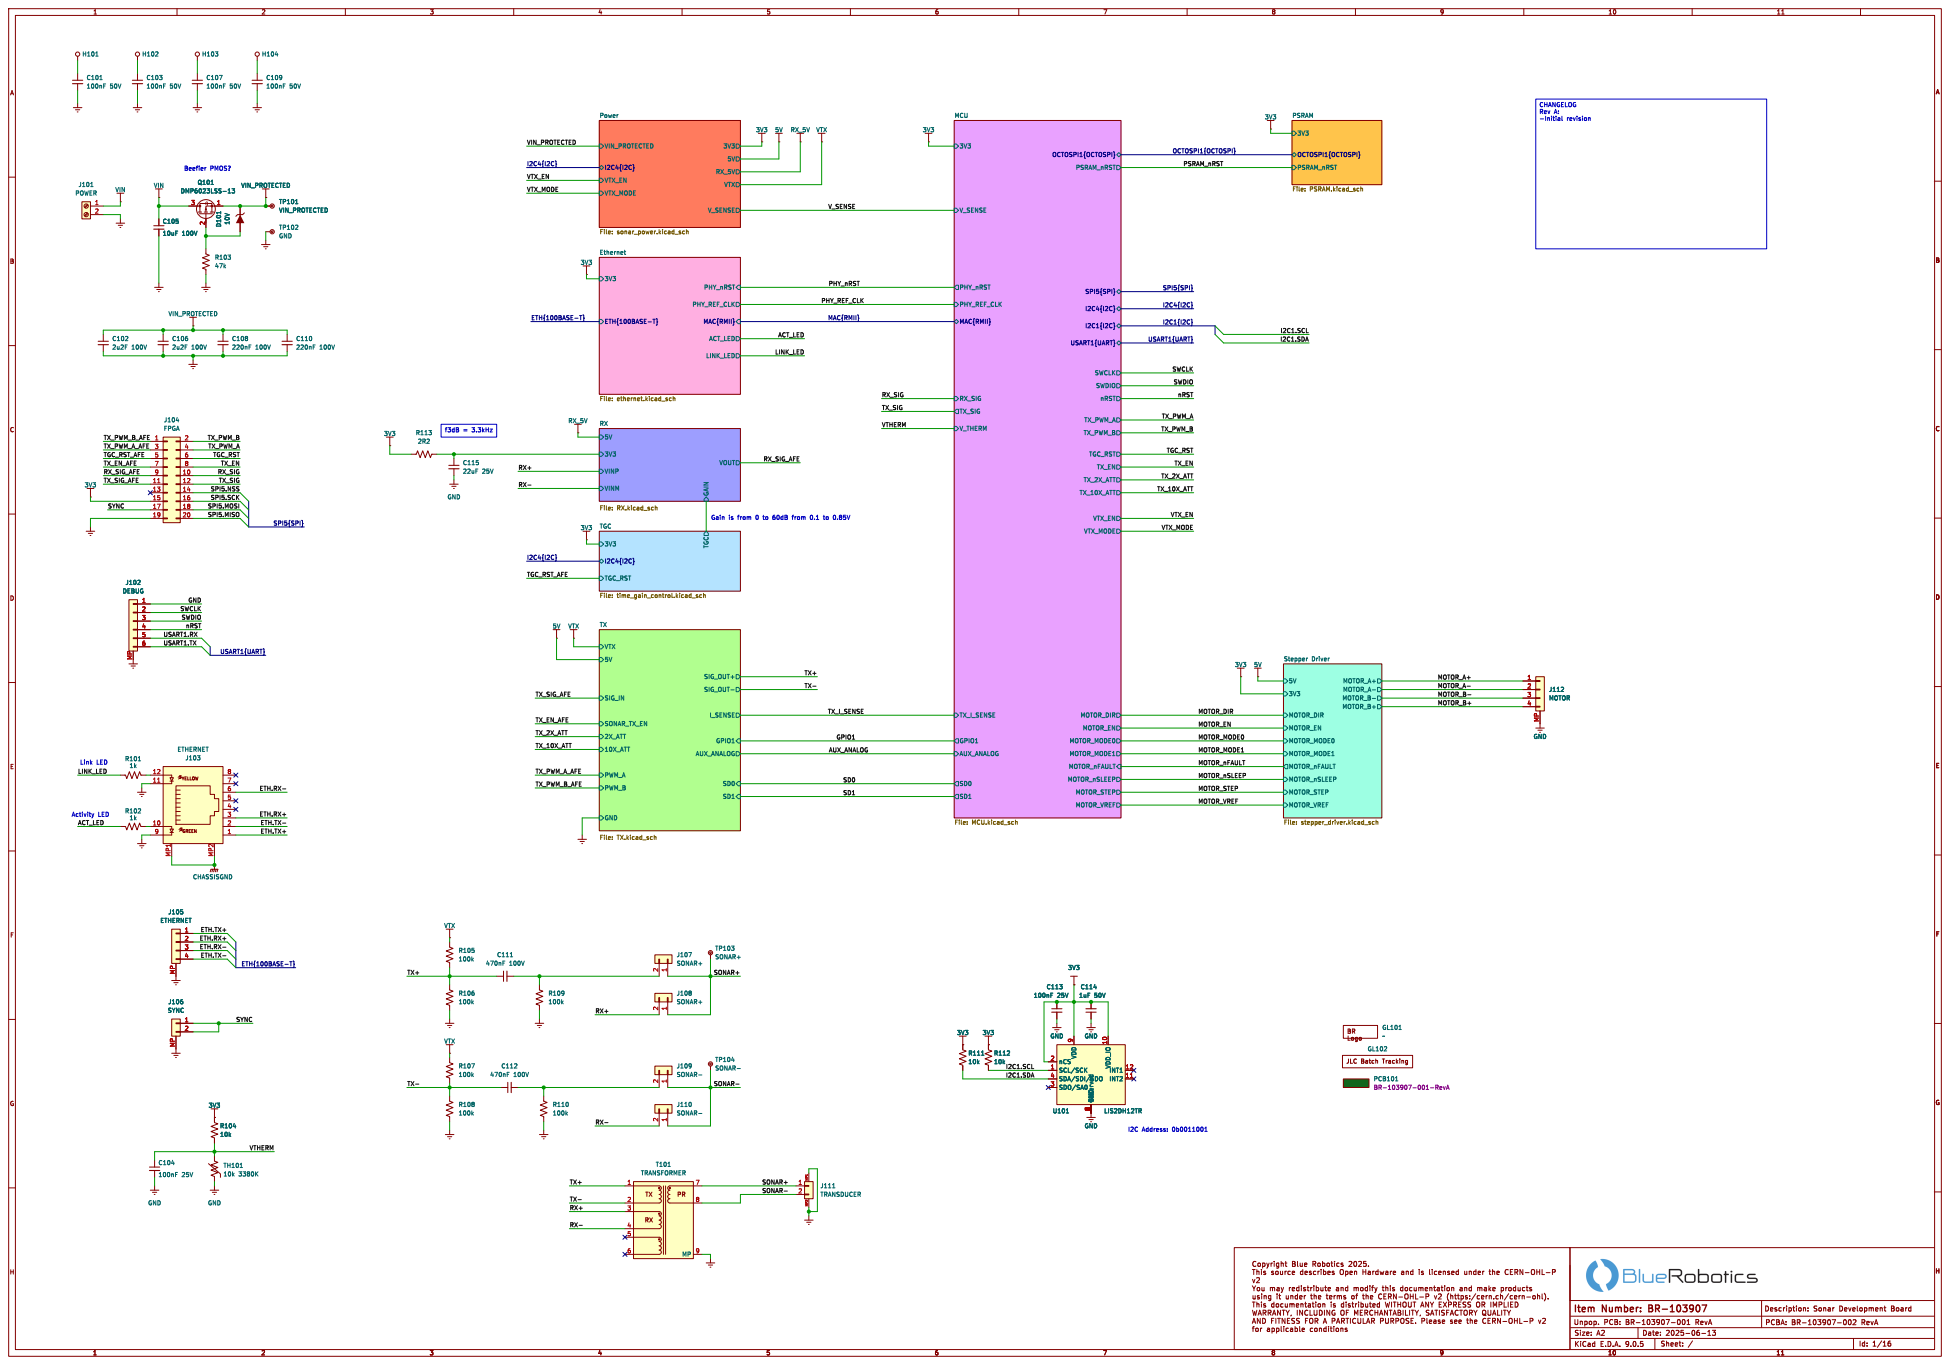
[picture p23: page 1]

File: PSRAM.kicad_sch OCTOSPI1{OCTOSPI} PSRAM_nRST SPI5{SPI}

JLC Batch Tracking GL102 BR

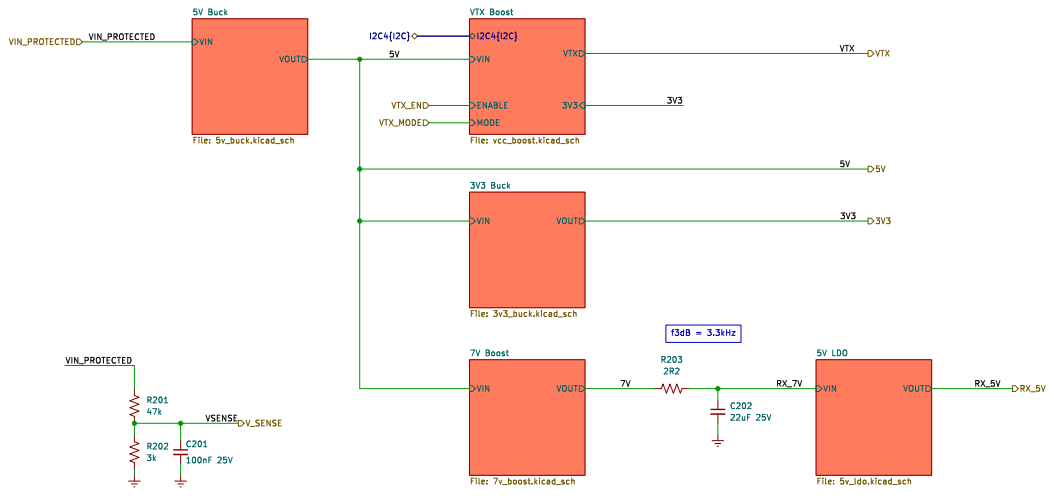
[picture p24: page 2]

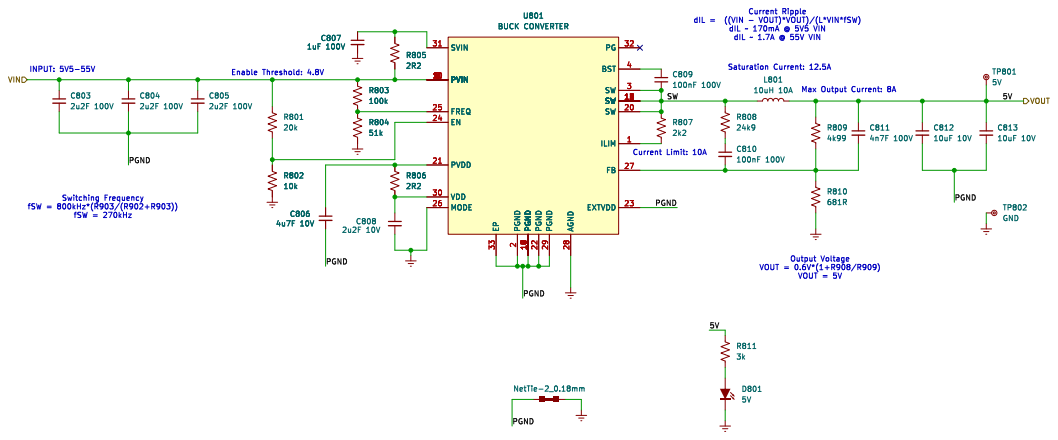
[picture p25: page 3]

dIL ~ 1.7A @ 55V VIN Output Voltage VOUT = 0.6V*(1+R908/R909) VOUT = 5V

2 PGND 16789 PGND 22 PGND 29 AGND 28 PG 32 BST 4 SW 3 SW 12345 SW 20

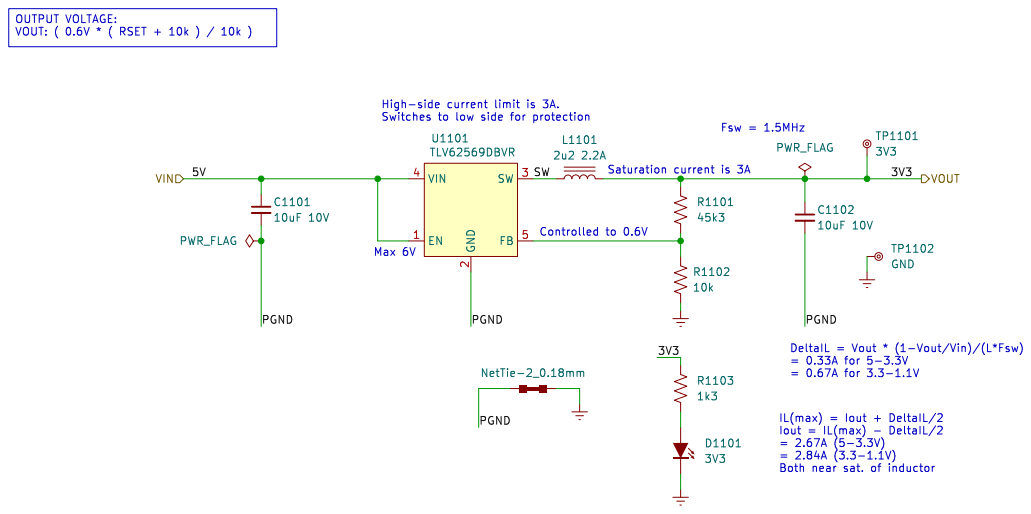
[picture p26: page 4]

IL(max) = Iout + DeltaIL/2

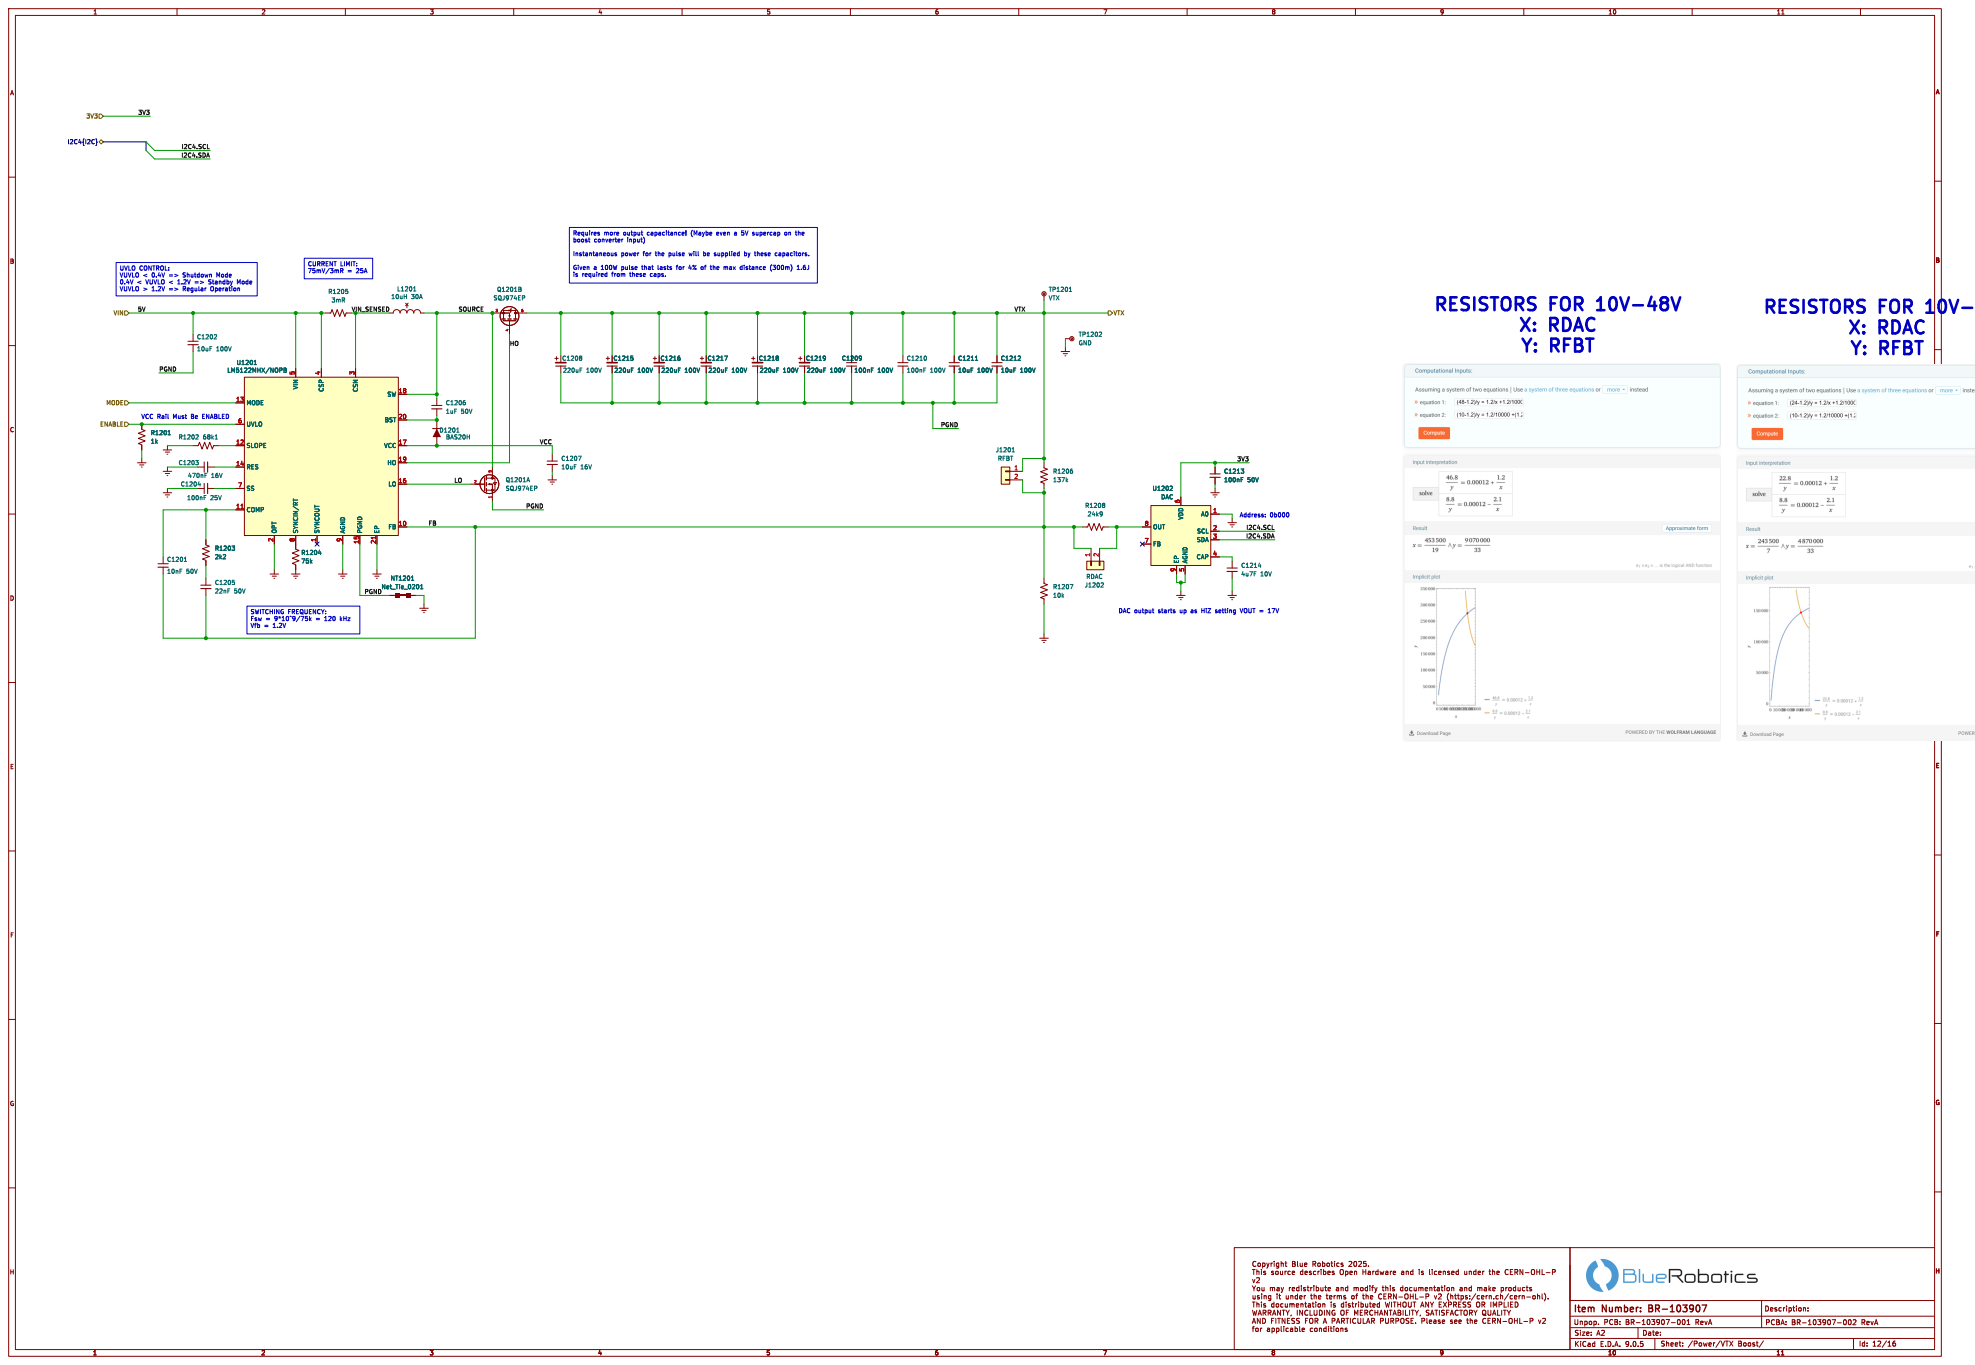
[picture p27: page 5]

3 PGND 15 EP 21 SW 18 BST 20 VCC 17 HO 19

VCC Rail Must Be ENABLED

DAC output starts up as HiZ setting VOUT = 17V U1202 DAC

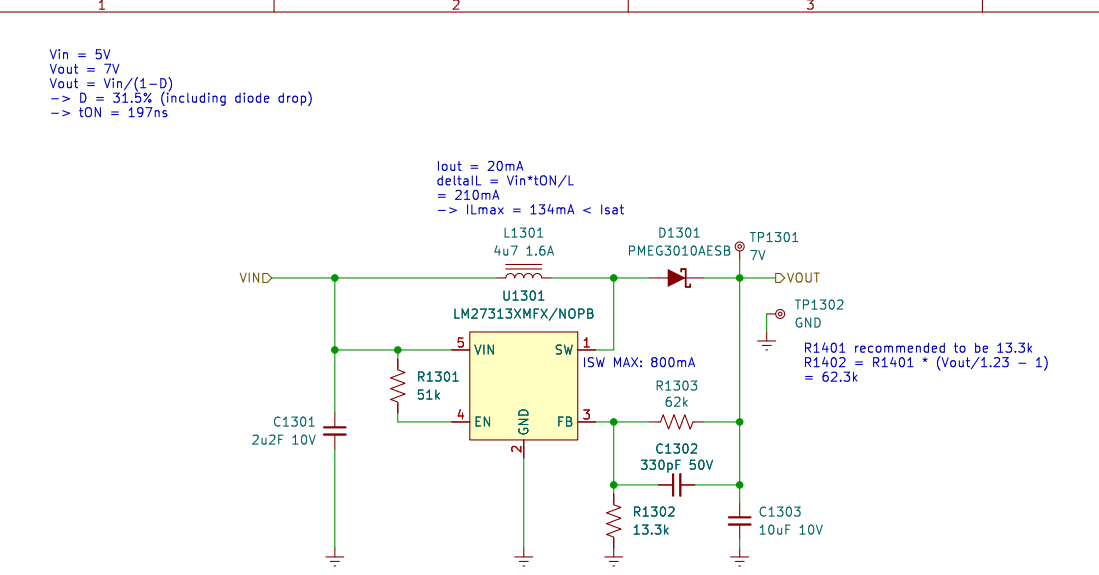
[picture p28: page 6]

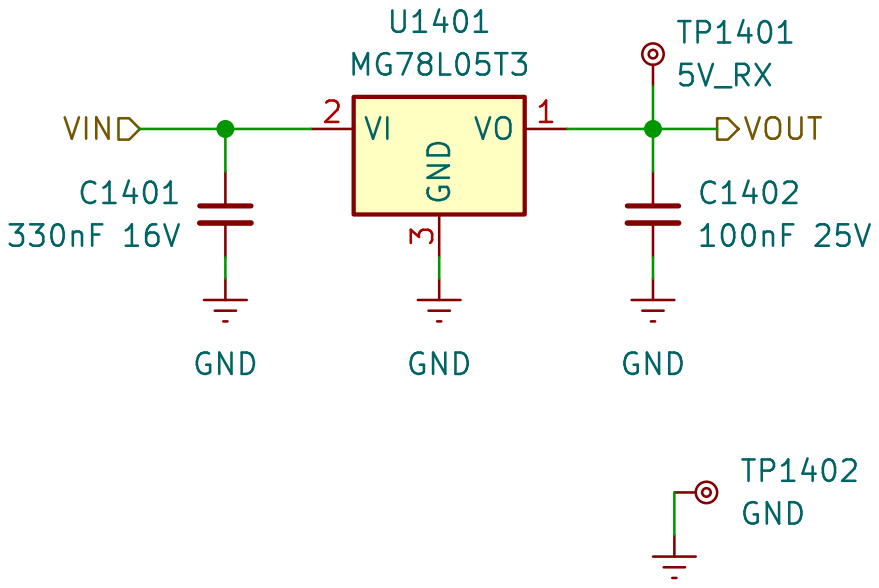
[picture p29: page 7]

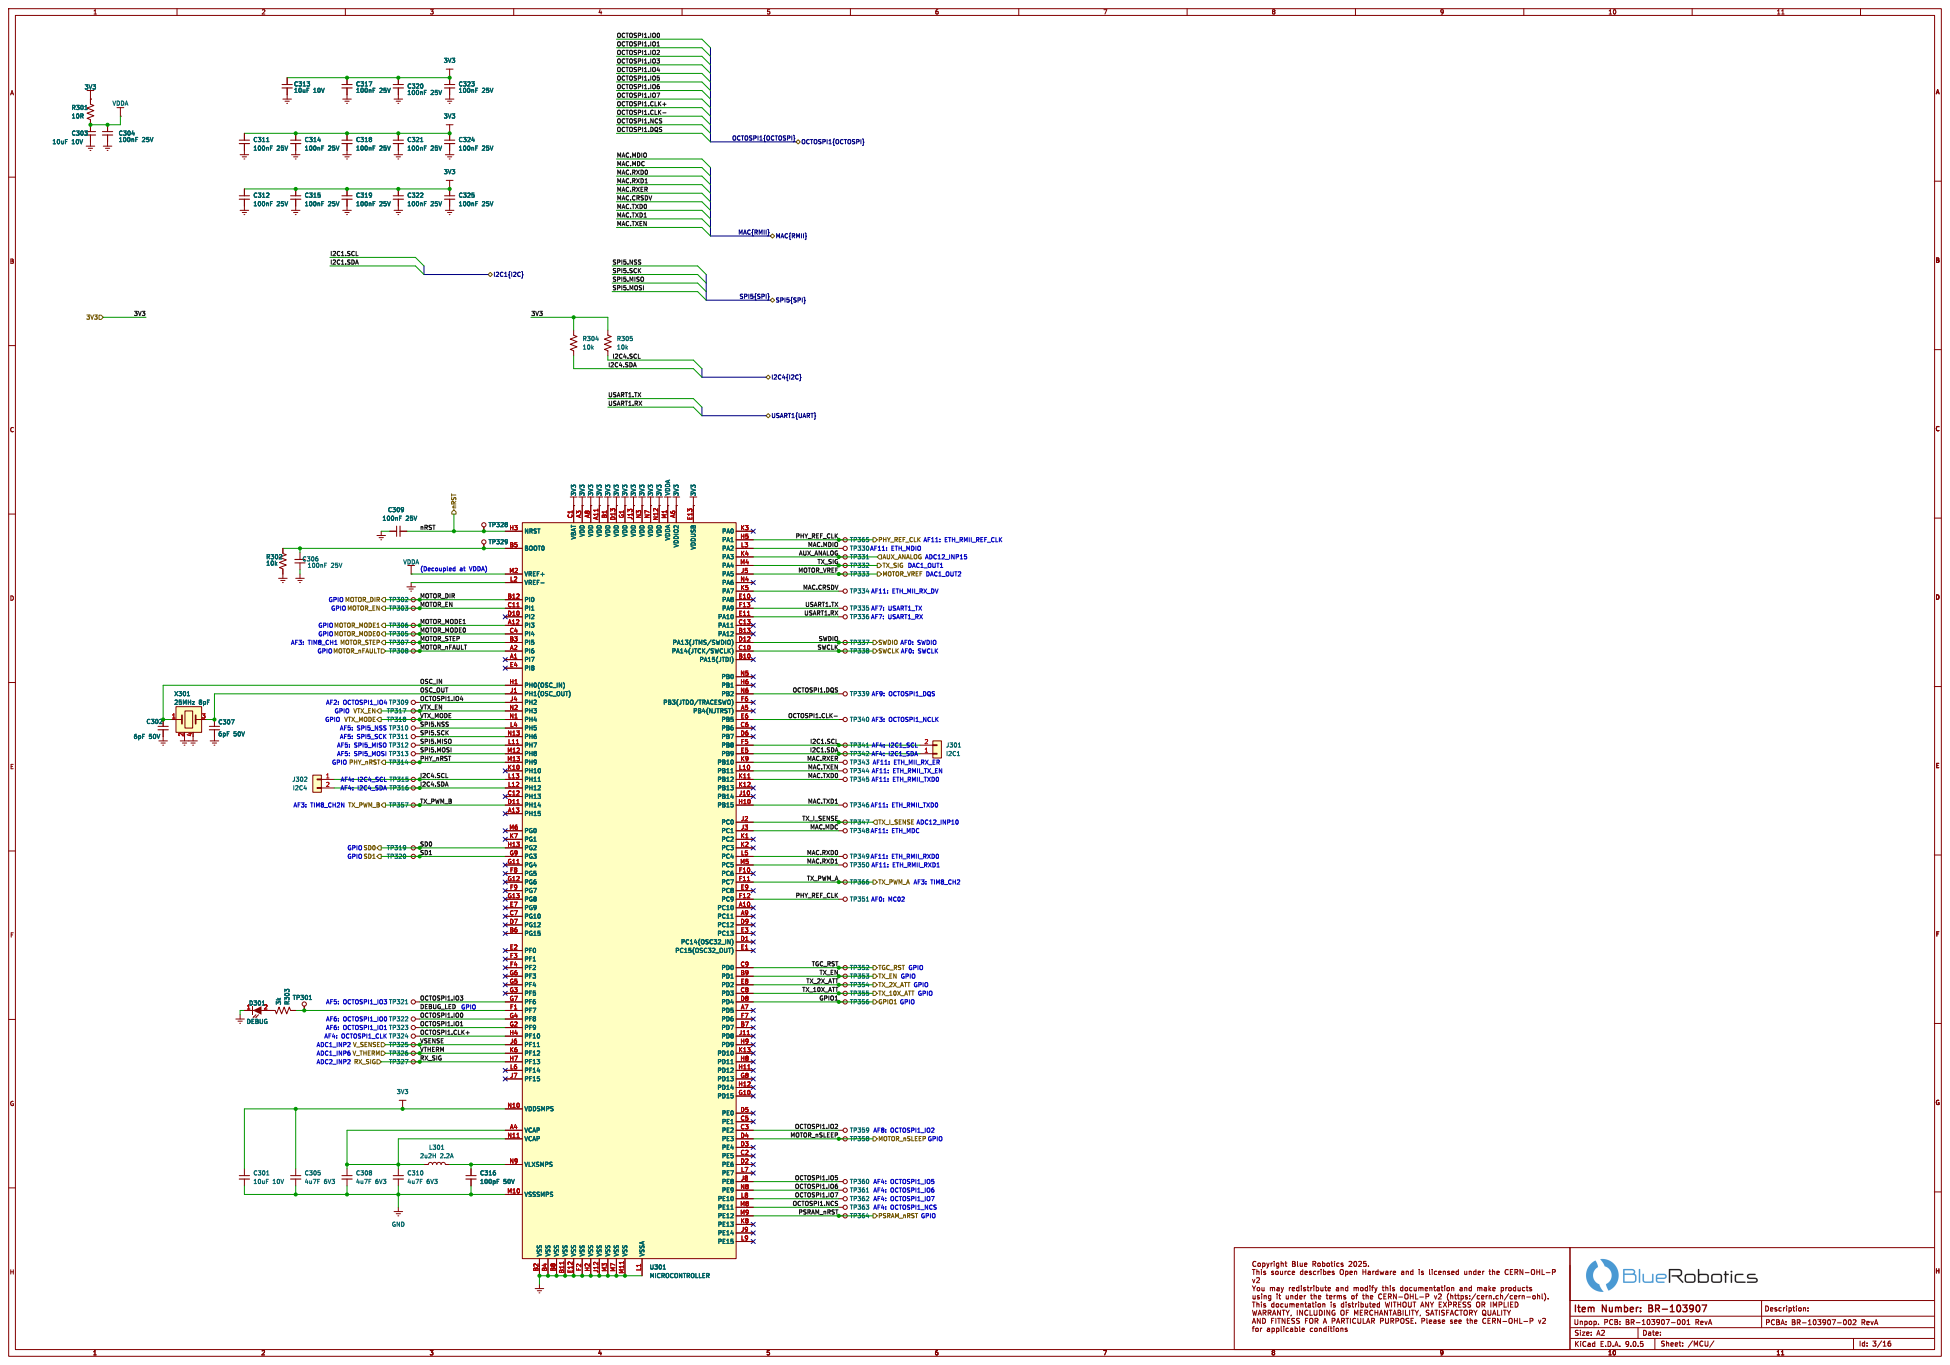
[picture p30: page 8]

MAC.MDIO MAC.RXD0 MAC.MDC OCTOSPI1.CLK- OCTOSPI1.DQS OCTOSPI1.CLK+ OCTOSPI1.NCS OCTOSPI1.IO7

MAC.RXD1
MAC.RXER MAC.CRSDV MAC.TXD0

PHY_REF_CLK
MAC.RXD0 USART1.TX MOTOR_VREF MAC.CRSDV
USART1.RX MAC.RXD1 MAC.RXER

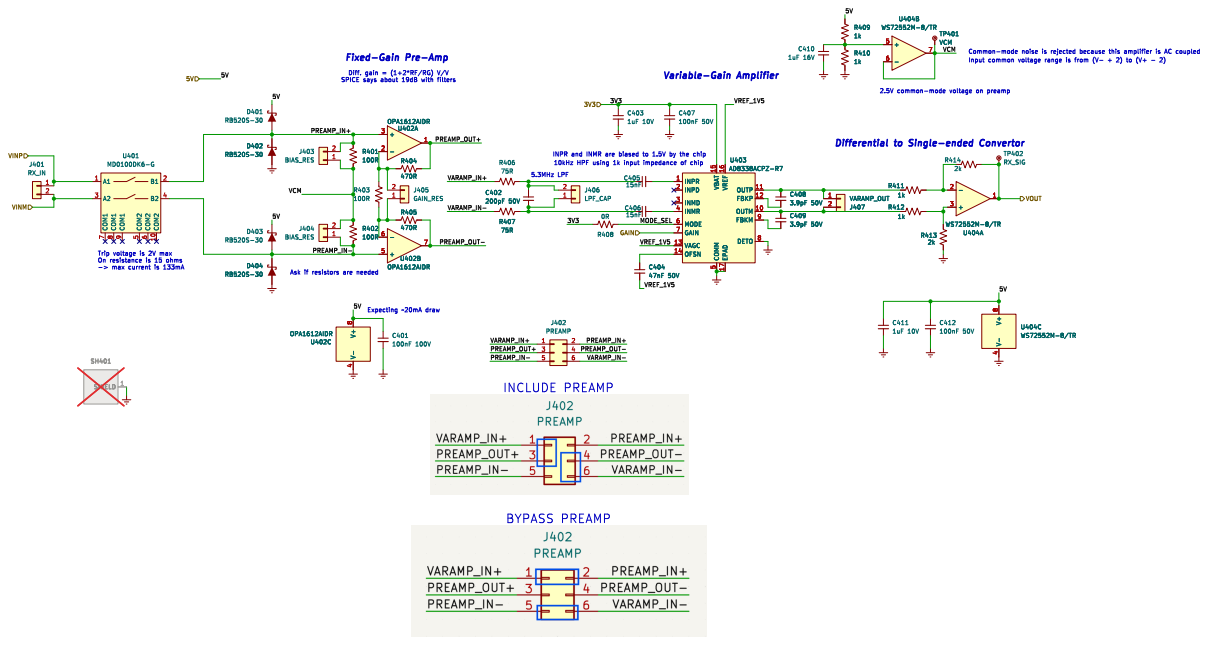
[picture p31: page 9]

5 VREF 16 EPAD 17 OUTP 11 FBKP 12 OUTM 10 FBKM 9 DETO 8 U403 AD8338ACPZ-R7 SHIELD 1 SH401 C412

INPR and INMR are biased to 1.5V by the chip

5 VREF 16 EPAD 17 OUTP 11 FBKP 12 OUTM 10 FBKM 9 DETO 8 C409

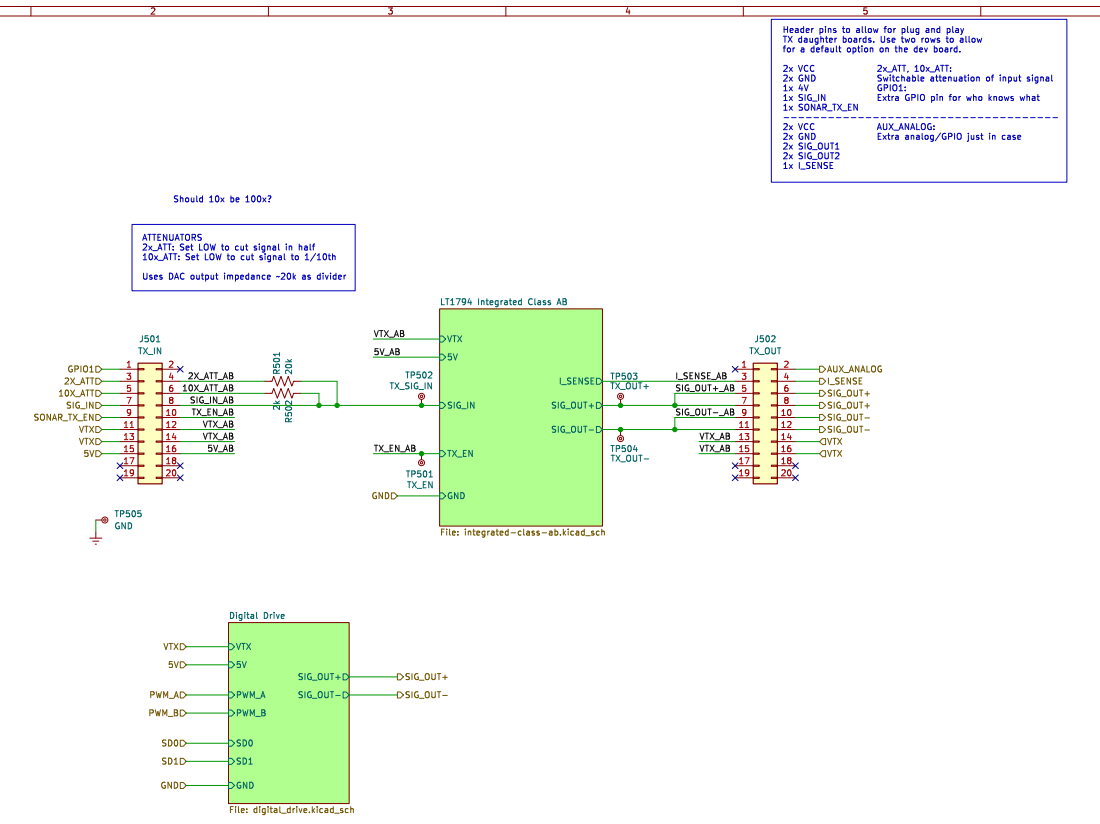
[picture p32: page 10]

File: integrated-class-ab.kicad_sch PWM_A

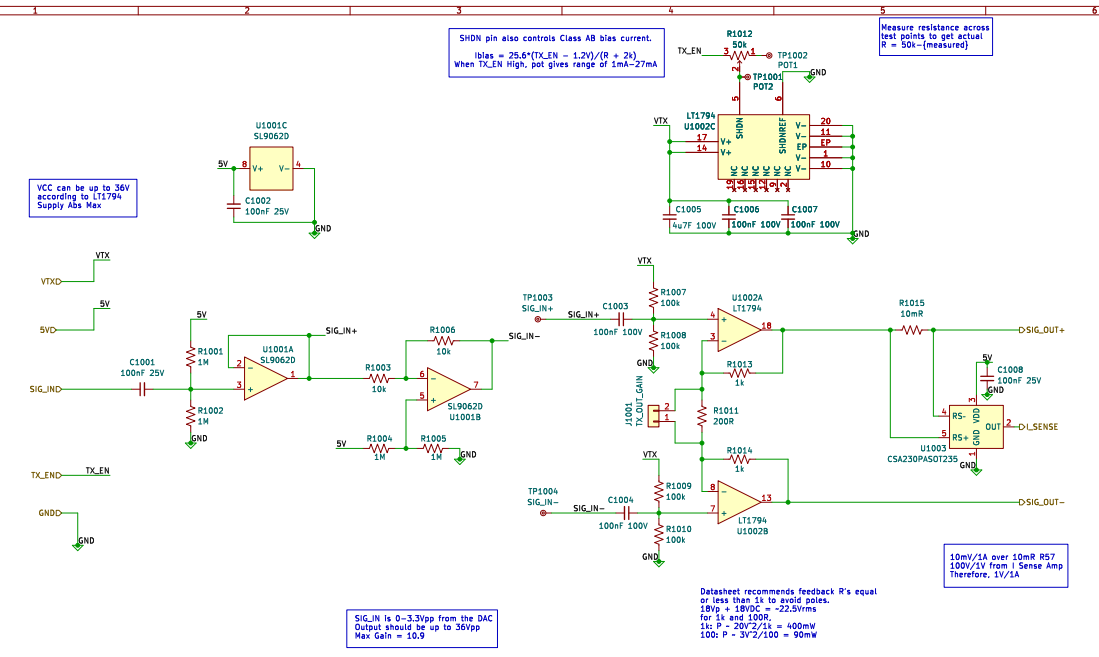
[picture p33: page 11]

test points to get actual R = 50k-{measured}
GND

VCC can be up to 36V

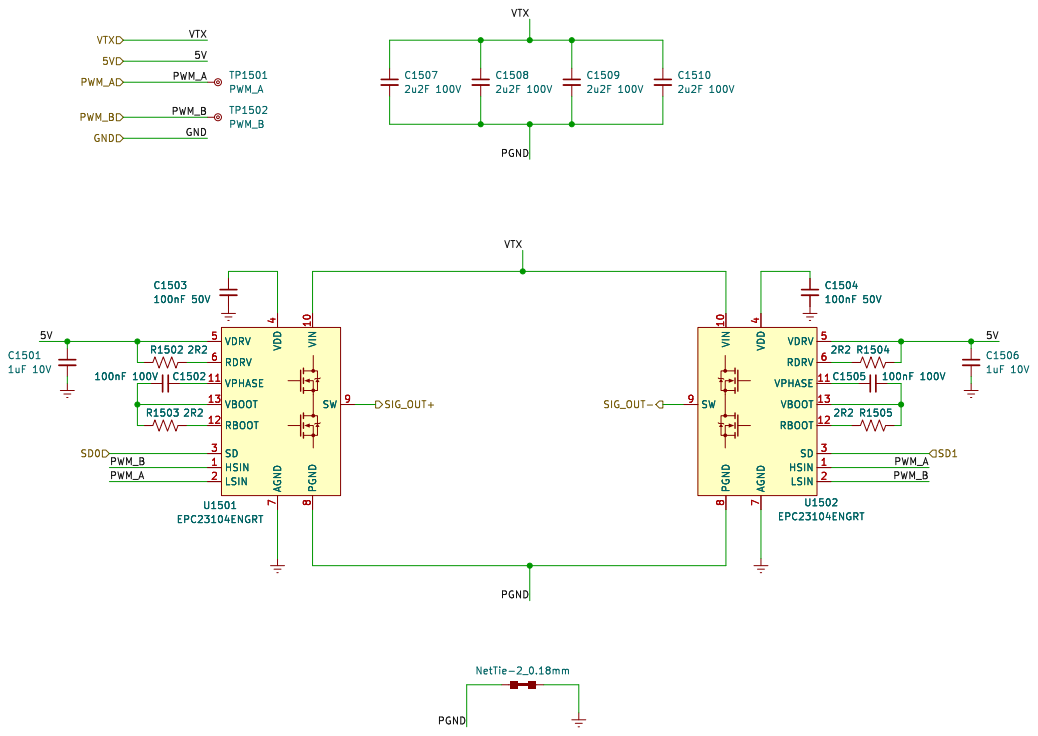
[picture p34: page 12]

VDRV 5 RDRV 6 VPHASE 11 VBOOT 13 RBOOT 12 SD 3 HSIN 1

2R2 R1504 U1501 EPC23104ENGRT VDRV 5 RDRV 6 VPHASE 11 VBOOT 13 RBOOT 12 SD 3 HSIN 1

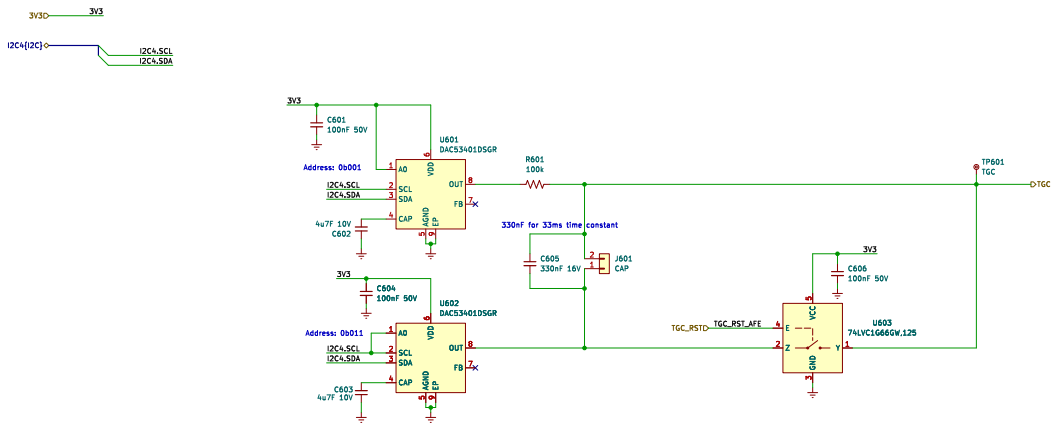
[picture p35: page 13]

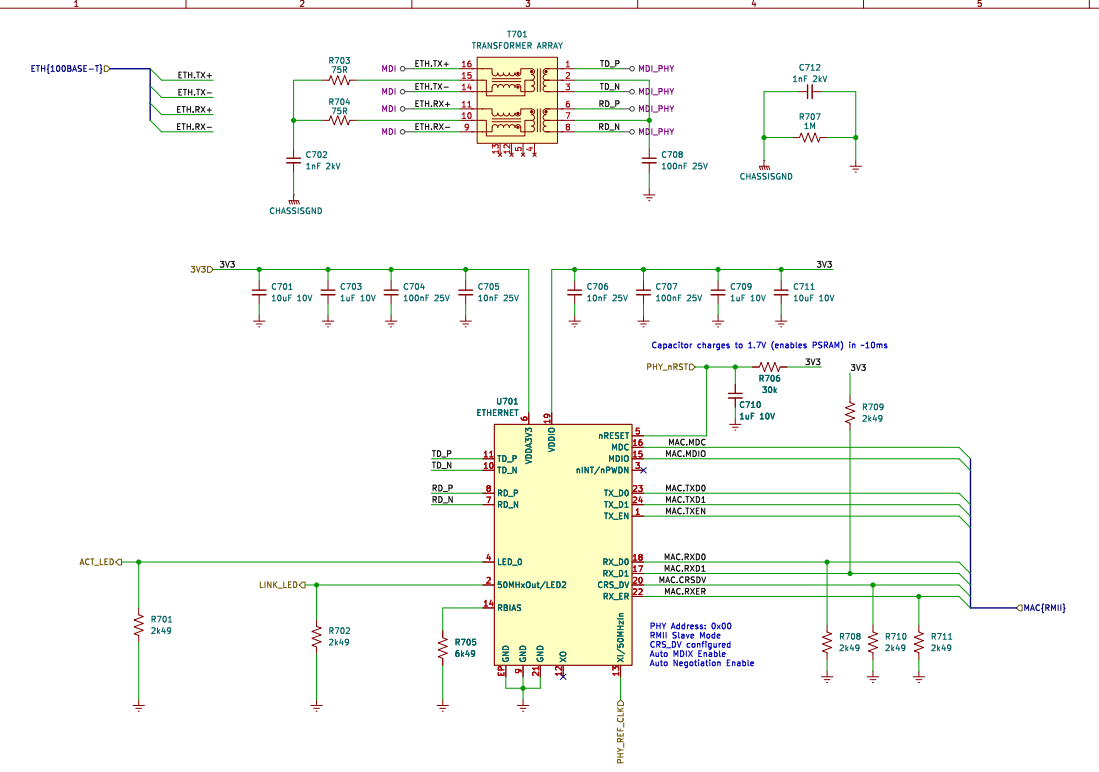
[picture p36: page 14]

ETH.TX+ ETH.TX- RD_P

3V3 MAC.TXD0 MAC.MDIO MAC.RXD1 MAC.RXER MAC.TXEN MAC.RXD0 MAC.CRSDV

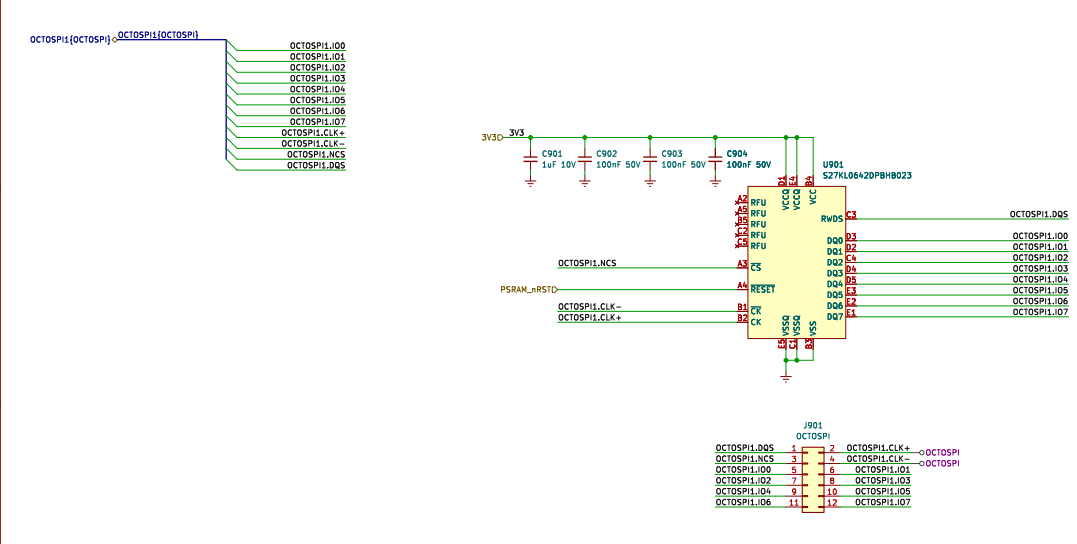
[picture p37: page 15]

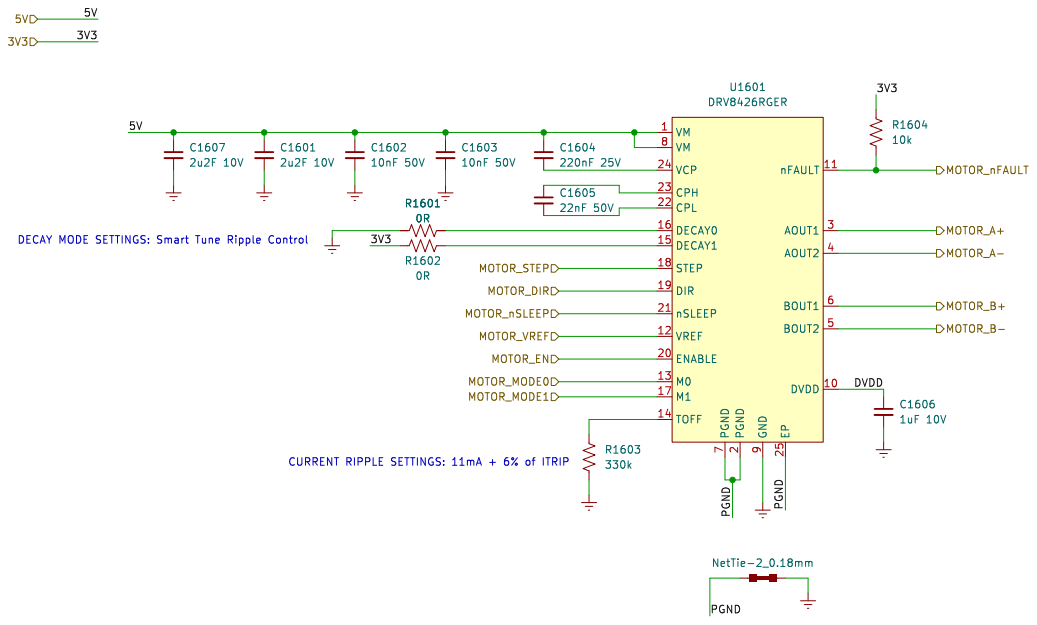
[picture p38: page 16]

10k VM 1 VM 8 VCP 24 CPH 23 CPL 22 DECAY0 16 DECAY1 15 STEP 18 DIR 19

DECAY MODE SETTINGS: Smart Tune Ripple Control CURRENT RIPPLE SETTINGS: 11mA + 6% of ITRIP R1601
