bluerobotics/ping-dev-kit/sims/RX sim rev i.asc

C1: cap; 10pF
C2: cap; 10µF
C3: cap; 10µF
C4: cap; 1nF
C5: cap; 1nF
C6: cap; 100pF
C7: cap; 100pF
C8: cap; 10pF
E1: e; 1
R1: res; 100
R2: res; 1k
R3: res; 500R
R4: res; 500R
R5: res; 470
R6: res; 470
R7: res; 1k
R8: res; 1k
R9: res; 1k
R10: res; 100
R11: res; 100
R12: res; 1k
R13: res; 1k
U1: ADA4898
U2: OPA1632
U3: ADA4898
V1: voltage; SINE(0 .01 100e3); AC 1
V2: voltage; ""; 1.5V
V3: voltage; ""; 10V
V4: voltage; ""; 5V
V5: voltage; PULSE(0 0.5 1e-3 1e-6 1e-6 5e-3 10e-3 4); AC 1
V6: voltage; SINE(0 .01 100e3); AC 1
V7: voltage; ""; 3.3V
Named nets: 0, Vout, VREF, VCC, VCC2, VAM, VAP, V3V3
;ac dec 20 10 10e6
.tran 100e-3
