bluerobotics/ping-dev-kit/sims/Draft2.asc

C1: cap; 200pF
C2: cap; 15nF
C3: cap; 15nF
R1: res; 75R
R2: res; 75R
R3: res; 500R
R4: res; 500R
R5: res; 1k
R6: res; 1k
V1: voltage; SINE(0 1 100e3)
Named nets: 0
.ac dec 20 10 10e6
