bluerobotics/ping-dev-kit/sims/Damping.asc

C1: cap; 20µF
E1: e; -1
E2: e; 1
Q1: npn; 2N3904
R1: res; 300R
R2: res; 10e3
R3: res; 10e3
R4: res; 3.3k
R5: res; 3.3k
R6: res; 300R
U1: FDC3601N
U2: FDC3601N
U3: FDC3601N
U4: FDC3601N
V1: voltage; SINE(0 18 1e6)
V2: voltage; 36V
V3: voltage; PULSE(3.3 0 2e-3 100e-9 100e-09 200e-6 1e-3)
V4: voltage; 20
V5: voltage; 18V
V6: voltage; 18
V7: voltage; 18
Named nets: 0, VTX, VHALF, VTRANS, VTRANS_N, VTRANS_P
.tran 100e-3
