bluerobotics/ping-dev-kit/(commit log)

2025-06-13 started this thang
    [MCU.kicad_sch, RX.kicad_sch, SonarDevBoard.kicad_pcb, SonarDevBoard.kicad_sch, TX.kicad_sch, sonar_power.kicad_sch]
2025-06-13 Created hierarchical sheets and porting some stuff in from Lumen
    [MCU.kicad_sch, RX.kicad_sch, SonarDevBoard.kicad_pcb, SonarDevBoard.kicad_sch, ethernet.kicad_sch, lumen2_3v3_buck.kicad_sch, sonar_power.kicad_sch, time_gain_control.kicad_sch]
2025-06-13 Added barebones ethernet stuff and connectors
    [MCU.kicad_sch, RX.kicad_sch, SonarDevBoard.kicad_sch, TX.kicad_sch, ethernet.kicad_sch, sonar_power.kicad_sch, time_gain_control.kicad_sch]
2025-06-14 Added some little bits and bops
    [MCU.kicad_sch, RX.kicad_sch, SonarDevBoard.kicad_pcb, SonarDevBoard.kicad_sch, TX.kicad_sch, ethernet.kicad_sch, sonar_power.kicad_sch, time_gain_control.kicad_sch]
2025-06-20 added PSRAM sheet
    [PSRAM.kicad_sch, SonarDevBoard.kicad_sch]
2025-06-20 OCTOSPI Pinout
    [MCU.kicad_sch, PSRAM.kicad_sch]
2025-06-26 Started RX path
    [MCU.kicad_sch, RX.kicad_sch, SonarDevBoard.kicad_sch]
2025-06-26 Added low-noise preamp symbol
    [RX.kicad_sch]
2025-06-28 added transformer + connector updates
    [MCU.kicad_sch, RX.kicad_sch, SonarDevBoard.kicad_sch]
2025-07-02 Started putting in preamp
    [RX.kicad_sch]
2025-07-02 added SPI bus
    [MCU.kicad_sch, RX.kicad_sch, SonarDevBoard.kicad_sch, TR_switch.kicad_sch]
2025-07-02 RX sheet first draft
    [RX.kicad_sch]
2025-07-02 added TR sheet
    [SonarDevBoard.kicad_sch, TR_switch.kicad_sch]
2025-07-02 VGA mode switch and TR switch sheet
    [RX.kicad_sch, TR_switch.kicad_sch]
2025-07-02 Added pins and colours to top-level sheets
    [RX.kicad_sch, SonarDevBoard.kicad_sch]
2025-07-03 power sheets
    [1v8_buck.kicad_sch, 3v3_buck.kicad_sch, 48v_boost.kicad_sch, 4v5_buck.kicad_sch, 5v_buck.kicad_sch, sonar_power.kicad_sch]
2025-07-03 power scheme
    [1v8_buck.kicad_sch, 3v3_buck.kicad_sch, 4v5_buck.kicad_sch, MCU.kicad_sch, RX.kicad_sch, SonarDevBoard.kicad_pcb, SonarDevBoard.kicad_sch, TR_switch.kicad_sch]
2025-07-03 edits to 4V buck
    [4v_buck.kicad_sch, sonar_power.kicad_sch]
2025-07-03 Rollback to 9cd79f4
    [RX.kicad_sch, TR_switch.kicad_sch]
2025-07-03 4v buck updates
    [4v_buck.kicad_sch]
2025-07-04 Added 7V boost subsheet
    [7v_boost.kicad_sch, RX.kicad_sch, sonar_power.kicad_sch]
2025-07-04 4v buck complete
    [4v_buck.kicad_sch]
2025-07-04 power scheme updates
    [4v_buck.kicad_sch, 5v_ldo.kicad_sch, sonar_power.kicad_sch]
2025-07-04 added annotations
    [4v_buck.kicad_sch]
2025-07-04 Removed TR switch sheet and brought it into the RX path sheet
    [5v_ldo.kicad_sch, RX.kicad_sch, SonarDevBoard.kicad_sch, TR_switch.kicad_sch]
2025-07-04 small changes
    [RX.kicad_sch]
2025-07-04 ripple injection updates
    [4v_buck.kicad_sch]
2025-07-05 Added integrated class ab
    [TX.kicad_sch, integrated-class-ab.kicad_sch]
2025-07-08 root updates
    [MCU.kicad_sch, SonarDevBoard.kicad_sch, time_gain_control.kicad_sch]
2025-07-08 push changes on computer
    [RX.kicad_sch]
2025-07-09 added TGC ADCs
    [MCU.kicad_sch, SonarDevBoard.kicad_sch, time_gain_control.kicad_sch]
2025-07-15 added sheet colours
    [SonarDevBoard.kicad_sch, sonar_power.kicad_sch]
2025-07-15 Added the pin headers to TX, working on a HV line driver design
    [TX.kicad_sch, integrated-class-ab.kicad_sch]
2025-07-16 power updates
    [4v_buck.kicad_sch, sonar_power.kicad_sch]
2025-07-16 Created DAC single-ended to double-ended pre stage for TX path
    [TX.kicad_sch, integrated-class-ab.kicad_sch]
2025-07-16 shit on a shit stick
    [TX.kicad_sch, integrated-class-ab.kicad_sch]
2025-07-18 Added some details to the RX path
    [RX.kicad_sch]
2025-07-22 Added current sense and shutdown/bias current pin control to LT1794 line driver
    [TX.kicad_sch, integrated-class-ab.kicad_sch]
2025-07-22 changed name of LT1794 hierarchical sheet
    [TX.kicad_sch]
2025-07-22 Tentatively finished with TX schematic
    [SonarDevBoard.kicad_sch, TX.kicad_sch]
2025-07-30 added TGC and started boost design
    [48v_boost.kicad_sch, SonarDevBoard.kicad_sch, sonar_power.kicad_sch, time_gain_control.kicad_sch]
2025-07-30 vcc boost progress
    [sonar_power.kicad_sch, vcc_boost.kicad_sch]
2025-08-06 various updates + digital drive sheet
    [PSRAM.kicad_sch, SonarDevBoard.kicad_sch, TX.kicad_sch, digital_drive.kicad_sch, sonar_power.kicad_sch, vcc_boost.kicad_sch]
2025-08-08 rewiring STM32H563
    [4v_buck.kicad_sch, MCU.kicad_sch, SonarDevBoard.kicad_sch, TX.kicad_sch, ethernet.kicad_sch, integrated-class-ab.kicad_sch, sonar_power.kicad_sch]
2025-08-09 a bunch of updates
    [5v_buck.kicad_sch, MCU.kicad_sch, PSRAM.kicad_sch, SonarDevBoard.kicad_sch, digital_drive.kicad_sch, sonar_power.kicad_sch, vcc_boost.kicad_sch]
2025-08-12 added rj45 and h-bridge + stm pinout spreadsheet
    [MCU.kicad_sch, PSRAM.kicad_sch, SonarDevBoard.kicad_sch, TX.kicad_sch, digital_drive.kicad_sch, ethernet.kicad_sch, sonar_dev_board_stm32h563_pinout.xlsx]
2025-08-13 added to STM pinout + boost fixes
    [MCU.kicad_sch, SonarDevBoard.kicad_sch, TX.kicad_sch, sonar_dev_board_stm32h563_pinout.xlsx, sonar_power.kicad_sch, time_gain_control.kicad_sch, vcc_boost.kicad_sch]
2025-08-13 more STM pins + VCC boost edits
    [MCU.kicad_sch, SonarDevBoard.kicad_sch, vcc_boost.kicad_sch]
2025-08-13 removed space
    [vcc_boost.kicad_sch]
2025-08-13 updated inductor
    [vcc_boost.kicad_sch]
2025-08-16 finished modifying vcc for sonar + 7V boost updates
    [7v_boost.kicad_sch, sonar_dev_board_stm32h563_pinout.xlsx, vcc_boost.kicad_sch]
2025-08-21 implementing feedback + added stepper driver
    [3v3_buck.kicad_sch, 5v_buck.kicad_sch, 7v_boost.kicad_sch, MCU.kicad_sch, PSRAM.kicad_sch, RX.kicad_sch, SonarDevBoard.kicad_sch, digital_drive.kicad_sch]
2025-08-21 completed feedback from review + reannotated sheets
    [3v3_buck.kicad_sch, 4v5_buck.kicad_sch, 4v_buck.kicad_sch, 5v_buck.kicad_sch, 5v_ldo.kicad_sch, 7v_boost.kicad_sch, MCU.kicad_sch, PSRAM.kicad_sch]
2025-08-25 layout start
    [RX.kicad_sch, SonarDevBoard.kicad_pcb, SonarDevBoard.kicad_sch, digital_drive.kicad_sch, integrated-class-ab.kicad_sch, stepper_driver.kicad_sch]
2025-08-25 updated sonar pinout
    [sonar_dev_board_stm32h563_pinout.xlsx]
2025-08-25 minor schematic updates + subcircuit layout
    [5v_buck.kicad_sch, RX.kicad_sch, SonarDevBoard.kicad_pcb, SonarDevBoard.kicad_sch, stepper_driver.kicad_sch]
2025-08-27 modified SD feature
    [TX.kicad_sch, digital_drive.kicad_sch]
2025-08-27 Start 5V buck layout
    [SonarDevBoard.kicad_pcb]
2025-08-28 Lay out 5V buck converter
    [SonarDevBoard.kicad_pcb]
2025-08-28 Lay out 3V3 buck, 7V boost, and 5V LDO
    [SonarDevBoard.kicad_pcb]
2025-08-28 Finish VCC boost layout, realize that not enough power can be delivered to it
    [SonarDevBoard.kicad_pcb, vcc_boost.kicad_sch]
2025-08-28 Make a note that more output capacitance is required
    [SonarDevBoard.kicad_pcb, vcc_boost.kicad_sch]
2025-08-28 Finish VCC boost before adding more output capacitance
    [SonarDevBoard.kicad_pcb]
2025-08-29 Update power layout positions
    [5v_buck.kicad_sch, SonarDevBoard.kicad_pcb, digital_drive.kicad_sch, vcc_boost.kicad_sch]
2025-08-29 Move layouts to new project
    [1v8_buck.kicad_sch, 3v3_buck.kicad_sch, 48v_boost.kicad_sch, 5v_buck.kicad_sch, 5v_ldo.kicad_sch, 7v_boost.kicad_sch, MCU.kicad_sch, PSRAM.kicad_sch]
2025-08-29 Restore previous base PCB state to commit 87dd840
    [5v_buck.kicad_sch, SonarDevBoard.kicad_pcb, digital_drive.kicad_sch, vcc_boost.kicad_sch]
2025-08-29 Add more VCC boost output capacitance
    [TX.kicad_sch, sonar-dev-board-power-layouts.kicad_pcb, sonar-dev-board-power-layouts.kicad_sch, sonar_power.kicad_sch, vcc_boost.kicad_sch]
2025-08-29 Clean up silkscreen on power layouts
    [5v_buck.kicad_sch, sonar-dev-board-power-layouts.kicad_pcb]
2025-08-30 Make net ties bigger
    [3v3_buck.kicad_sch, 5v_buck.kicad_sch]
2025-09-05 Updated license
    [3v3_buck.kicad_sch, 5v_buck.kicad_sch, 5v_ldo.kicad_sch, 7v_boost.kicad_sch, MCU.kicad_sch, PSRAM.kicad_sch, RX.kicad_sch, SonarDevBoard.kicad_pcb]
2025-09-05 added copyright notice to more stuff
    [3v3_buck.kicad_sch, 5v_buck.kicad_sch, 5v_ldo.kicad_sch, 7v_boost.kicad_sch, MCU.kicad_sch, PSRAM.kicad_sch, RX.kicad_sch, TX.kicad_sch]
2025-09-05 updated project name
    [PingDevKit.kicad_pcb, PingDevKit.kicad_sch]
2025-09-05 renamed file
    [ping_dev_kit_stm32h563_pinout.xlsx]
2025-09-15 subcircuit layout + minor schematic updates
    [PSRAM.kicad_sch, PingDevKit.kicad_pcb, PingDevKit.kicad_sch, RX.kicad_sch, TX.kicad_sch, digital_drive.kicad_sch, sonar_power.kicad_sch, vcc_boost.kicad_sch]
2025-09-20 started BGA fanout
    [PingDevKit.kicad_pcb]
2025-09-23 BGA fanout + added SMPS layout
    [PSRAM.kicad_sch, PingDevKit.kicad_pcb]
2025-09-23 removed text of doom
    [sonar-dev-board-power-layouts.kicad_pcb]
2025-09-26 changed layout of pcbs to be more distinct
    [digital_drive.kicad_sch, sonar-dev-board-power-layouts.kicad_pcb]
2025-09-29 added RF Shield
    [PingDevKit.kicad_pcb, RX.kicad_sch, sonar-dev-board-power-layouts.kicad_pcb]
2025-09-29 bga fan out + stepper motor routing
    [PingDevKit.kicad_pcb]
2025-10-01 bga fanout
    [PingDevKit.kicad_pcb]
2025-10-06 ethernet MDI routing
    [MCU.kicad_sch, PingDevKit.kicad_pcb, PingDevKit.kicad_sch]
2025-10-22 added net tie to stepper motor PGND + various routing
    [3v3_buck.kicad_sch, MCU.kicad_sch, PingDevKit.kicad_pcb, stepper_driver.kicad_sch]
2025-10-29 New board shape
    [sonar-dev-board-power-layouts.kicad_pcb]
2025-11-03 bigger board outline + initial integration placements
    [PingDevKit.kicad_pcb, PingDevKit.kicad_sch, sonar-dev-board-power-layouts.kicad_pcb]
2025-11-04 adding test pads + minor schematic edits
    [3v3_buck.kicad_sch, 5v_buck.kicad_sch, 5v_ldo.kicad_sch, 7v_boost.kicad_sch, MCU.kicad_sch, PingDevKit.kicad_pcb, PingDevKit.kicad_sch, time_gain_control.kicad_sch]
2025-11-05 more test points+ routing improvements
    [MCU.kicad_sch, PingDevKit.kicad_pcb, PingDevKit.kicad_sch, TX.kicad_sch, digital_drive.kicad_sch, integrated-class-ab.kicad_sch]
2025-11-05 some moving around
    [PingDevKit.kicad_pcb, PingDevKit.kicad_sch]
2025-11-06 more routing
    [PingDevKit.kicad_pcb]
2025-11-07 beluga added
    [sonar-dev-board-power-layouts.kicad_pcb]
2025-11-11 new board stackup + routing
    [MCU.kicad_sch, PingDevKit.kicad_pcb, PingDevKit.kicad_sch]
2025-11-12 updating power routing
    [sonar-dev-board-power-layouts.kicad_pcb]
2025-11-13 preboard review of updates
    [3v3_buck.kicad_sch, 5v_buck.kicad_sch, MCU.kicad_sch, PingDevKit.kicad_sch, TX.kicad_sch, digital_drive.kicad_sch, stepper_driver.kicad_sch]
2025-11-17 various improvements
    [3v3_buck.kicad_sch, 5v_buck.kicad_sch, MCU.kicad_sch, PingDevKit.kicad_sch, RX.kicad_sch, TX.kicad_sch, digital_drive.kicad_sch, integrated-class-ab.kicad_sch]
2025-11-17 duplicate of PingDevKit
    [sonar-dev-board-power-layouts.kicad_pcb]
2025-11-24 Revert "duplicate of PingDevKit"
    This reverts commit 192b7454a51dc297e0712579339c9a67bb3b37a1.
    [sonar-dev-board-power-layouts.kicad_pcb]
2025-11-24 new copy project
    [sonar-dev-board-power-layouts.kicad_pcb]
2025-11-25 added RC filters on RX power + new TIM8 pins
    [MCU.kicad_sch, PingDevKit.kicad_sch, digital_drive.kicad_sch, sonar_power.kicad_sch, time_gain_control.kicad_sch]
2025-11-25 (ethernet) trace edits
2025-11-30 working through DRCs
    [MCU.kicad_sch, ethernet.kicad_sch, time_gain_control.kicad_sch]
2025-12-03 clarified silkscreen labels
    [5v_buck.kicad_sch, MCU.kicad_sch, ethernet.kicad_sch, vcc_boost.kicad_sch]
2025-12-04 more silkscreen labels
2025-12-04 silkscreen edits
2025-12-08 last checks + board characteristics tables
    [3v3_buck.kicad_sch, 5v_buck.kicad_sch, 5v_ldo.kicad_sch, 7v_boost.kicad_sch, MCU.kicad_sch, PSRAM.kicad_sch, PingDevKit.kicad_sch, RX.kicad_sch]
2025-12-08 Rev A release files
    [3v3_buck.kicad_sch, 5v_buck.kicad_sch, 5v_ldo.kicad_sch, 7v_boost.kicad_sch, MCU.kicad_sch, PSRAM.kicad_sch, PingDevKit JLC BOM.csv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]
2025-12-17 fixing JLC rules
    [PSRAM.kicad_sch, PingDevKit.kicad_sch, RX.kicad_sch]
2025-12-18 refactoring tx a bit
    [3v3_buck.kicad_sch, PSRAM.kicad_sch, PingDevKit.kicad_sch, TX.kicad_sch, integrated-class-ab.kicad_sch, stepper_driver.kicad_sch, vcc_boost.kicad_sch]
2025-12-18 Various changes to TX connectity
    [PingDevKit.kicad_sch, TX.kicad_sch, vcc_boost.kicad_sch]
2025-12-18 some tweaks
    [PingDevKit.kicad_sch]
2025-12-19 some last minute tidy up
    [MCU.kicad_sch, PSRAM.kicad_sch, PingDevKit.kicad_sch]
2025-12-19 getting ready for order
    [PingDevKit JLC BOM.csv, PingDevKit Odoo BOM.xlsx, PingDevKit Stock Info.xlsx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]
2025-12-19 fixed DAC mistake
    [PingDevKit JLC BOM.csv, PingDevKit Odoo BOM.xlsx, PingDevKit Stock Info.xlsx, time_gain_control.kicad_sch, vcc_boost.kicad_sch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]
2025-12-19 More updates
    [PingDevKit Odoo BOM.xlsx, PingDevKit Stock Info.xlsx]
2025-12-27 starting to fix dp83825
    [ethernet.kicad_sch]
2025-12-29 rev C outputs
    [PingDevKit Odoo BOM.xlsx, PingDevKit Stock Info.xlsx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]
2025-12-29 Update PingDevKit JLC BOM.csv
    [PingDevKit JLC BOM.csv]
2025-12-30 updates to pinout spreadsheet
    [MCU.kicad_sch, ping_dev_kit_stm32h563_pinout.xlsx]
2026-04-02 Adding next rev todos
    upreved to rev D and adding a rev block to indicate what to change for next time
    [3v3_buck.kicad_sch, 5v_buck.kicad_sch, 5v_ldo.kicad_sch, 7v_boost.kicad_sch, MCU.kicad_sch, PSRAM.kicad_sch, PingDevKit.kicad_sch, RX.kicad_sch]
2026-07-29 starting to incorporate todos
    [3v3_buck.kicad_sch, 5v_buck.kicad_sch, 5v_ldo.kicad_sch, 7v_boost.kicad_sch, MCU.kicad_sch, PSRAM.kicad_sch, PingDevKit.kicad_sch, RX.kicad_sch]
2026-07-31 switching dcdc
    [3v3_buck.kicad_sch, 5v_buck.kicad_sch, vcc_boost.kicad_sch]
2026-08-05 slight tweaks
    [MCU.kicad_sch, PingDevKit.kicad_sch]
2026-08-18 more work
    [PingDevKit.kicad_sch, digital_drive.kicad_sch, integrated-class-ab.kicad_sch]
2026-08-20 refactoring interconnects to simplify busses
    [MCU.kicad_sch, PingDevKit.kicad_sch, RX.kicad_sch, TX.kicad_sch, digital_drive.kicad_sch, integrated-class-ab.kicad_sch, time_gain_control.kicad_sch]
2026-08-20 more tweaks
    [PingDevKit.kicad_sch]
2026-08-26 sim of variable gain input
    [RX.kicad_sch]
2026-08-27 various sims to get rx right
    [RX.kicad_sch]
2026-09-02 yet more
    [vcc_boost.kicad_sch]
2026-09-03 missed a save
    [5v_buck.kicad_sch]
2026-09-03 updated pinout sheet
    [ping_dev_kit_stm32h563_pinout.xlsx]
2026-09-04 fixing some errors
    [5v_buck.kicad_sch, MCU.kicad_sch, PingDevKit Stock Info.xlsx, PingDevKit.kicad_pcb, PingDevKit.kicad_sch, RX.kicad_sch, TX.kicad_sch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]
2026-09-04 getting really close to final
    [3v3_buck.kicad_sch, 5v_buck.kicad_sch, MCU.kicad_sch, PingDevKit.kicad_pcb, PingDevKit.kicad_sch, RX.kicad_sch, TX.kicad_sch, ethernet.kicad_sch]
2026-09-05 working on fixing bug
    [PingDevKit.kicad_pcb, PingDevKit.kicad_sch, TX.kicad_sch, integrated-class-ab.kicad_sch]
2026-09-08 made outline 1mm smaller in all directions
    [PingDevKit.kicad_pcb, sonar_power.kicad_sch]
2026-09-08 addressed all new DRC errors and warnings
    [PingDevKit.kicad_pcb]
2026-09-09 more cleanup
    [MCU.kicad_sch, PingDevKit.kicad_pcb, PingDevKit.kicad_sch, RX.kicad_sch, ping_dev_kit_stm32h563_pinout.xlsx, time_gain_control.kicad_sch, vcc_boost.kicad_sch]
2026-09-09 some final changes to rx stage
    [PingDevKit.kicad_pcb, RX.kicad_sch, TX.kicad_sch, sonar_power.kicad_sch]
2026-09-09 updated copyright year
    [PingDevKit.kicad_sch]
2026-09-09 clearing ERC errors and some ref des tidy up
    [MCU.kicad_sch, PingDevKit.kicad_pcb, PingDevKit.kicad_sch, TX.kicad_sch, vrx_boost.kicad_sch]
2026-09-11 final checks before sending for order
    [MCU.kicad_sch, PingDevKit JLC BOM.csv, PingDevKit Odoo BOM.xlsx, PingDevKit Stock Info.xlsx, PingDevKit.kicad_pcb, RX.kicad_sch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]
2026-09-11 change via settings
    [PingDevKit.kicad_pcb, PingDevKit.kicad_sch]
